Sonoscopia/Phobos/README.md

# PHOBOS
Code and instructional content.
Homepage is [here](https://sonoscopia.pt/en/works/phobos/) 

## Description
Phobos is a set of small robots and automatic music generation devices that form a Dysfunctional Robotic Orchestra, an orchestra with strange instruments with defects, genetic mutations and erratic behaviors.

Phobos represents a critique of the technological overlapping over human thought, the function of labor and modern forms of slavery, as well as an historical retrospective of the various attempts of human liberation through machines, its technological utopias, the advances and retreats of freedoms. Its name comes from Greek mythology, where Phobos is the incarnation of fear, and is also the name of the largest moon of Mars, doomed to disappear due to the proximity of its orbit to the planet. 

## Credits
- Conception and artistic direction: Gustavo Costa 
- New instruments by: Henrique Fernandes, Gustavo Costa, Alberto Lopes
- Guest musicians and instrument builders: Thierry Madiot, Vincent Martial and Hanna Hartman
- Programming and robotics: Tiago Ângelo and João Menezes
- Composition: Carlos Guedes, Rui Dias and José Alberto Gomes
- Cenography: Igor Gandra (Teatro de Ferro)
- Video: Miguel C. Tavares
- Executive production: Patrícia Caveiro
- Production: Sonoscopia
- Technical assistance: Digitópia
- Logistic support: Teatro de Ferro
- Project funded by Republica Portuguesa / Cultura and DGArtes
- Partners: GNRation, NYU Abu Dhabi, CCVF, Centro Cultural de Ílhavo and Festival Bons Sons

## LICENSE
[][cc-by-nc]

This work is licensed under a
[Creative Commons Attribution-NonCommercial 4.0 International License][cc-by-nc].

[][cc-by-nc]

[cc-by-nc]: https://creativecommons.org/licenses/by-nc/4.0/
[cc-by-nc-image]: https://licensebuttons.net/l/by-nc/4.0/88x31.png
[cc-by-nc-shield]: https://img.shields.io/badge/License-CC%20BY--NC%204.0-lightgrey.svg
