Sonoscopia/Phobos/Docs/MIDI&PWR connections.pdf

1 - 12Va
12VL - 3 | 2 - GND

5Vm - 4

# POWER

# MIDI (XLR)

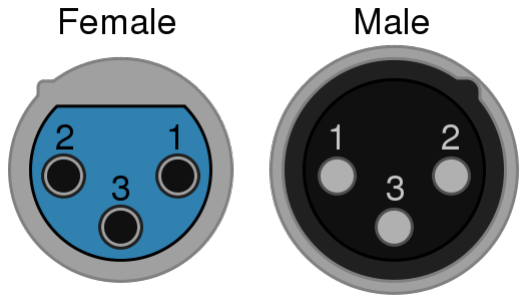
[picture p2: figure]

# MIDI (DIN)

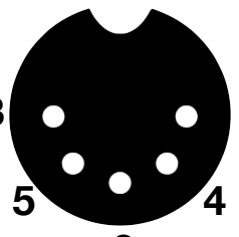
[picture p3: figure]

# MIDI OUT (DIN->XLR)

1 - GND
2 - 5V
3 - RX/TX

3

2

1

4 5

1

2

3

2 - GND
4 - 5V
5 - RX/TX

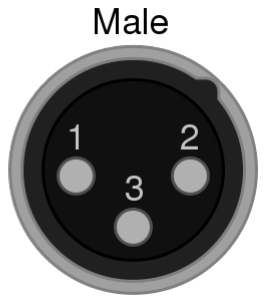
[picture p4: figure]

3

2

1

4 5

2 ——— GND ——— 1
4 ——— 5V ——— 2
5 ——— RX/TX ——— 3
