Sonoscopia/Phobos/MakeyMakey_serialMIDI/MakeyMakey_serialMIDI_middleware.app/Contents/support/init/jitter-objectlist.txt

max oblist "Jitter Analysis" jit.3m;
max oblist "Jitter Analysis" jit.bsort;
max oblist "Jitter Analysis" jit.change;
max oblist "Jitter Analysis" jit.findbounds;
max oblist "Jitter Analysis" jit.histogram;
max oblist "Jitter Analysis" jit.normalize;
max oblist "Jitter Analysis" jit.fft;
max oblist "Jitter Audio" jit.buffer~;
max oblist "Jitter Audio" jit.catch~;
max oblist "Jitter Audio" jit.peek~;
max oblist "Jitter Audio" jit.poke~;
max oblist "Jitter Audio" jit.release~;
max oblist "Jitter Audio" spigot~;
max oblist "Jitter Blur/Sharpen" jit.avg4;
max oblist "Jitter Blur/Sharpen" jit.brass;
max oblist "Jitter Blur/Sharpen" jit.convolve;
max oblist "Jitter Blur/Sharpen" jit.fastblur;
max oblist "Jitter Blur/Sharpen" jit.robcross;
max oblist "Jitter Blur/Sharpen" jit.sobel;
max oblist "Jitter Blur/Sharpen" jit.wake;
max oblist "Jitter Colorspace" jit.argb2ayuv;
max oblist "Jitter Colorspace" jit.argb2grgb;
max oblist "Jitter Colorspace" jit.argb2uyvy;
max oblist "Jitter Colorspace" jit.ayuv2argb;
max oblist "Jitter Colorspace" jit.ayuv2luma;
max oblist "Jitter Colorspace" jit.ayuv2uyvy;
max oblist "Jitter Colorspace" jit.brcosa;
max oblist "Jitter Colorspace" jit.colorspace;
max oblist "Jitter Colorspace" jit.grgb2argb;
max oblist "Jitter Colorspace" jit.hsl2rgb;
max oblist "Jitter Colorspace" jit.hue;
max oblist "Jitter Colorspace" jit.luma2uyvy;
max oblist "Jitter Colorspace" jit.luma2ayuv;
max oblist "Jitter Colorspace" jit.rgb2hsl;
max oblist "Jitter Colorspace" jit.rgb2luma;
max oblist "Jitter Colorspace" jit.traffic;
max oblist "Jitter Colorspace" jit.uyvy2argb;
max oblist "Jitter Colorspace" jit.uyvy2ayuv;
max oblist "Jitter Colorspace" jit.uyvy2luma;
max oblist "Jitter Compositing" jit.alphablend;
max oblist "Jitter Compositing" jit.chromakey;
max oblist "Jitter Compositing" jit.keyscreen;
max oblist "Jitter Compositing" jit.lumakey;
max oblist "Jitter Compositing" jit.op;
max oblist "Jitter Compositing" jit.shade;
max oblist "Jitter Compositing" jit.xfade;
max oblist "Jitter Data" jit.concat;
max oblist "Jitter Data" jit.coerce;
max oblist "Jitter Data" jit.demultiplex;
max oblist "Jitter Data" jit.dimmap;
max oblist "Jitter Data" jit.glue;
max oblist "Jitter Data" jit.matrix;
max oblist "Jitter Data" jit.matrixset;
max oblist "Jitter Data" jit.matrixinfo;
max oblist "Jitter Data" jit.multiplex;
max oblist "Jitter Data" jit.pack;
max oblist "Jitter Data" jit.scissors;
max oblist "Jitter Data" jit.split;
max oblist "Jitter Data" jit.submatrix;
max oblist "Jitter Data" jit.unpack;
max oblist "Jitter Data" jit.thin;
max oblist "Jitter Devices" jit.avc;
max oblist "Jitter Devices" jit.desktop;
max oblist "Jitter Devices" jit.displays;
max oblist "Jitter Devices" jit.dx.videoout;
max oblist "Jitter Devices" jit.qt.videoout;
max oblist "Jitter Generators" jit.bfg;
max oblist "Jitter Generators" jit.desktop;
max oblist "Jitter Generators" jit.dx.grab;
max oblist "Jitter Generators" jit.gencoord;
max oblist "Jitter Generators" jit.gradient;
max oblist "Jitter Generators" jit.graph;
max oblist "Jitter Generators" jit.lcd;
max oblist "Jitter Generators" jit.noise;
max oblist "Jitter Generators" jit.plot;
max oblist "Jitter Generators" jit.qt.grab;
max oblist "Jitter Generators" jit.qt.movie;
max oblist "Jitter Lists" jit.fill;
max oblist "Jitter Lists" jit.iter;
max oblist "Jitter Lists" jit.spill;
max oblist "Jitter Math" jit.charmap;
max oblist "Jitter Math" jit.clip;
max oblist "Jitter Math" jit.conway;
max oblist "Jitter Math" jit.expr;
max oblist "Jitter Math" jit.la.determinant;
max oblist "Jitter Math" jit.la.diagproduct;
max oblist "Jitter Math" jit.la.inverse;
max oblist "Jitter Math" jit.la.mult;
max oblist "Jitter Math" jit.la.trace;
max oblist "Jitter Math" jit.la.uppertri;
max oblist "Jitter Math" jit.linden;
max oblist "Jitter Math" jit.map;
max oblist "Jitter Math" jit.op;
max oblist "Jitter Math" jit.scalebias;
max oblist "Jitter Math" jit.transpose;
max oblist "Jitter Networking" jit.broadcast;
max oblist "Jitter Networking" jit.net.send;
max oblist "Jitter Networking" jit.net.recv;
max oblist "Jitter Networking" jit.qt.broadcast;
max oblist "Jitter OpenGL" jit.gl.asyncread;
max oblist "Jitter OpenGL" jit.gl.cubemap;
max oblist "Jitter OpenGL" jit.gl.gridshape;
max oblist "Jitter OpenGL" jit.gl.graph;
max oblist "Jitter OpenGL" jit.gl.handle;
max oblist "Jitter OpenGL" jit.gl.isosurf;
max oblist "Jitter OpenGL" jit.gl.imageunit;
max oblist "Jitter OpenGL" jit.gl.mesh;
max oblist "Jitter OpenGL" jit.gl.model;
max oblist "Jitter OpenGL" jit.gl.multiple;
max oblist "Jitter OpenGL" jit.gl.nurbs;
max oblist "Jitter OpenGL" jit.gl.plato;
max oblist "Jitter OpenGL" jit.gl.render;
max oblist "Jitter OpenGL" jit.gl.shader;
max oblist "Jitter OpenGL" jit.gl.sketch;
max oblist "Jitter OpenGL" jit.gl.slab;
max oblist "Jitter OpenGL" jit.gl.text2d;
max oblist "Jitter OpenGL" jit.gl.text3d;
max oblist "Jitter OpenGL" jit.gl.texture;
max oblist "Jitter OpenGL" jit.gl.videoplane;
max oblist "Jitter OpenGL" jit.gl.volume;
max oblist "Jitter Particles" jit.p.bounds;
max oblist "Jitter Particles" jit.p.shiva;
max oblist "Jitter Particles" jit.p.vishnu;
max oblist "Jitter QuickTime" jit.qt.broadcast;
max oblist "Jitter QuickTime" jit.qt.effect;
max oblist "Jitter QuickTime" jit.qt.grab;
max oblist "Jitter QuickTime" jit.qt.movie;
max oblist "Jitter QuickTime" jit.qt.record;
max oblist "Jitter QuickTime" jit.qt.videoout;
max oblist "Jitter QuickTime" jit.vcr;
max oblist "Jitter Spatial" jit.mxform2d;
max oblist "Jitter Spatial" jit.plume;
max oblist "Jitter Spatial" jit.rota;
max oblist "Jitter Spatial" jit.rubix;
max oblist "Jitter Spatial" jit.repos;
max oblist "Jitter Spatial" jit.resamp;
max oblist "Jitter Spatial" jit.sprinkle;
max oblist "Jitter Special FX" jit.altern;
max oblist "Jitter Special FX" jit.ameba;
max oblist "Jitter Special FX" jit.brcosa;
max oblist "Jitter Special FX" jit.eclipse;
max oblist "Jitter Special FX" jit.fluoride;
max oblist "Jitter Special FX" jit.freeframe;
max oblist "Jitter Special FX" jit.glop;
max oblist "Jitter Special FX" jit.hatch;
max oblist "Jitter Special FX" jit.plur;
max oblist "Jitter Special FX" jit.qt.effect;
max oblist "Jitter Special FX" jit.roy;
max oblist "Jitter Special FX" jit.scanoffset;
max oblist "Jitter Special FX" jit.scanslide;
max oblist "Jitter Special FX" jit.scanwrap;
max oblist "Jitter Special FX" jit.slide;
max oblist "Jitter Special FX" jit.streak;
max oblist "Jitter Special FX" jit.tiffany;
max oblist "Jitter Special FX" jit.wake;
max oblist "Jitter Strings" jit.str.fromsymbol;
max oblist "Jitter Strings" jit.str.op;
max oblist "Jitter Strings" jit.str.regexp;
max oblist "Jitter Strings" jit.str.tosymbol;
max oblist "Jitter Strings" jit.textfile;
max oblist "Jitter UI" jit.cellblock;
max oblist "Jitter UI" jit.fpsgui;
max oblist "Jitter UI" jit.pwindow;
max oblist "Jitter UI" jit.window;
max oblist "Jitter UI" jit.scope;
max oblist "Jitter Utilities" jit.cycle;
max oblist "Jitter Utilities" jit.fprint;
max oblist "Jitter Utilities" jit.obref;
max oblist "Jitter Utilities" jit.openexr;
max oblist "Jitter Utilities" jit.print;
max oblist "Jitter Utilities" jit.qball;
max oblist "Jitter Utilities" jit.reverse;
max oblist "Jitter Utilities" jit.turtle;
max oblist "Jitter Utilities" jit.uldl;
max oblist "Jitter Utilities" jit.qfaker;
