Sonoscopia/Phobos/Boards and Schematics/EnsembleEight/EnsembleEight_schematics.pdf

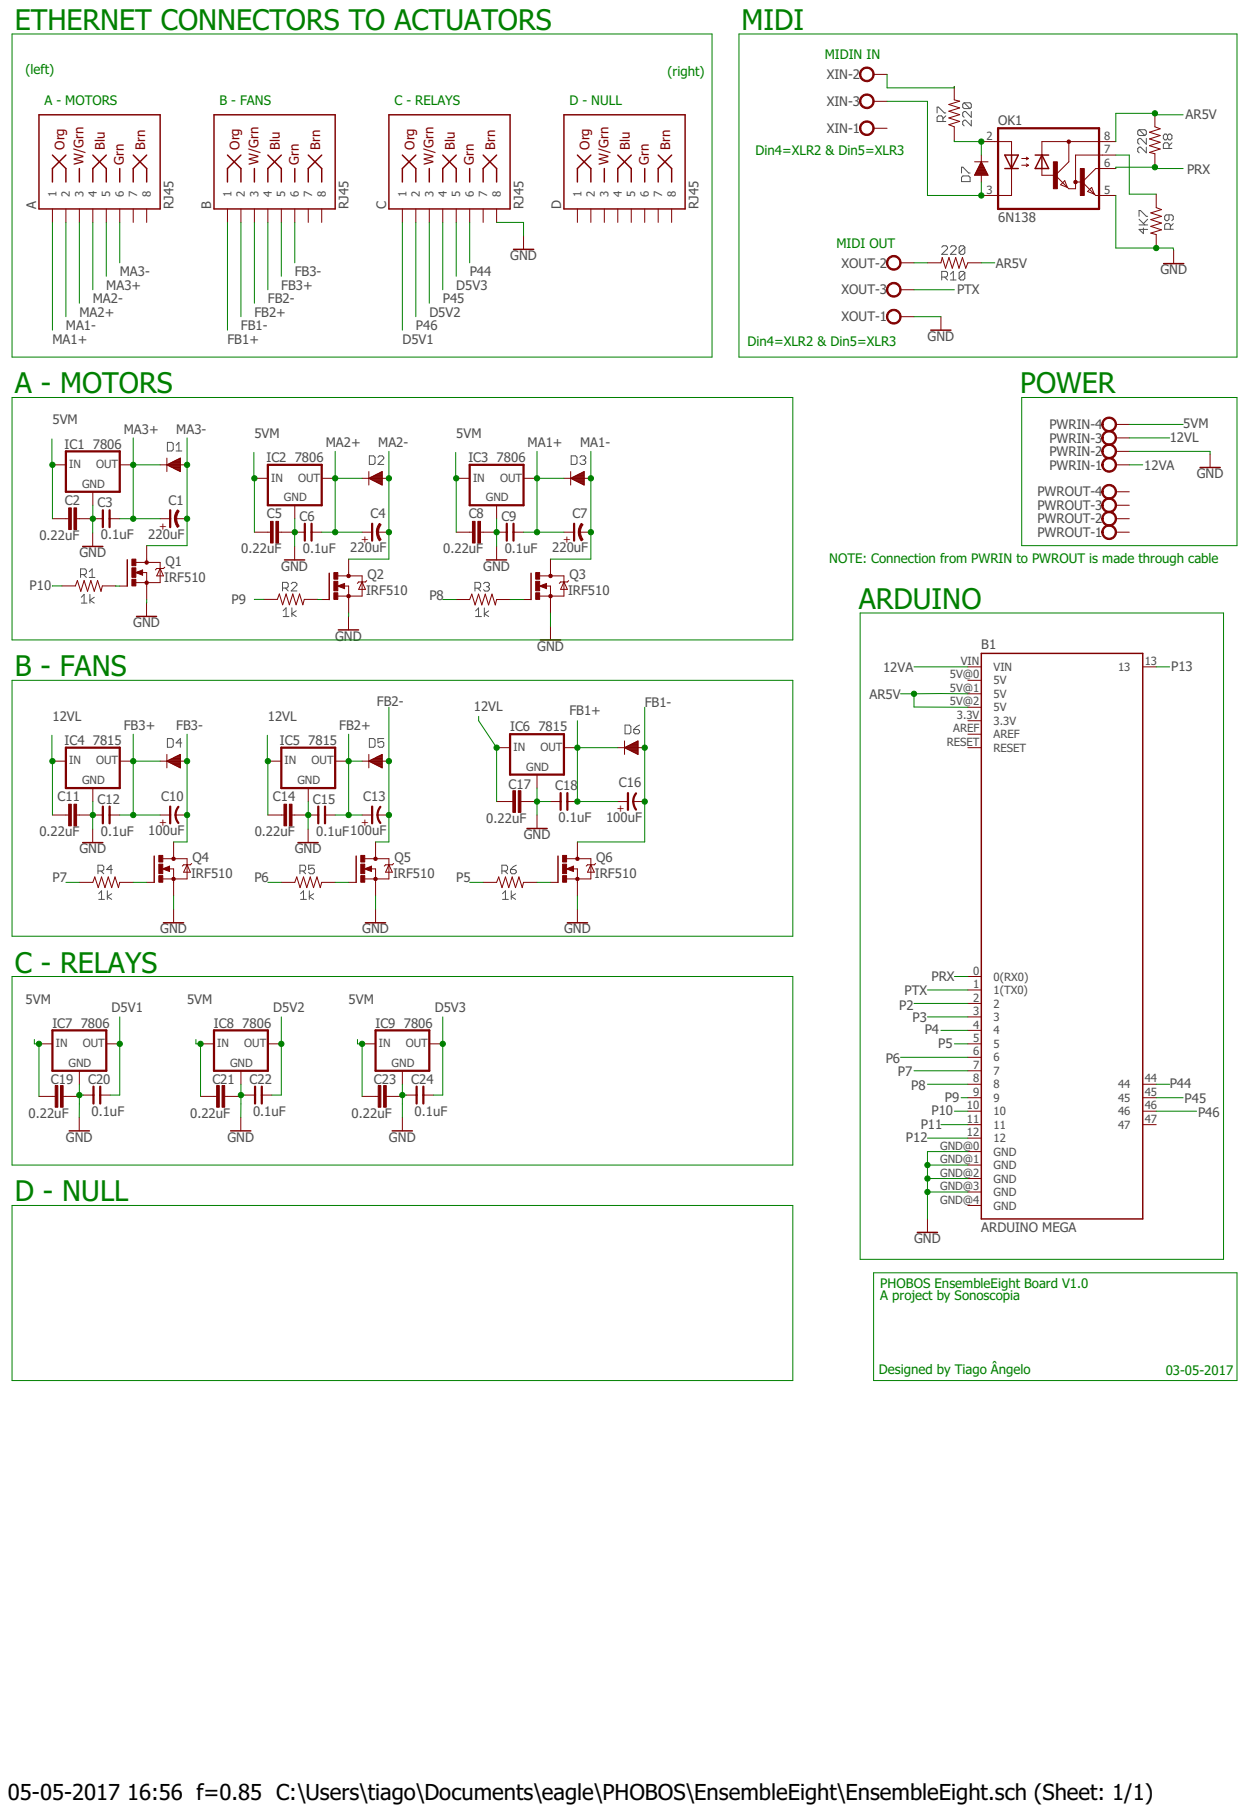
[picture p5: page 1]

ETHERNET CONNECTORS TO ACTUATORS

rg Blu Brn W/Grn Grn +

rg Blu Brn W/Grn Gr

Org Blu Brn W/Grn Gr

PWRIN-1 PWRIN-2 PWRIN-3 PWRIN-4

PWROUT-1 PWROUT-2 PWROUT-3 PWROUT-4

NOTE: Connection from PWRIN to PWROUT is made through cable
ARDUINO

PHOBOS EnsembleEight Board V1.0 Designed by Tiago Ângelo

05-05-2017 16:56 f=0.85 C:\Users\tiago\Documents\eagle\PHOBOS\EnsembleEight\EnsembleEight.sch (Sheet: 1/1)
