Sonoscopia/Phobos/Boards and Schematics/EnsembleFive/EnsembleFive_schematics.pdf

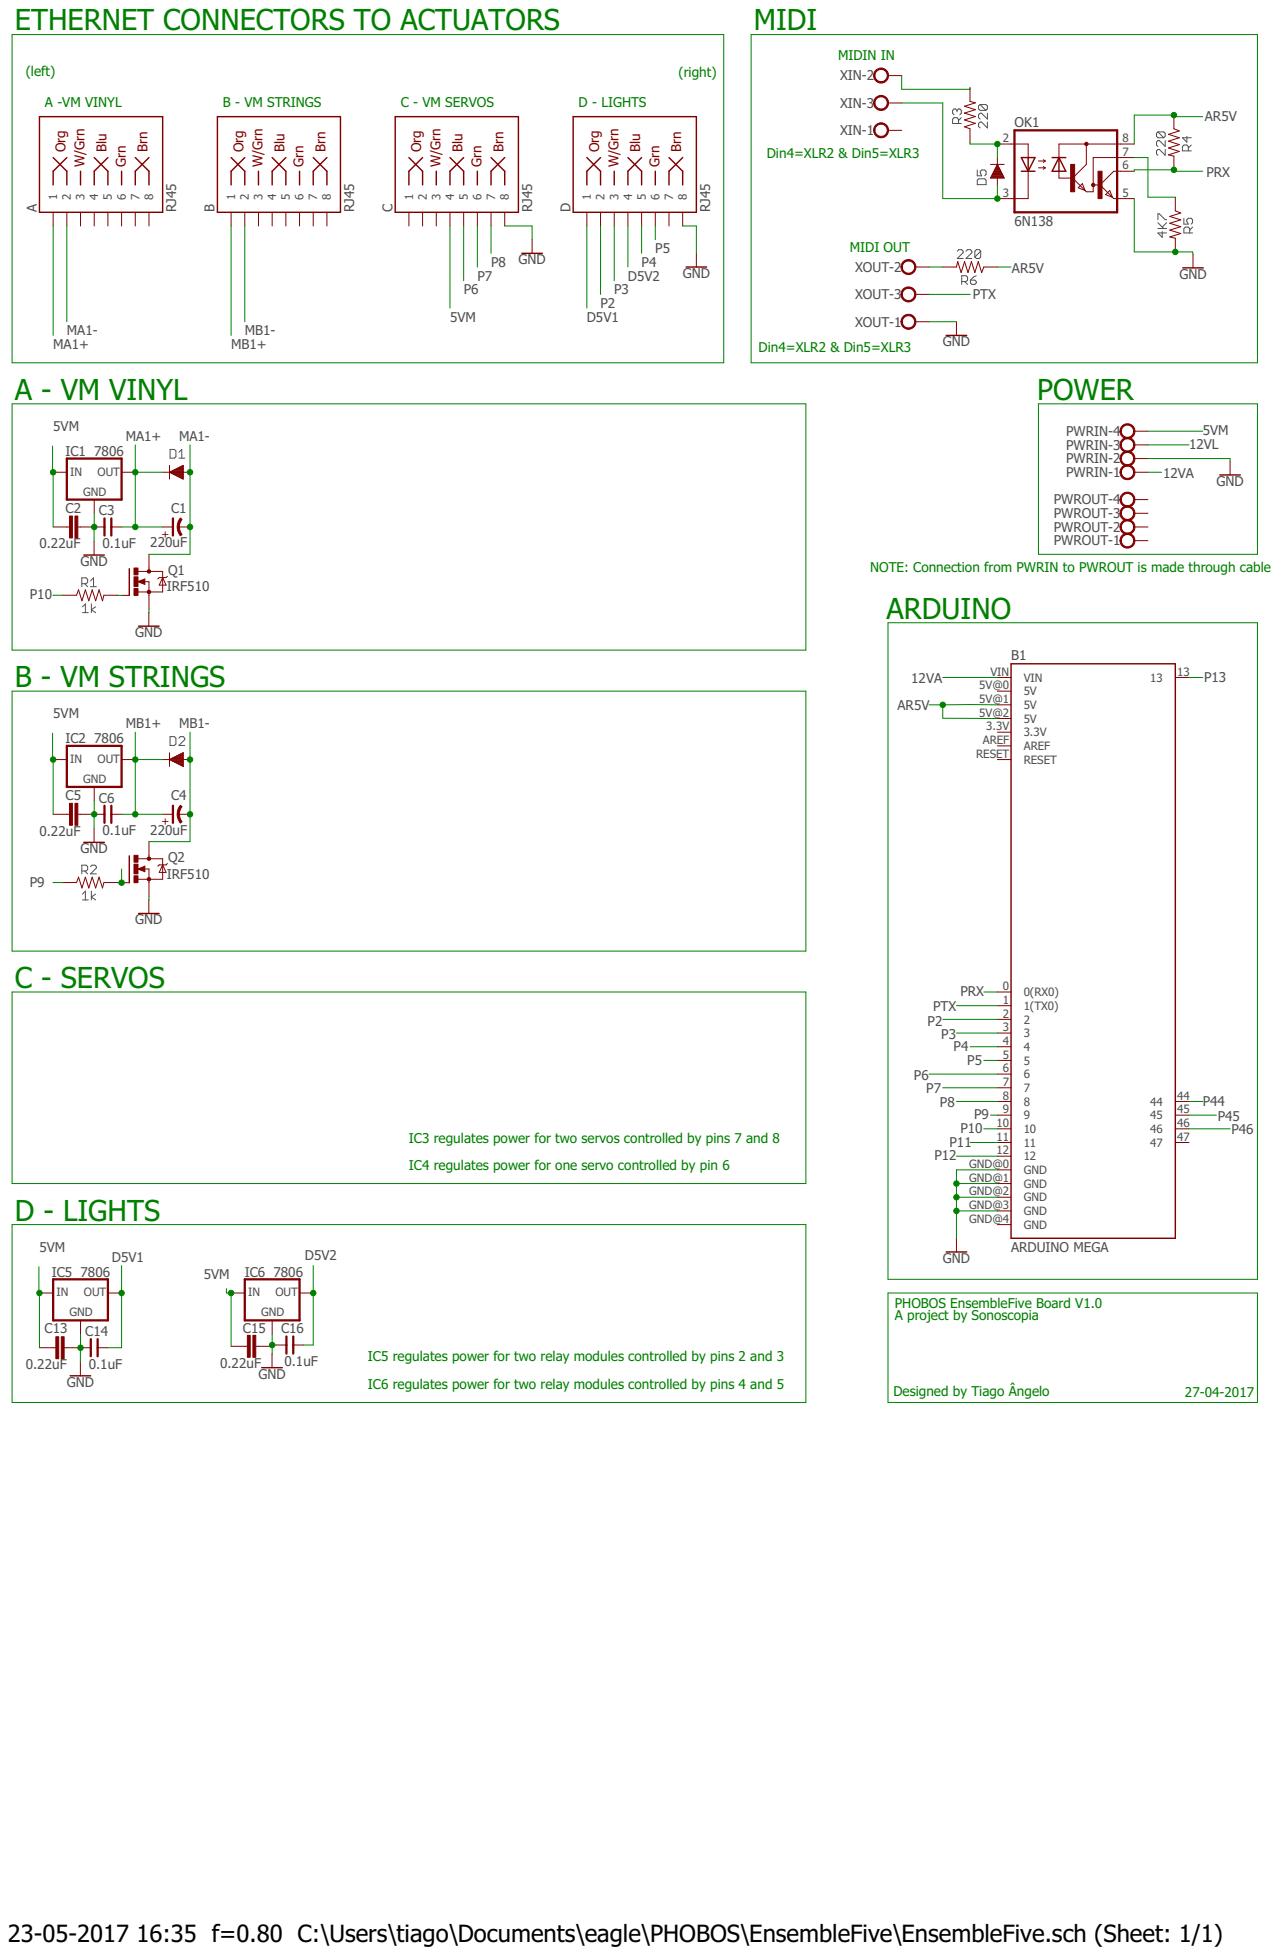
[picture p6: page 1]

ETHERNET CONNECTORS TO ACTUATORS

rg Blu Brn W/Grn Grn +

rg Blu Brn W/Grn Gr

Org Blu Brn W/Grn Gr

PWRIN-1 PWRIN-2 PWRIN-3 PWRIN-4

PWROUT-1 PWROUT-2 PWROUT-3 PWROUT-4

NOTE: Connection from PWRIN to PWROUT is made through cable
ARDUINO

IC3 regulates power for two servos controlled by pins 7 and 8

IC4 regulates power for one servo controlled by pin 6

PHOBOS EnsembleFive Board V1.0 Designed by Tiago Ângelo

IC5 regulates power for two relay modules controlled by pins 2 and 3

IC6 regulates power for two relay modules controlled by pins 4 and 5

23-05-2017 16:35 f=0.80 C:\Users\tiago\Documents\eagle\PHOBOS\EnsembleFive\EnsembleFive.sch (Sheet: 1/1)
