Sonoscopia/Phobos/Boards and Schematics/EnsembleFour/EnsembleFour_schematic.pdf

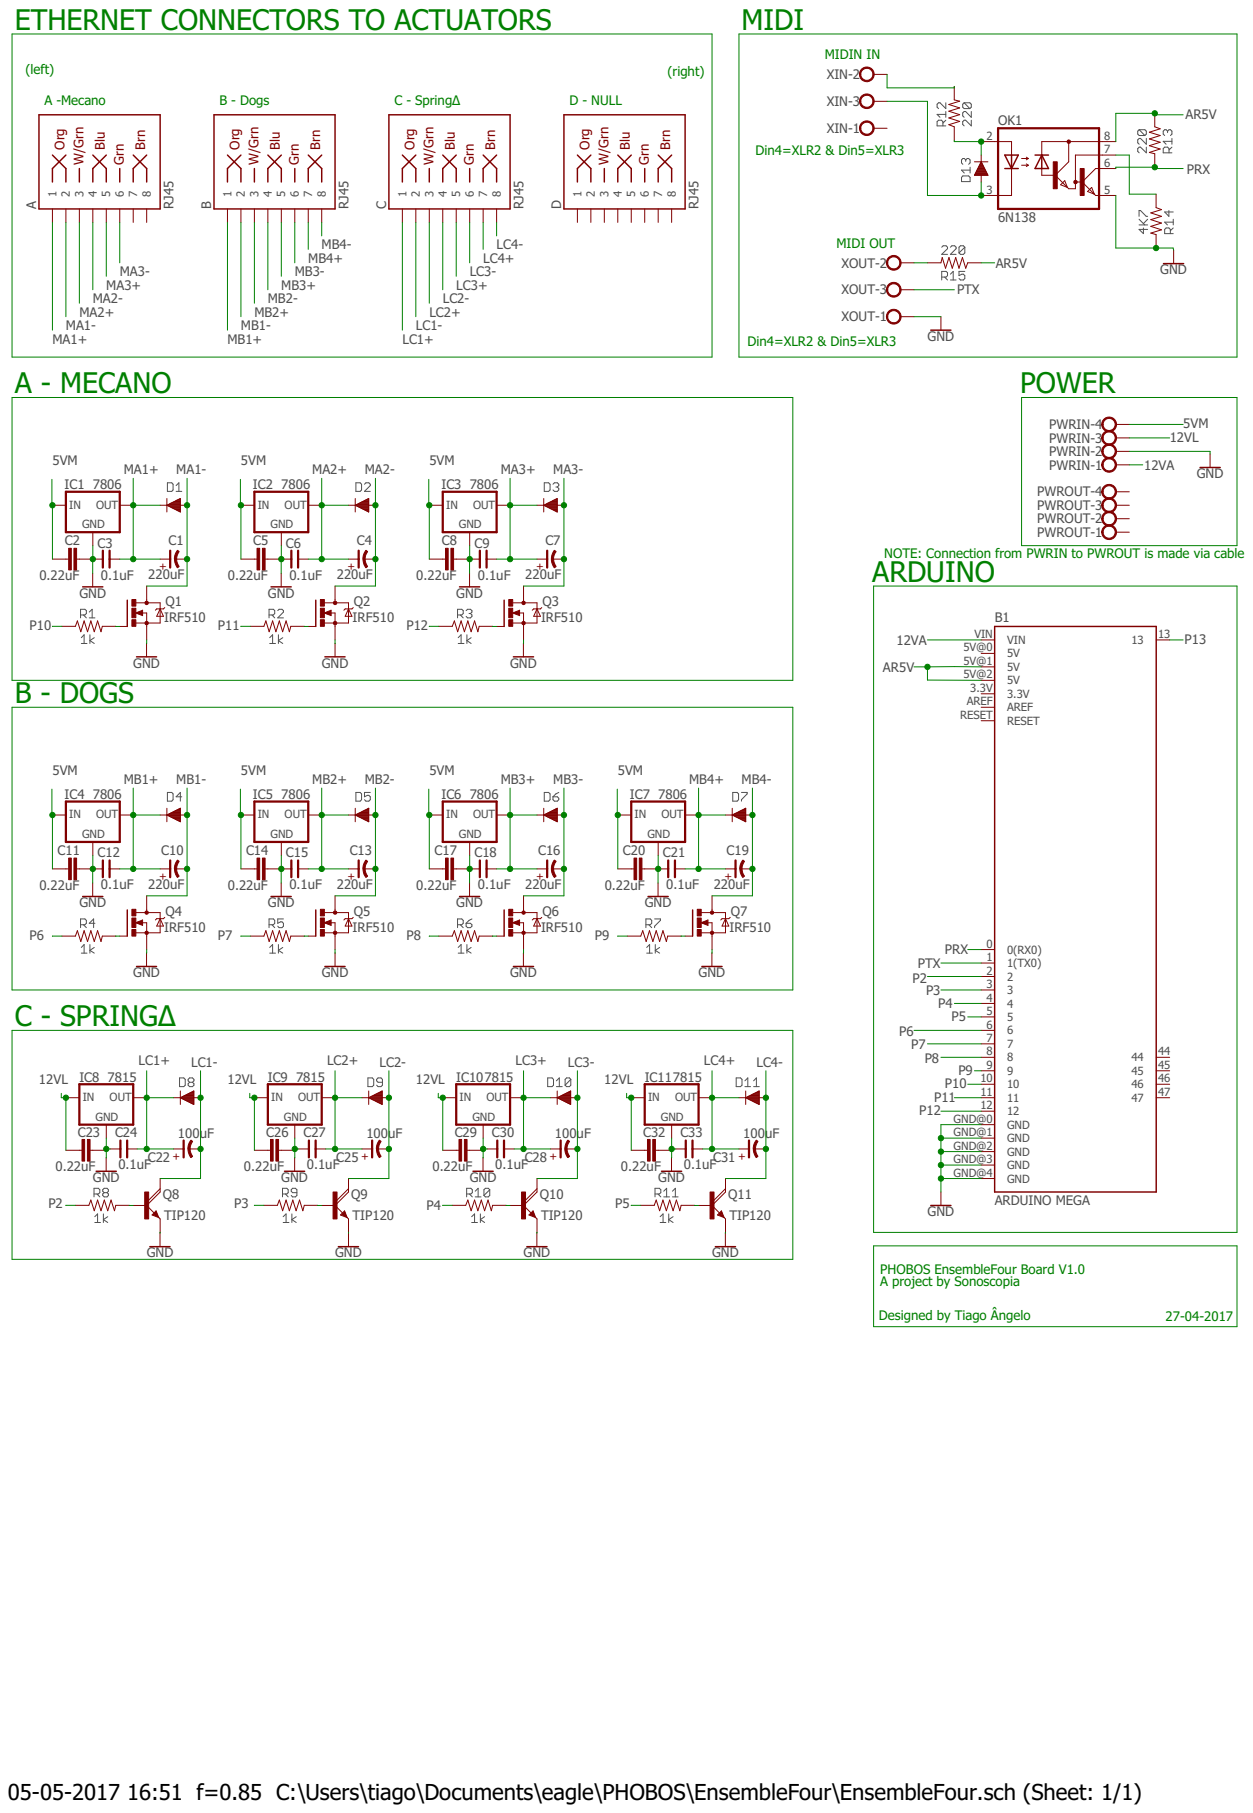
[picture p7: page 1]

ETHERNET CONNECTORS TO ACTUATORS

rg Blu Brn W/Grn Grn +

rg Blu Brn W/Grn Gr

Org Blu Brn W/Grn Gr

PWRIN-1 PWRIN-2 PWRIN-3 PWRIN-4

PWROUT-1 PWROUT-2 PWROUT-3 PWROUT-4 Q2

NOTE: Connection from PWRIN to PWROUT is made via cable
ARDUINO

05-05-2017 16:51 f=0.85 C:\Users\tiago\Documents\eagle\PHOBOS\EnsembleFour\EnsembleFour.sch (Sheet: 1/1)
