Sonoscopia/Phobos/Boards and Schematics/EnsembleNine/EnsembleNine_schematics.pdf

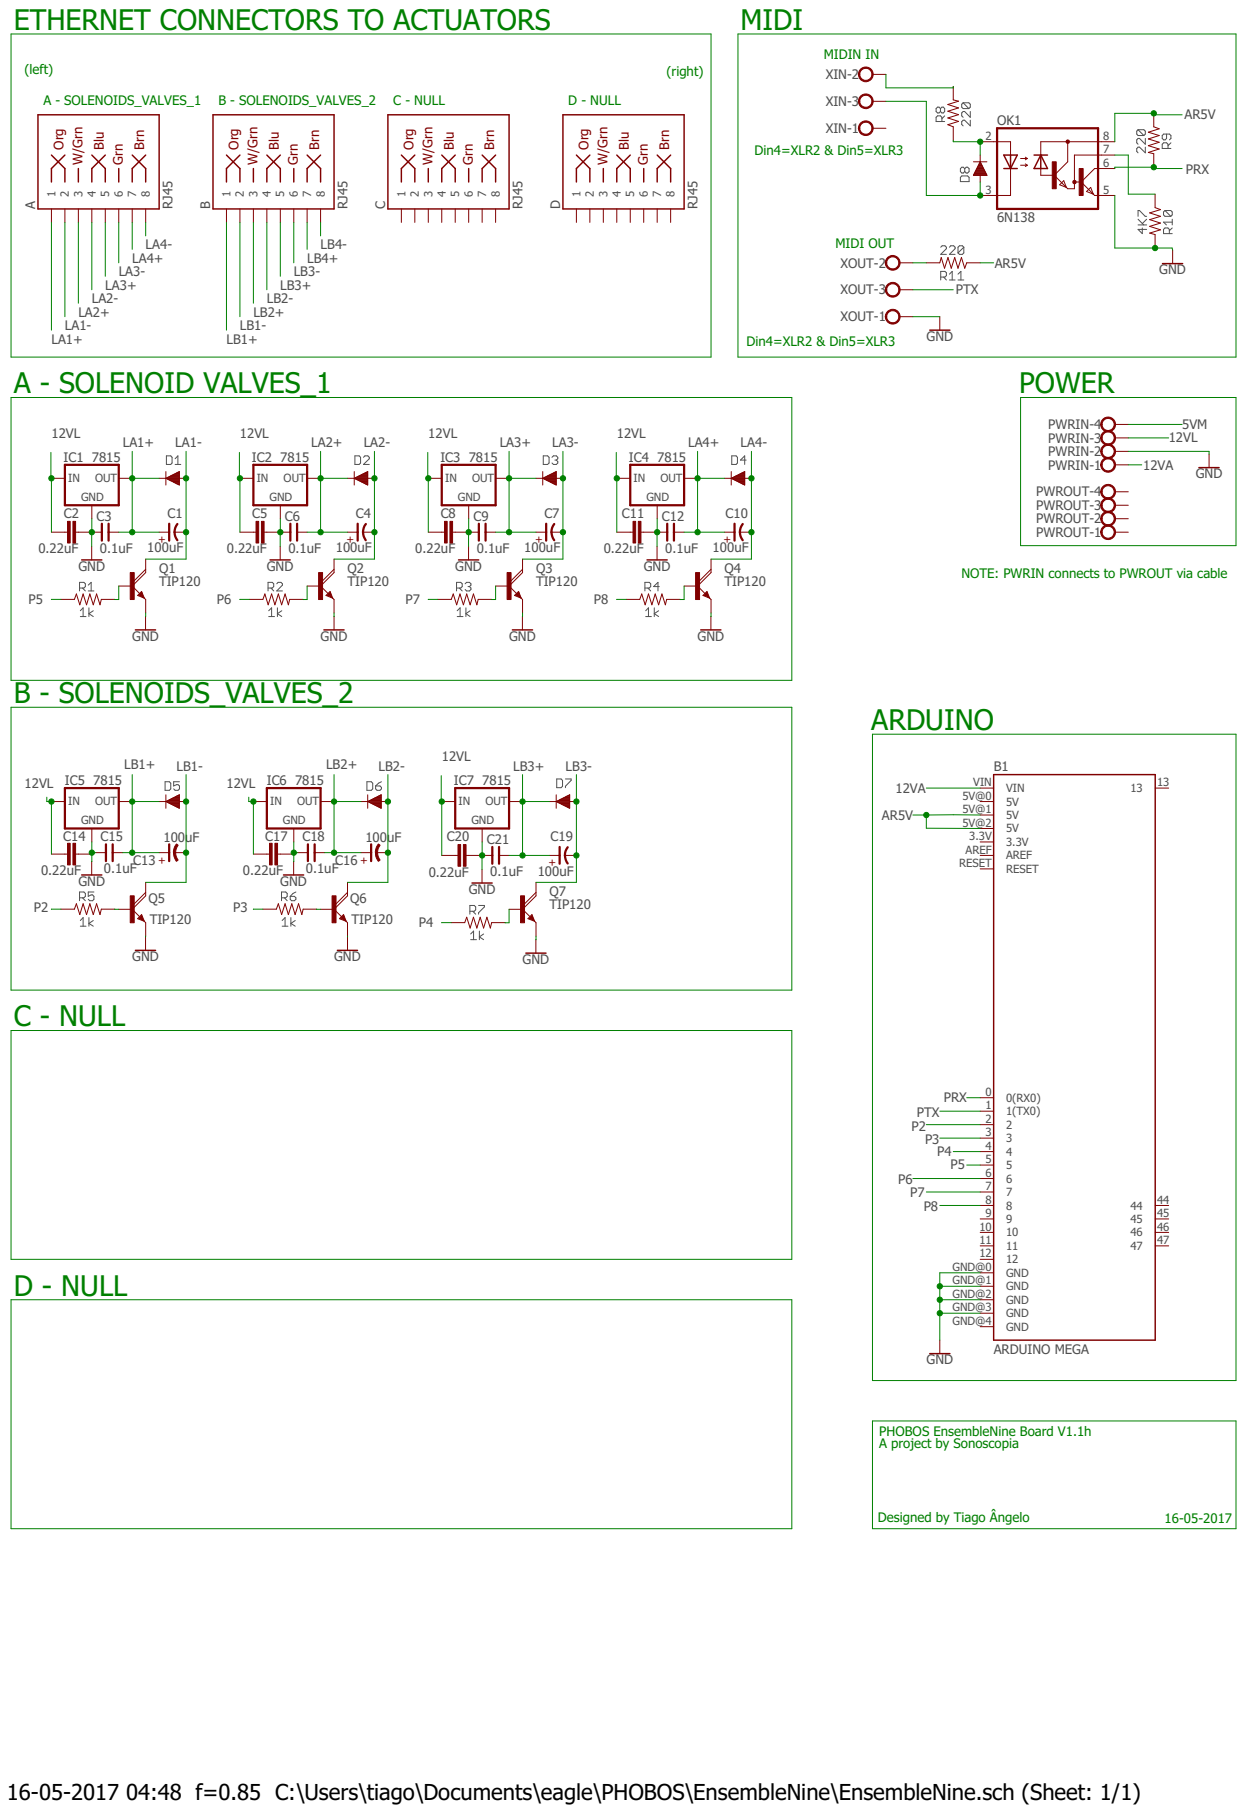
[picture p8: page 1]

ETHERNET CONNECTORS TO ACTUATORS

rg Blu Brn W/Grn Grn

rg Blu Brn W/Grn Gr

Org Blu Brn W/Grn Gr

PWRIN-1 PWRIN-2 PWRIN-3 PWRIN-4

PWROUT-1 PWROUT-2 PWROUT-3 PWROUT-4 GND

NOTE: PWRIN connects to PWROUT via cable

PHOBOS EnsembleNine Board V1.1h Designed by Tiago Ângelo

16-05-2017 04:48 f=0.85 C:\Users\tiago\Documents\eagle\PHOBOS\EnsembleNine\EnsembleNine.sch (Sheet: 1/1)
