Sonoscopia/Phobos/Boards and Schematics/EnsembleOne/EnsembleOne_schematic.pdf

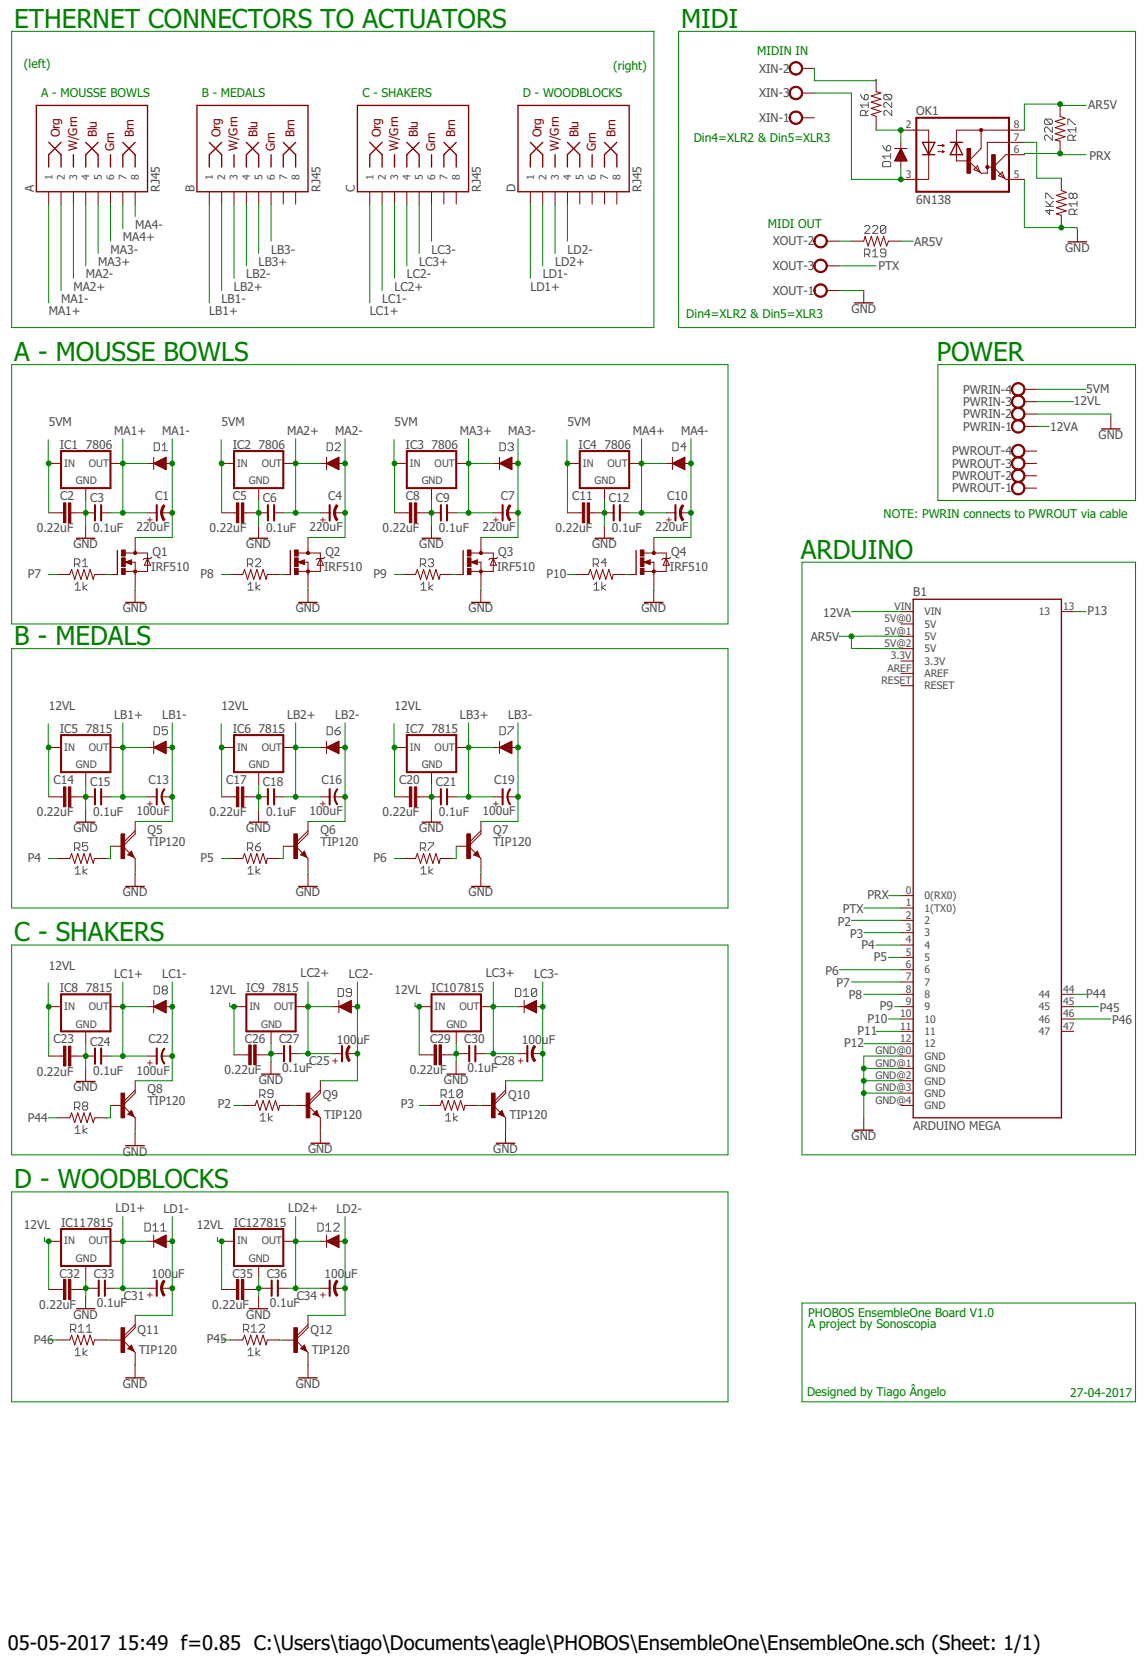
[picture p9: page 1]

ETHERNET CONNECTORS TO ACTUATORS

rg Blu Brn W/Grn Grn +

rg Blu Brn W/Grn Gr

Org Blu Brn W/Grn Gr

PWRIN-1 PWRIN-2 PWRIN-3 PWRIN-4

PWROUT-1 PWROUT-2 PWROUT-3 PWROUT-4 Q2

NOTE: PWRIN connects to PWROUT via cable

PHOBOS EnsembleOne Board V1.0 Designed by Tiago Ângelo

05-05-2017 15:49 f=0.85 C:\Users\tiago\Documents\eagle\PHOBOS\EnsembleOne\EnsembleOne.sch (Sheet: 1/1)
