Sonoscopia/Phobos/Boards and Schematics/EnsembleSeven/EnsembleSeven_schematics.pdf

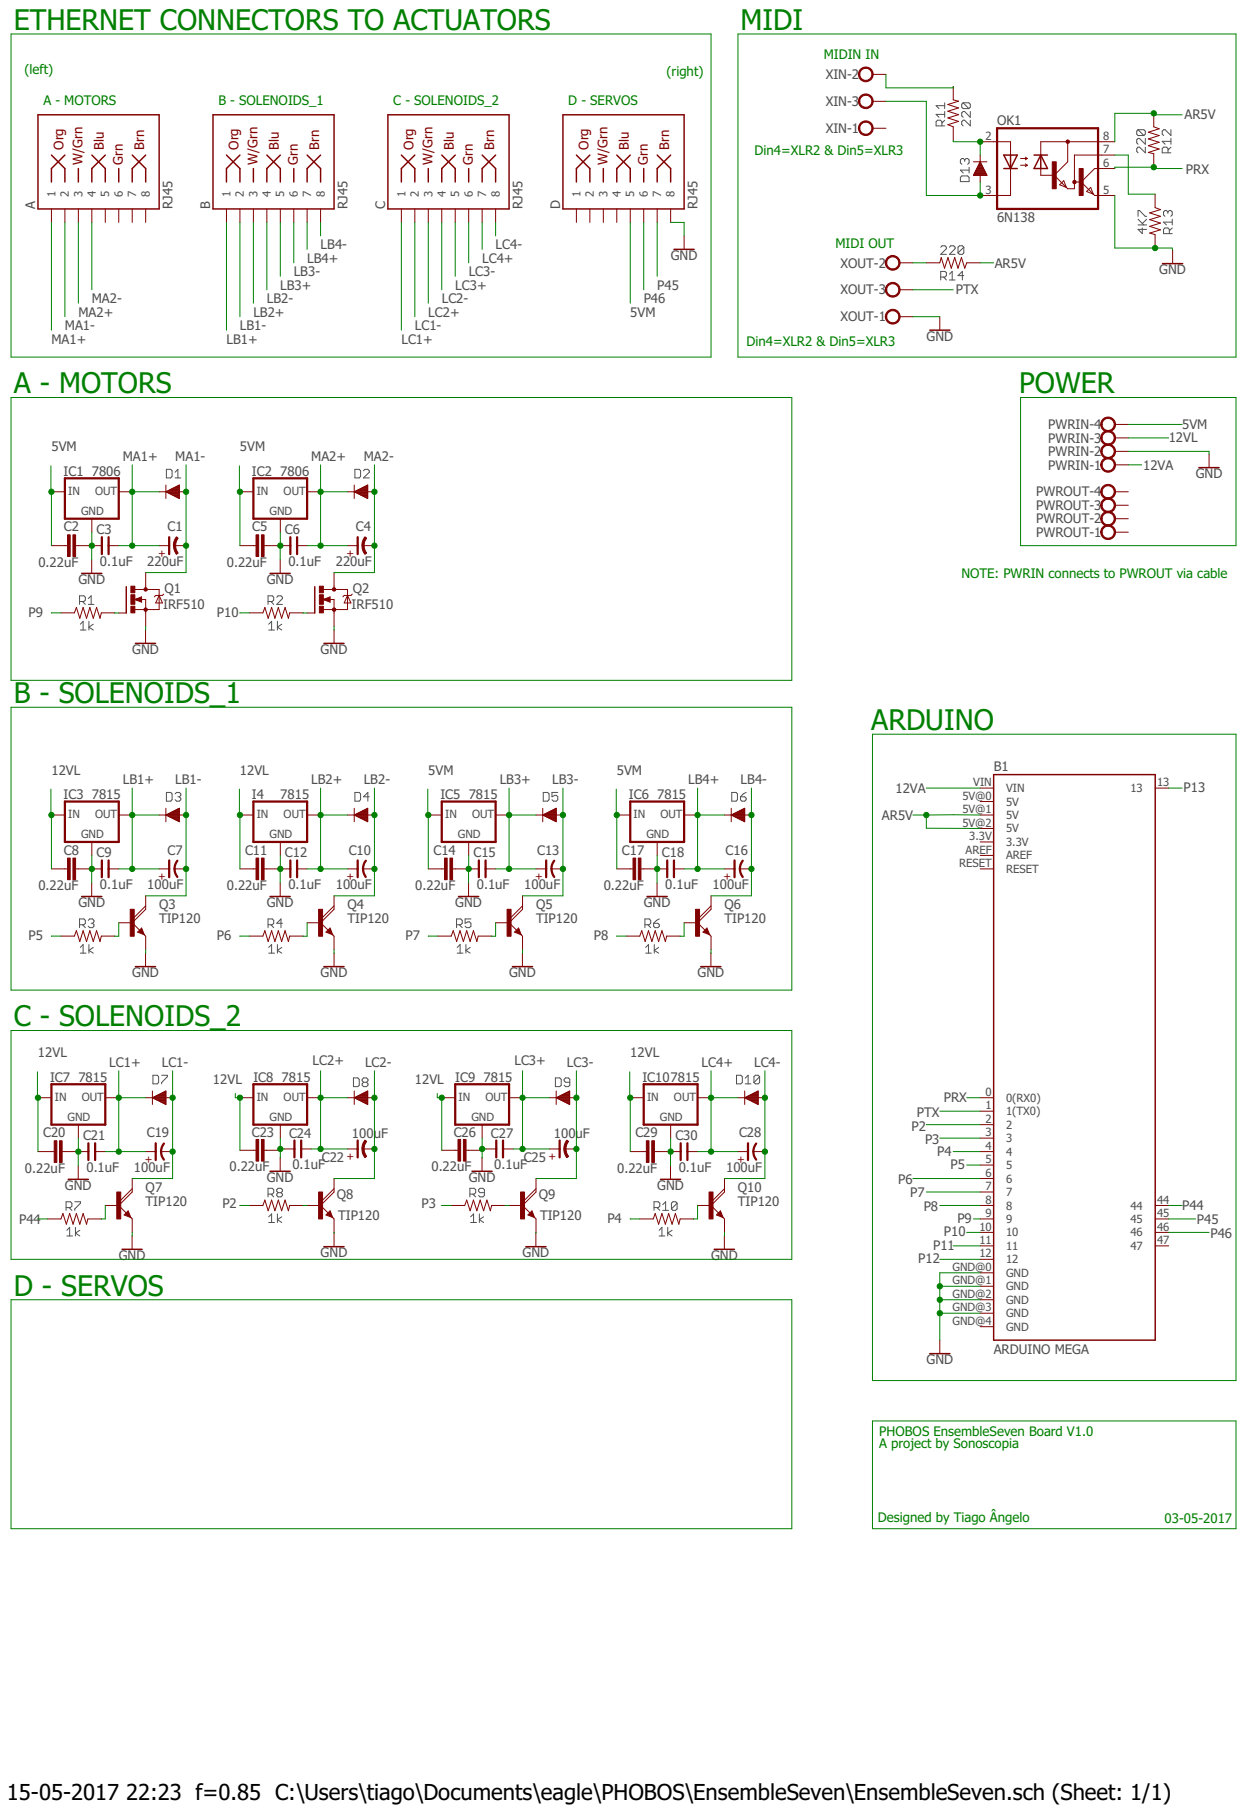
[picture p10: page 1]

ETHERNET CONNECTORS TO ACTUATORS

rg Blu Brn W/Grn Grn

rg Blu Brn W/Grn Gr

Org Blu Brn W/Grn Gr

PWRIN-1 PWRIN-2 PWRIN-3 PWRIN-4

PWROUT-1 PWROUT-2 PWROUT-3 PWROUT-4

NOTE: PWRIN connects to PWROUT via cable

PHOBOS EnsembleSeven Board V1.0 Designed by Tiago Ângelo

15-05-2017 22:23 f=0.85 C:\Users\tiago\Documents\eagle\PHOBOS\EnsembleSeven\EnsembleSeven.sch (Sheet: 1/1)
