Sonoscopia/Phobos/Boards and Schematics/EnsembleSix/EnsembleSix_schematics.pdf

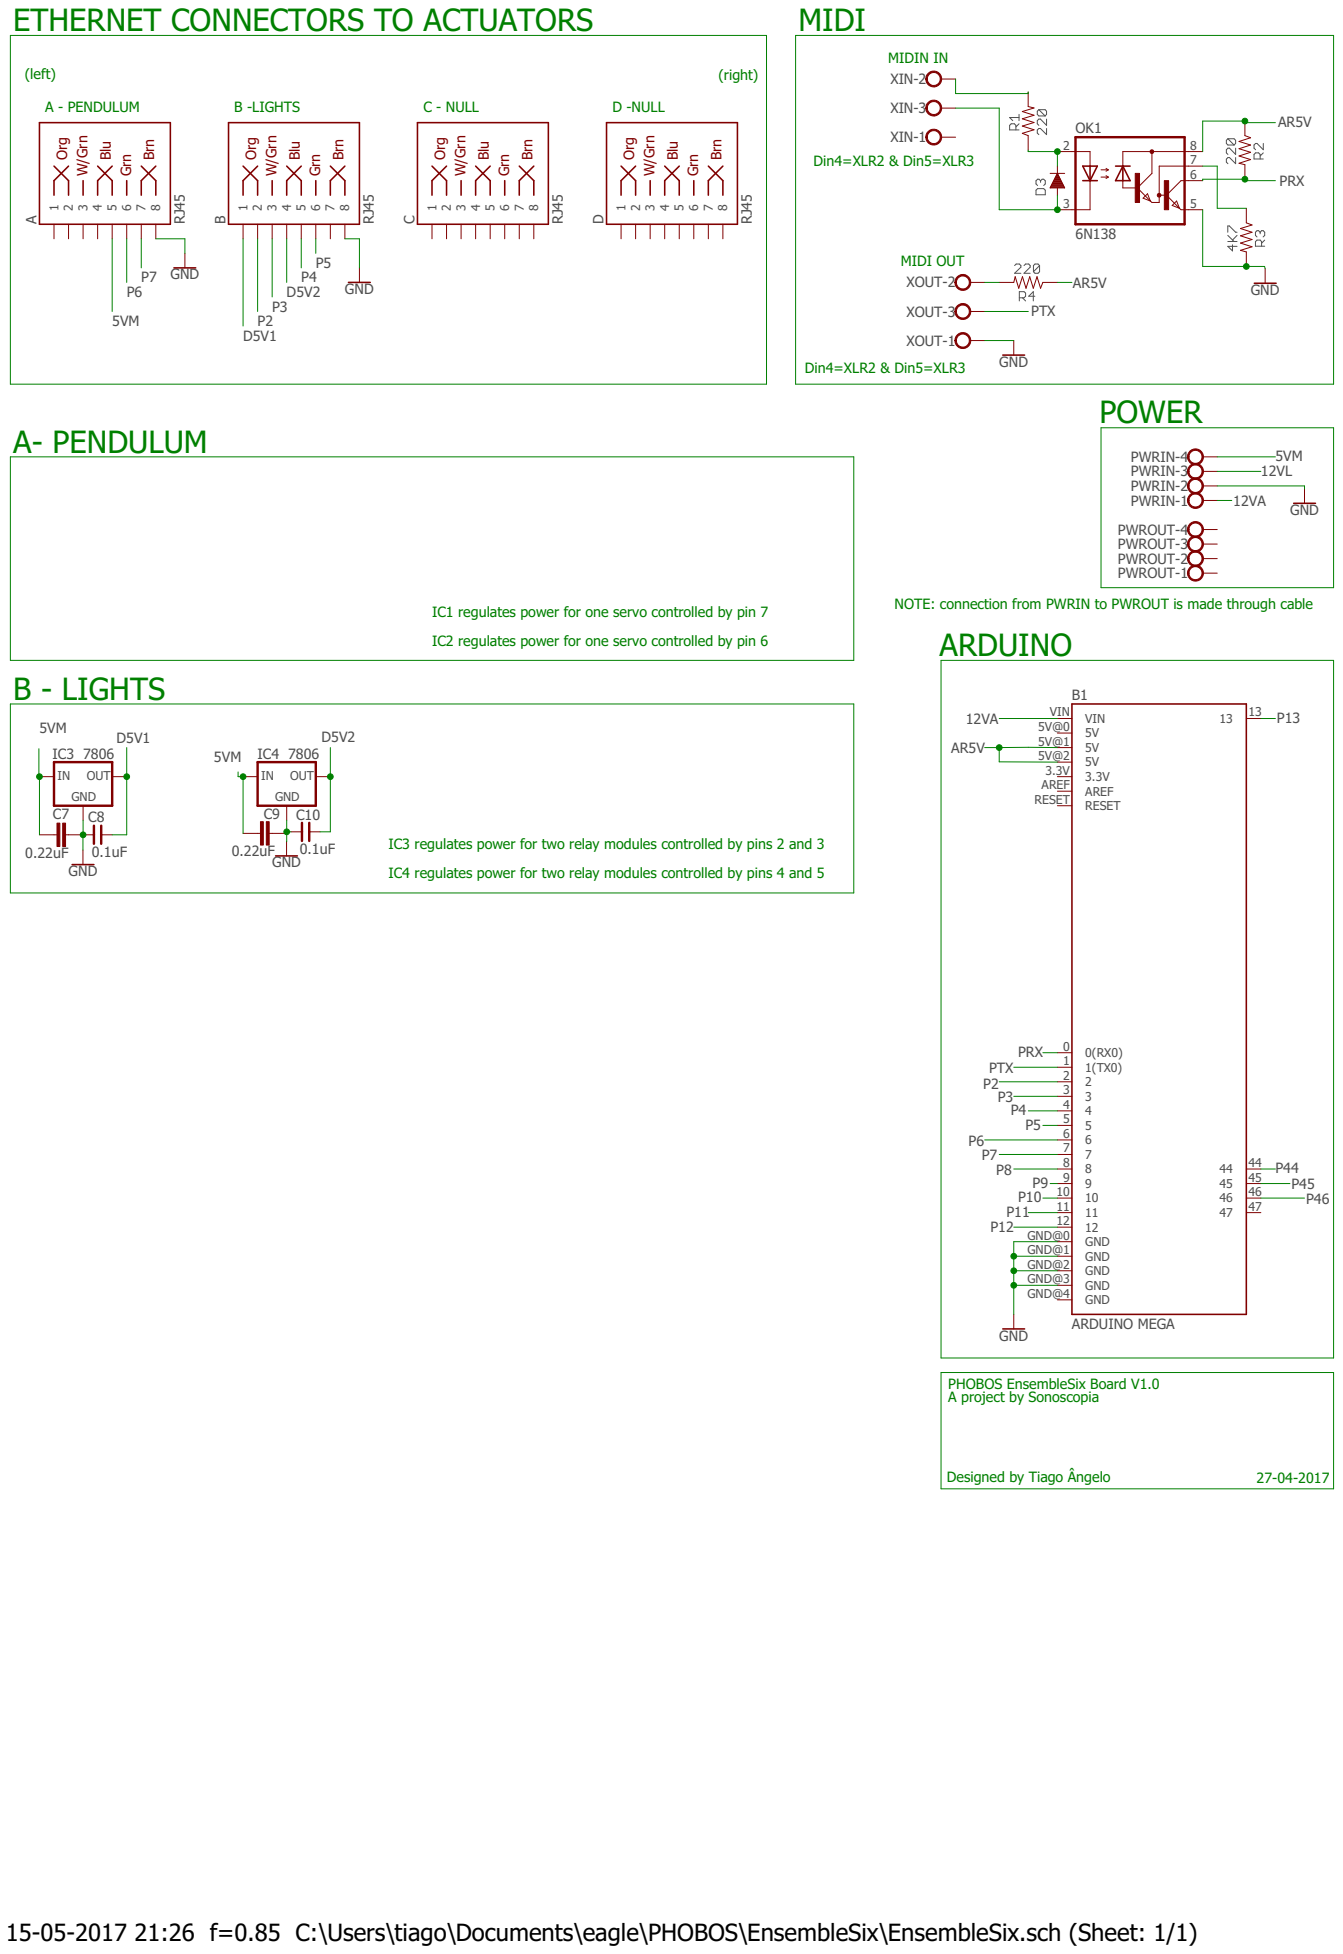
[picture p11: page 1]

ETHERNET CONNECTORS TO ACTUATORS

rg Blu Brn W/Grn Grn

rg Blu Brn W/Grn Gr

Org Blu Brn W/Grn Gr

PWRIN-1 PWRIN-2 PWRIN-3 PWRIN-4

PWROUT-1 PWROUT-2 PWROUT-3 PWROUT-4

IC1 regulates power for one servo controlled by pin 7

NOTE: connection from PWRIN to PWROUT is made through cable
ARDUINO

IC2 regulates power for one servo controlled by pin 6

IC3 regulates power for two relay modules controlled by pins 2 and 3

IC4 regulates power for two relay modules controlled by pins 4 and 5

PHOBOS EnsembleSix Board V1.0 Designed by Tiago Ângelo

15-05-2017 21:26 f=0.85 C:\Users\tiago\Documents\eagle\PHOBOS\EnsembleSix\EnsembleSix.sch (Sheet: 1/1)
