Sonoscopia/Phobos/Boards and Schematics/EnsembleThree/EnsembleThree_schematics.pdf

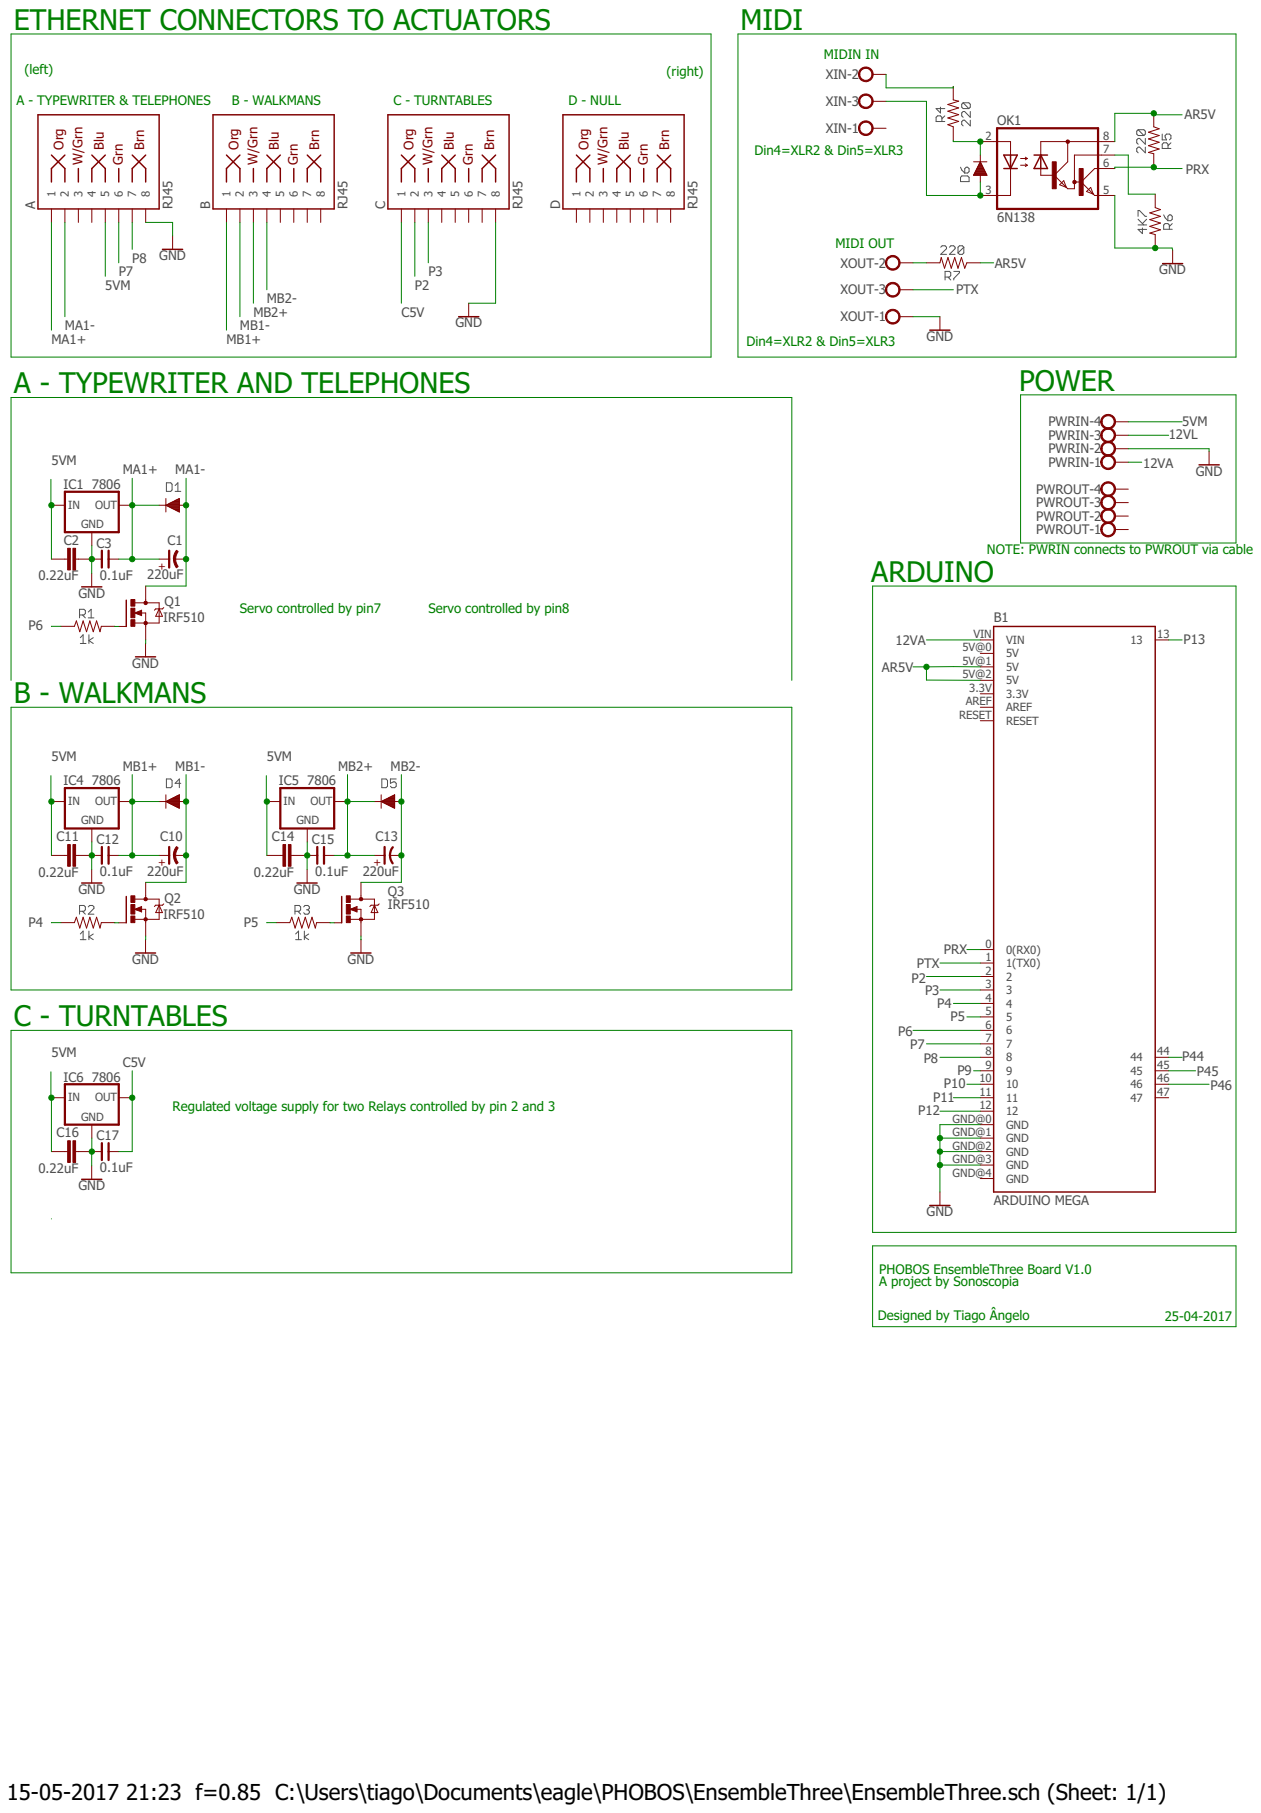
[picture p12: page 1]

ETHERNET CONNECTORS TO ACTUATORS

rg Blu Brn W/Grn Grn +

rg Blu Brn W/Grn Gr

Org Blu Brn W/Grn Gr

PWRIN-1 PWRIN-2 PWRIN-3 PWRIN-4

PWROUT-1 PWROUT-2 PWROUT-3 PWROUT-4

NOTE: PWRIN connects to PWROUT via cable

Regulated voltage supply for two Relays controlled by pin 2 and 3

15-05-2017 21:23 f=0.85 C:\Users\tiago\Documents\eagle\PHOBOS\EnsembleThree\EnsembleThree.sch (Sheet: 1/1)
