Sonoscopia/Phobos/Boards and Schematics/EnsembleTwo/EnsembleTwo_schematic.pdf

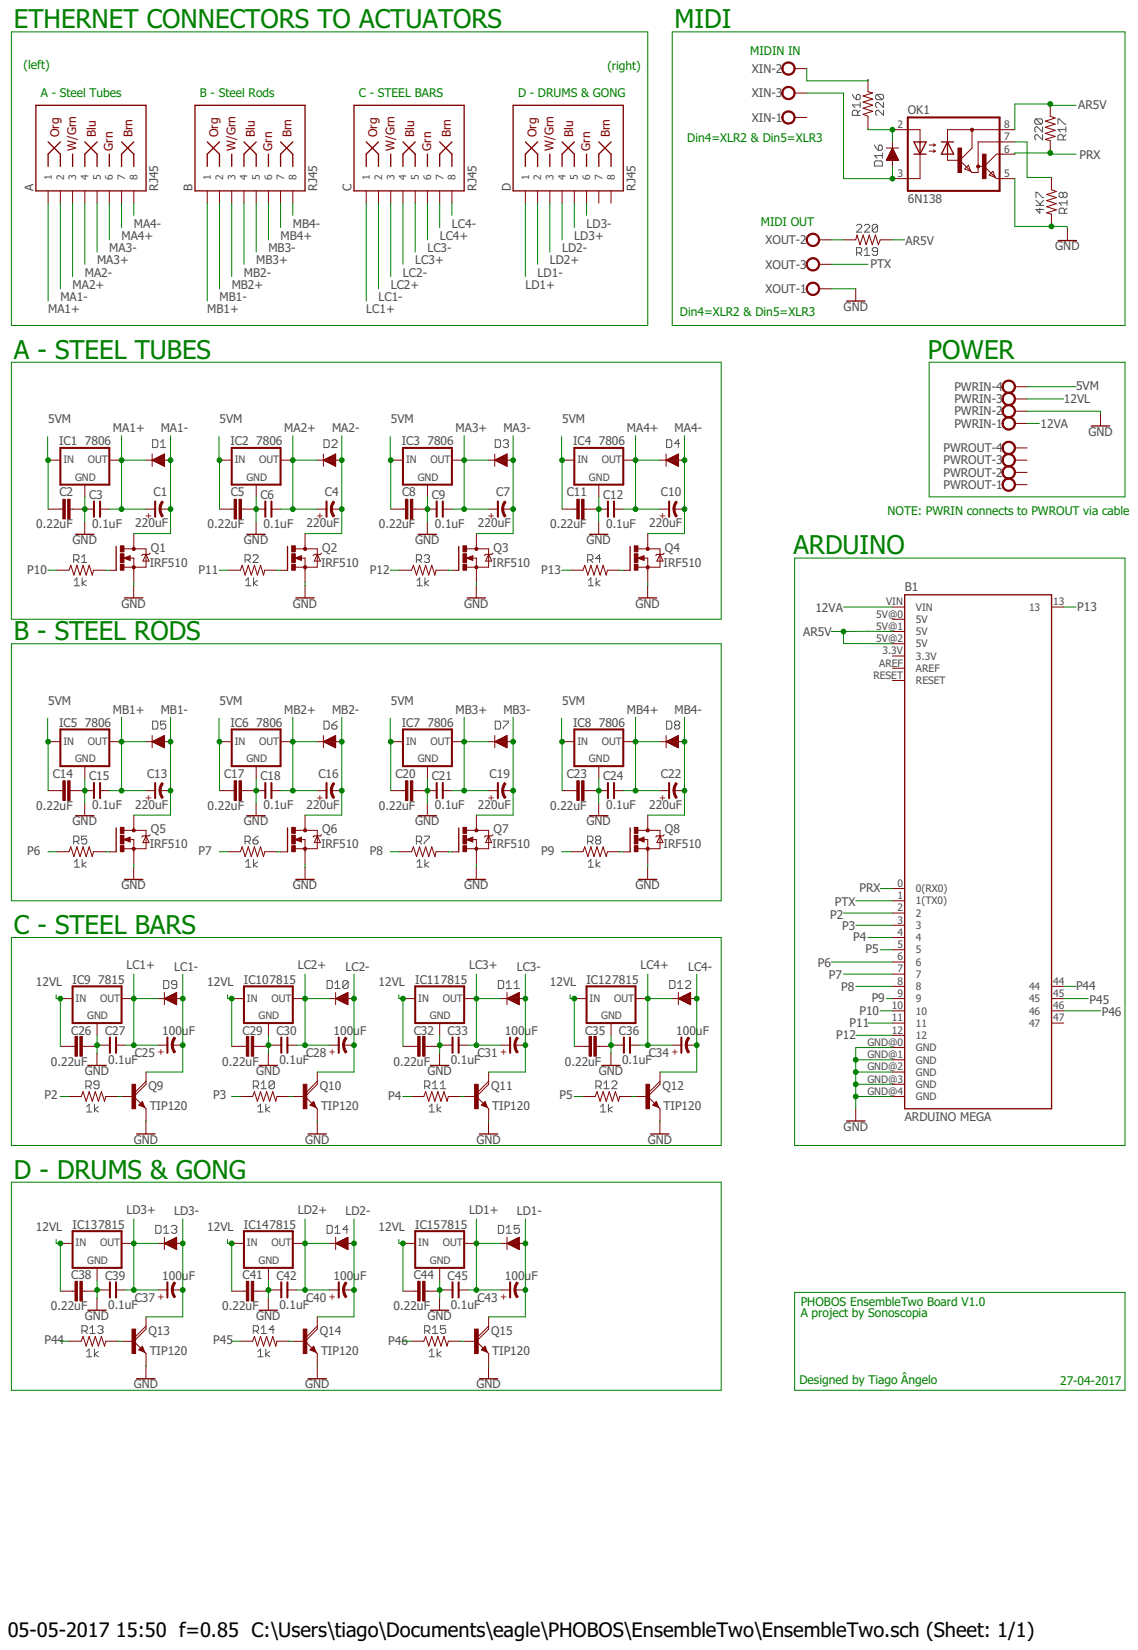
[picture p13: page 1]

ETHERNET CONNECTORS TO ACTUATORS

rg Blu Brn W/Grn Grn +

rg Blu Brn W/Grn Gr

Org Blu Brn W/Grn Gr

PWRIN-1 PWRIN-2 PWRIN-3 PWRIN-4

PWROUT-1 PWROUT-2 PWROUT-3 PWROUT-4 Q2

NOTE: PWRIN connects to PWROUT via cable

PHOBOS EnsembleTwo Board V1.0 Designed by Tiago Ângelo

05-05-2017 15:50 f=0.85 C:\Users\tiago\Documents\eagle\PHOBOS\EnsembleTwo\EnsembleTwo.sch (Sheet: 1/1)
