Sonoscopia/Phobos/Docs/Note and port mapping.pdf

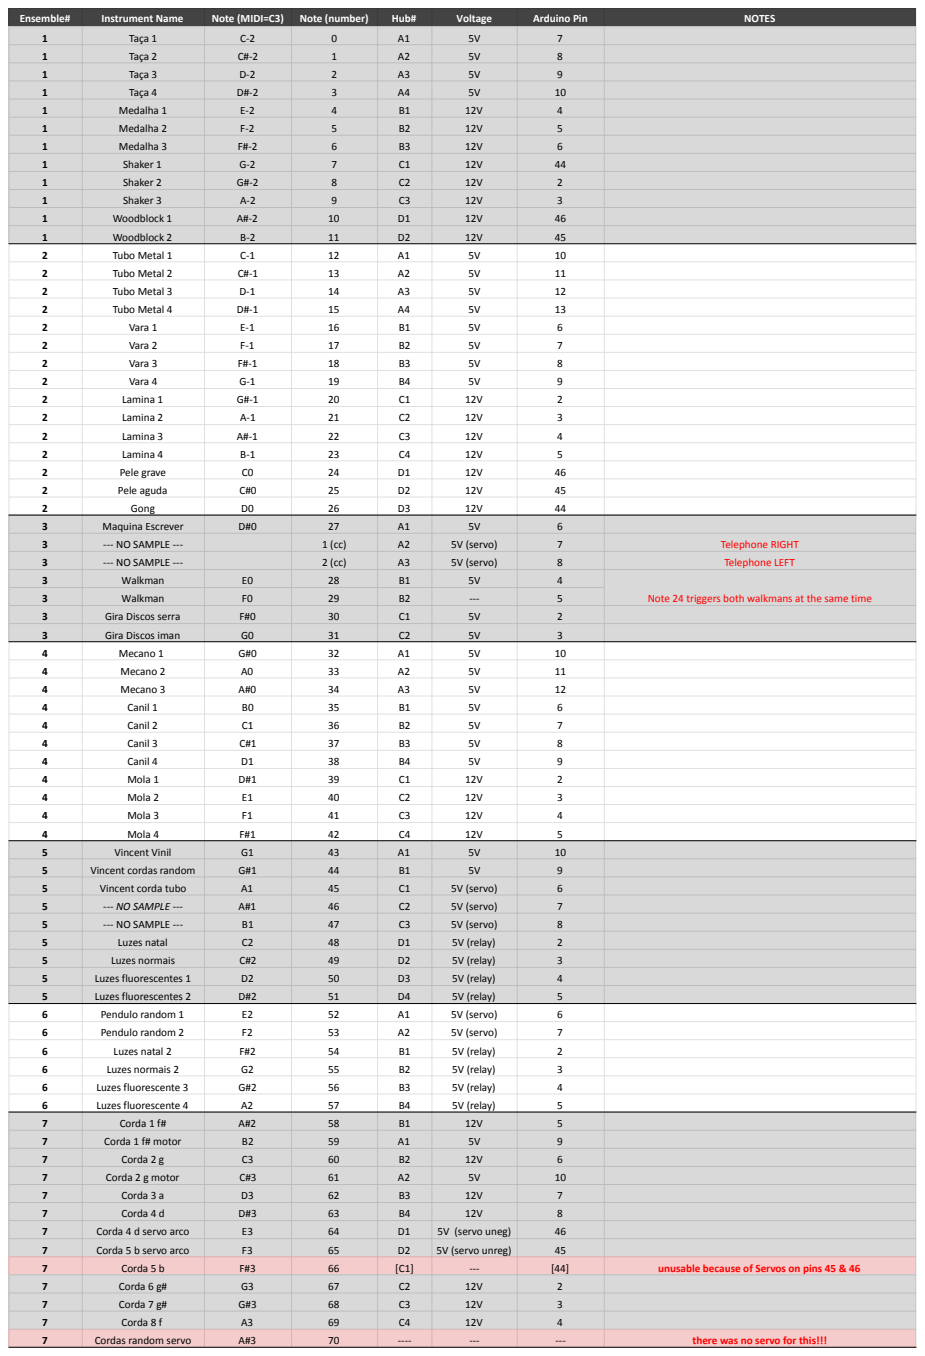
[picture p14: page 1]

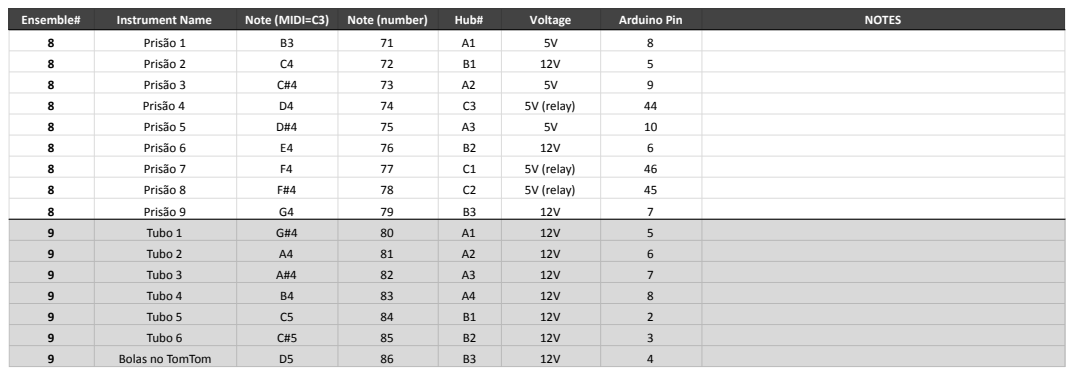
[picture p15: page 2]
Ensemble#; Instrument Name; Note (MIDI=C3); Note (number); Hub#; Voltage; Arduino Pin; NOTES; Prisão 1; Prisão 2; Prisão 3; Prisão 4; 5V (relay); Prisão 5; Prisão 6; Prisão 7; Prisão 8; Prisão 9; Tubo 1; Tubo 2; Tubo 3; Tubo 4; Tubo 5; Tubo 6; Bolas no TomTom
