Sonoscopia/Phobos/Boards and Schematics/EnsembleNine/EnsembleNine.brd

## EAGLE design Boards and Schematics/EnsembleNine/EnsembleNine.brd (2025-08-14)

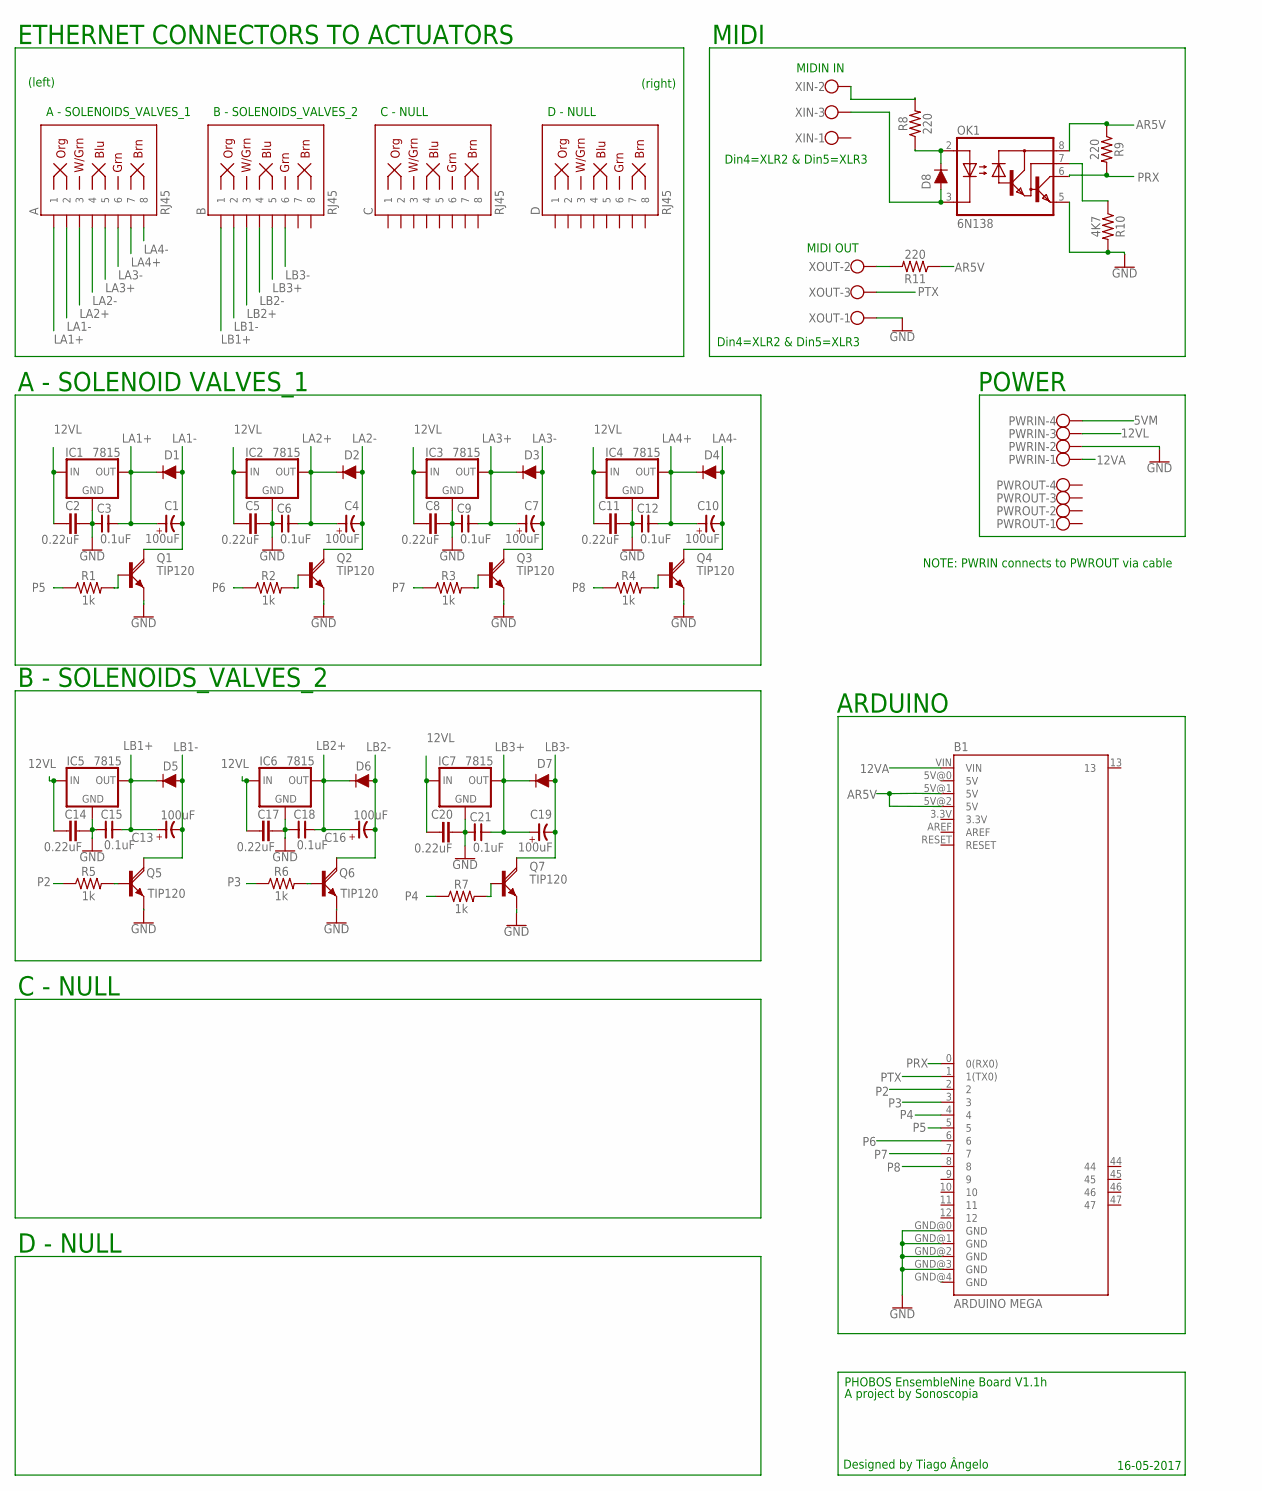
[picture p16: schematic EnsembleNine.sch]

Parts:
A: RJ45; RJ45-8
B: RJ45; RJ45-8
B1: ARDUINO MEGA; ARDUINO_MEGA
C: RJ45; RJ45-8
C1, C4, C7, C10, C19: 100uF; CAP-MASTER_E-020X050
C2, C5, C8, C11, C14, C17, C20: 0.22uF; C5B3
C3, C6, C9, C12, C15, C18, C21: 0.1uF; C025-050X025
C13, C16: 100uF; E-020X050
D: RJ45; RJ45-8
D1, D2, D3, D4, D5, D6, D7: 1A/50V/1.1V; DIODE-1N4001-KIT
D8: 200mA/100V/1V; DIODE-1N4148
IC1, IC2, IC3, IC4, IC5, IC6, IC7: 7815; 78XXS
OK1: 6N138; DIL08
PWRIN: W237-4
PWROUT: W237-4
Q1, Q2, Q3, Q4, Q7: TIP120; ROCKETFARM_TO220AV
Q5, Q6: TIP120; TO220AV
R1, R2, R3, R4, R5, R6, R7: 1k; AXIAL-0.1
R8, R9, R11: 220; AXIAL-0.3
R10: 4K7; AXIAL-0.3
XIN: W237-103
XOUT: W237-103

Connections:
5VM: PWRIN.4
12VA: B1.VIN, PWRIN.1
12VL: C2.1, C5.1, C8.1, C11.1, C14.1, C17.1, C20.1, IC1.IN, IC2.IN, IC3.IN, IC4.IN, IC5.IN, IC6.IN, IC7.IN, PWRIN.3
AR5V: B1.5V@1 (5V), B1.5V@2 (5V), OK1.8 (VCC), R9.P$1 (1), R11.P$1 (1)
GND: B1.GND@0 (GND), B1.GND@1 (GND), B1.GND@2 (GND), B1.GND@3 (GND), C2.2, C3.1, C5.2, C6.1, C8.2, C9.1, C11.2, C12.1, C14.2, C15.1, C17.2, C18.1, C20.2, C21.1, IC1.GND, IC2.GND, IC3.GND, IC4.GND, IC5.GND, IC6.GND, IC7.GND, OK1.5 (GND), PWRIN.2, Q1.E, Q2.E, Q3.E, Q4.E, Q5.E, Q6.E, Q7.E, R10.P$2 (2), XOUT.1
LA1+: A.1, C1.+, C3.2, D1.C, IC1.OUT
LA1-: A.2, C1.-, D1.A, Q1.C
LA2+: A.3, C4.+, C6.2, D2.C, IC2.OUT
LA2-: A.4, C4.-, D2.A, Q2.C
LA3+: A.5, C7.+, C9.2, D3.C, IC3.OUT
LA3-: A.6, C7.-, D3.A, Q3.C
LA4+: A.7, C10.+, C12.2, D4.C, IC4.OUT
LA4-: A.8, C10.-, D4.A, Q4.C
LB1+: B.1, C13.+, C15.2, D5.C, IC5.OUT
LB1-: B.2, C13.-, D5.A, Q5.C
LB2+: B.3, C16.+, C18.2, D6.C, IC6.OUT
LB2-: B.4, C16.-, D6.A, Q6.C
LB3+: B.5, C19.+, C21.2, D7.C, IC7.OUT
LB3-: B.6, C19.-, D7.A, Q7.C
unnamed: Q3.B, R3.P$2 (2)
unnamed: R11.P$2 (2), XOUT.2
unnamed: Q4.B, R4.P$2 (2)
unnamed: Q6.B, R6.P$2 (2)
unnamed: Q5.B, R5.P$2 (2)
unnamed: Q7.B, R7.P$2 (2)
unnamed: Q1.B, R1.P$2 (2)
unnamed: Q2.B, R2.P$2 (2)
unnamed: D8.A, OK1.3 (C), XIN.3
unnamed: D8.C, OK1.2 (A), R8.P$1 (1)
unnamed: R8.P$2 (2), XIN.2
unnamed: OK1.7 (VB), R10.P$1 (1)
P2: B1.2, R5.P$1 (1)
P3: B1.3, R6.P$1 (1)
P4: B1.4, R7.P$1 (1)
P5: B1.5, R1.P$1 (1)
P6: B1.6, R2.P$1 (1)
P7: B1.7, R3.P$1 (1)
P8: B1.8, R4.P$1 (1)
PRX: B1.0 (0(RX0)), OK1.6 (VO), R9.P$2 (2)
PTX: B1.1 (1(TX0)), XOUT.3

Notes on the sheet:
Din4=XLR2 & Din5=XLR3
MIDI OUT
MIDIN IN
POWER
MIDI
ARDUINO
(right)
(left)
ETHERNET CONNECTORS TO ACTUATORS
D - NULL
C - NULL
B - SOLENOIDS_VALVES_2
A - SOLENOIDS_VALVES_1
A - SOLENOID VALVES_1
PHOBOS EnsembleNine Board V1.1h
Designed by Tiago Ângelo
A project by Sonoscopia
16-05-2017
NOTE: PWRIN connects to PWROUT via cable

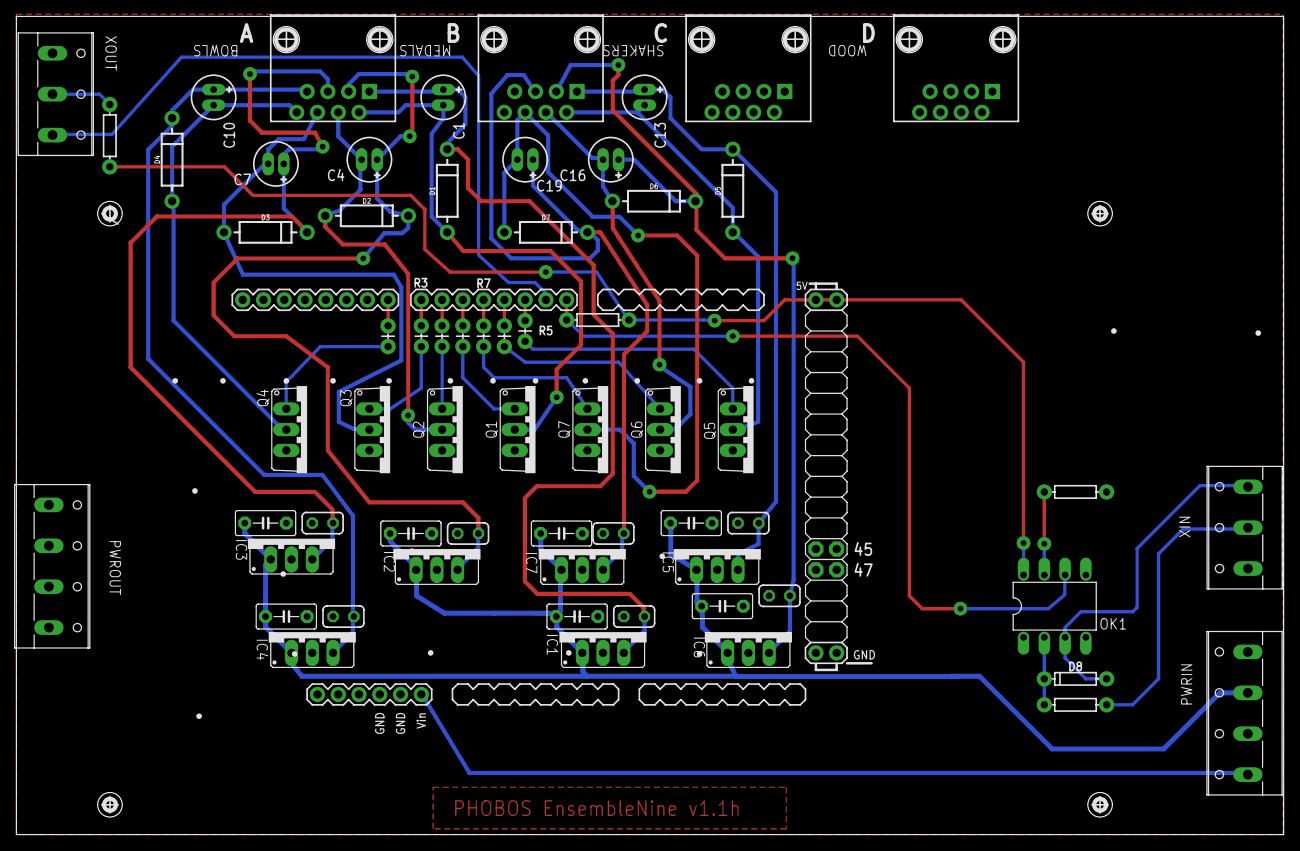
[picture p17: board EnsembleNine.brd from above]

Board: 2 copper layers, 155.0 x 100.1 mm, 64 parts (0 on the bottom side), 39 nets.
