Sonoscopia/Phobos/Boards and Schematics/EnsembleEight/EnsembleEight.brd

## EAGLE design Boards and Schematics/EnsembleEight/EnsembleEight.brd (2025-08-14)

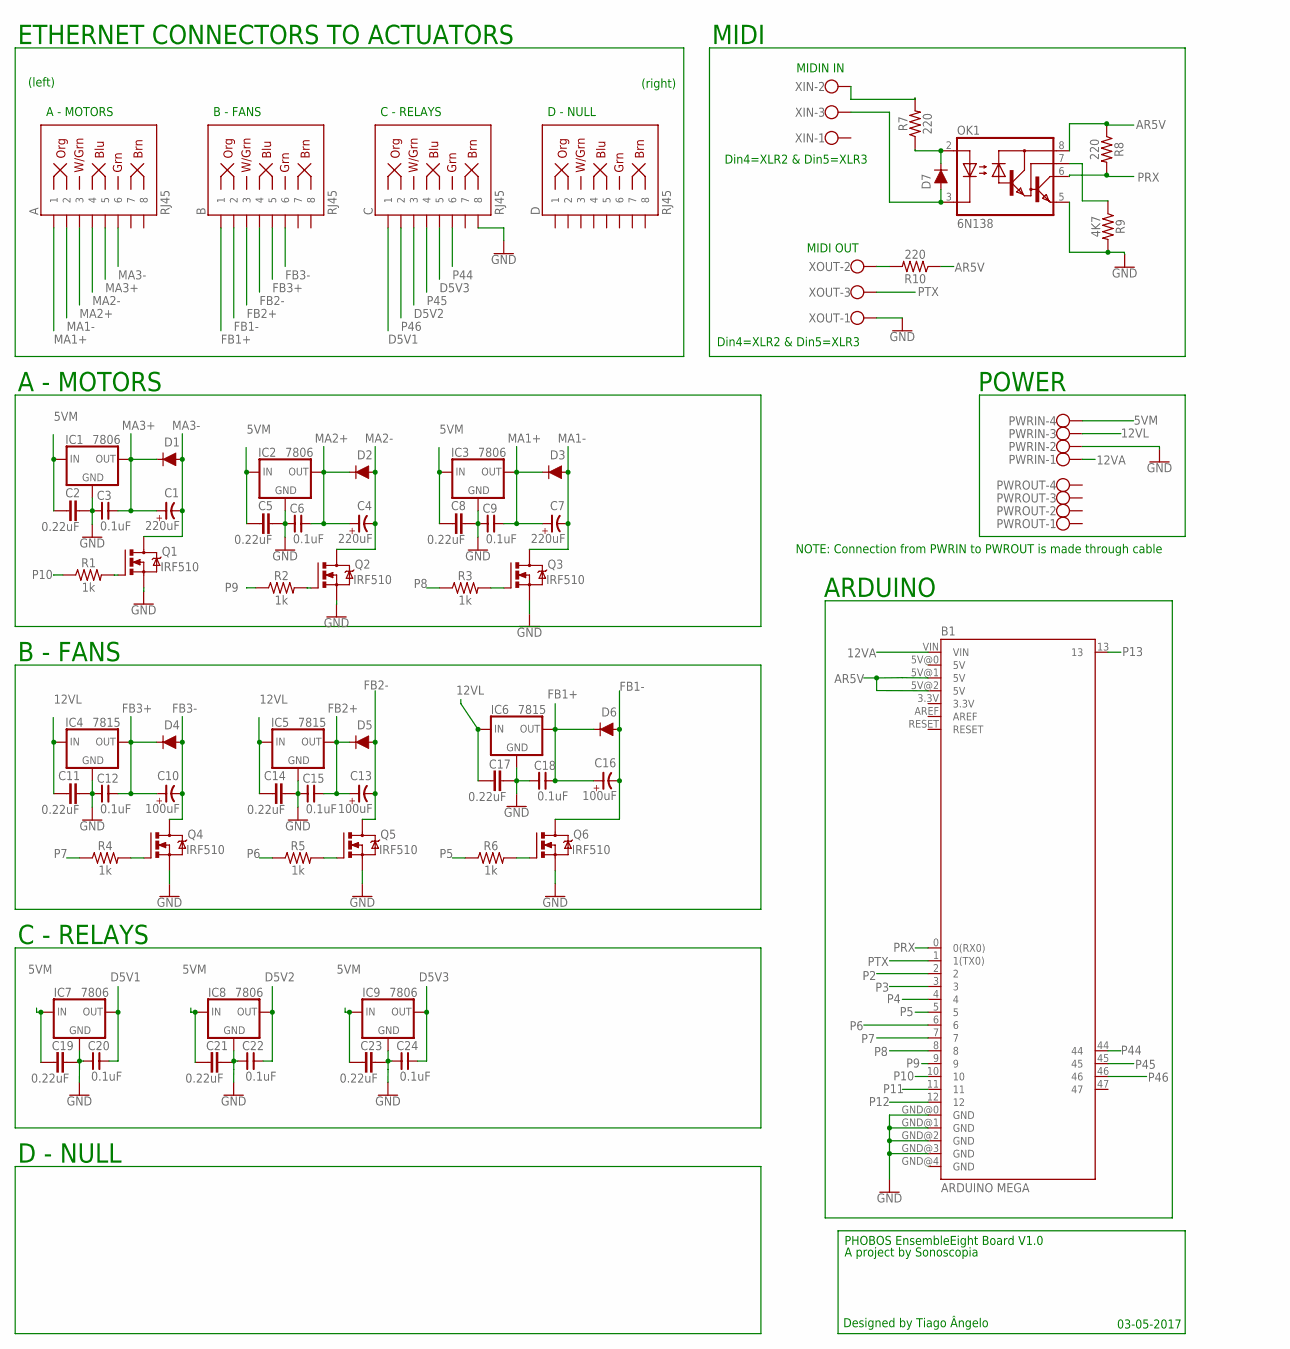
[picture p18: schematic EnsembleEight.sch]

Parts:
A: RJ45; RJ45-8
B: RJ45; RJ45-8
B1: ARDUINO MEGA; ARDUINO_MEGA
C: RJ45; RJ45-8
C1, C4, C7: 220uF; E-035X080
C2, C5, C8, C11, C14, C17, C19, C21, C23: 0.22uF; C5B3
C3, C6, C9, C12, C15, C18, C20, C22, C24: 0.1uF; C025-050X025
C10, C13, C16: 100uF; CAP-MASTER_E-020X050
D: RJ45; RJ45-8
D1, D2, D3, D4, D5, D6: 1A/50V/1.1V; DIODE-1N4001-KIT
D7: 200mA/100V/1V; DIODE-1N4148
IC1, IC2, IC3, IC7, IC8, IC9: 7806; 78XXS
IC4, IC5, IC6: 7815; 78XXS
OK1: 6N138; DIL08
PWRIN: W237-4
PWROUT: W237-4
Q1, Q2, Q3, Q4, Q5, Q6: IRF510; TO220BV
R1, R2, R3, R4, R5, R6: 1k; AXIAL-0.1
R7, R8, R10: 220; AXIAL-0.3
R9: 4K7; AXIAL-0.3
XIN: W237-103
XOUT: W237-103

Connections:
5VM: C2.1, C5.1, C8.1, C19.1, C21.1, C23.1, IC1.IN, IC2.IN, IC3.IN, IC7.IN, IC8.IN, IC9.IN, PWRIN.4
12VA: B1.VIN, PWRIN.1
12VL: C11.1, C14.1, C17.1, IC4.IN, IC5.IN, IC6.IN, PWRIN.3
AR5V: B1.5V@1 (5V), B1.5V@2 (5V), OK1.8 (VCC), R8.P$1 (1), R10.P$1 (1)
D5V1: C.1, C20.2, IC7.OUT
D5V2: C.3, C22.2, IC8.OUT
D5V3: C.5, C24.2, IC9.OUT
FB1+: B.1, C16.+, C18.2, D6.C, IC6.OUT
FB1-: B.2, C16.-, D6.A, Q6.D
FB2+: B.3, C13.+, C15.2, D5.C, IC5.OUT
FB2-: B.4, C13.-, D5.A, Q5.D
FB3+: B.5, C10.+, C12.2, D4.C, IC4.OUT
FB3-: B.6, C10.-, D4.A, Q4.D
GND: B1.GND@0 (GND), B1.GND@1 (GND), B1.GND@2 (GND), B1.GND@3 (GND), C.8, C2.2, C3.1, C5.2, C6.1, C8.2, C9.1, C11.2, C12.1, C14.2, C15.1, C17.2, C18.1, C19.2, C20.1, C21.2, C22.1, C23.2, C24.1, IC1.GND, IC2.GND, IC3.GND, IC4.GND, IC5.GND, IC6.GND, IC7.GND, IC8.GND, IC9.GND, OK1.5 (GND), PWRIN.2, Q1.S, Q2.S, Q3.S, Q4.S, Q5.S, Q6.S, R9.P$2 (2), XOUT.1
MA1+: A.1, C7.+, C9.2, D3.C, IC3.OUT
MA1-: A.2, C7.-, D3.A, Q3.D
MA2+: A.3, C4.+, C6.2, D2.C, IC2.OUT
MA2-: A.4, C4.-, D2.A, Q2.D
MA3+: A.5, C1.+, C3.2, D1.C, IC1.OUT
MA3-: A.6, C1.-, D1.A, Q1.D
unnamed: Q1.G, R1.P$2 (2)
unnamed: R10.P$2 (2), XOUT.2
unnamed: Q3.G, R3.P$2 (2)
unnamed: Q4.G, R4.P$2 (2)
unnamed: Q5.G, R5.P$2 (2)
unnamed: Q6.G, R6.P$2 (2)
unnamed: Q2.G, R2.P$2 (2)
unnamed: D7.A, OK1.3 (C), XIN.3
unnamed: D7.C, OK1.2 (A), R7.P$1 (1)
unnamed: R7.P$2 (2), XIN.2
unnamed: OK1.7 (VB), R9.P$1 (1)
P2: B1.2
P3: B1.3
P4: B1.4
P5: B1.5, R6.P$1 (1)
P6: B1.6, R5.P$1 (1)
P7: B1.7, R4.P$1 (1)
P8: B1.8, R3.P$1 (1)
P9: B1.9, R2.P$1 (1)
P10: B1.10, R1.P$1 (1)
P11: B1.11
P12: B1.12
P13: B1.13
P44: B1.44, C.6
P45: B1.45, C.4
P46: B1.46, C.2
PRX: B1.0 (0(RX0)), OK1.6 (VO), R8.P$2 (2)
PTX: B1.1 (1(TX0)), XOUT.3

Notes on the sheet:
Din4=XLR2 & Din5=XLR3
MIDI OUT
MIDIN IN
POWER
MIDI
ARDUINO
(right)
(left)
ETHERNET CONNECTORS TO ACTUATORS
D - NULL
C - RELAYS
B - FANS
A - MOTORS
PHOBOS EnsembleEight Board V1.0
Designed by Tiago Ângelo
A project by Sonoscopia
03-05-2017
NOTE: Connection from PWRIN to PWROUT is made through cable

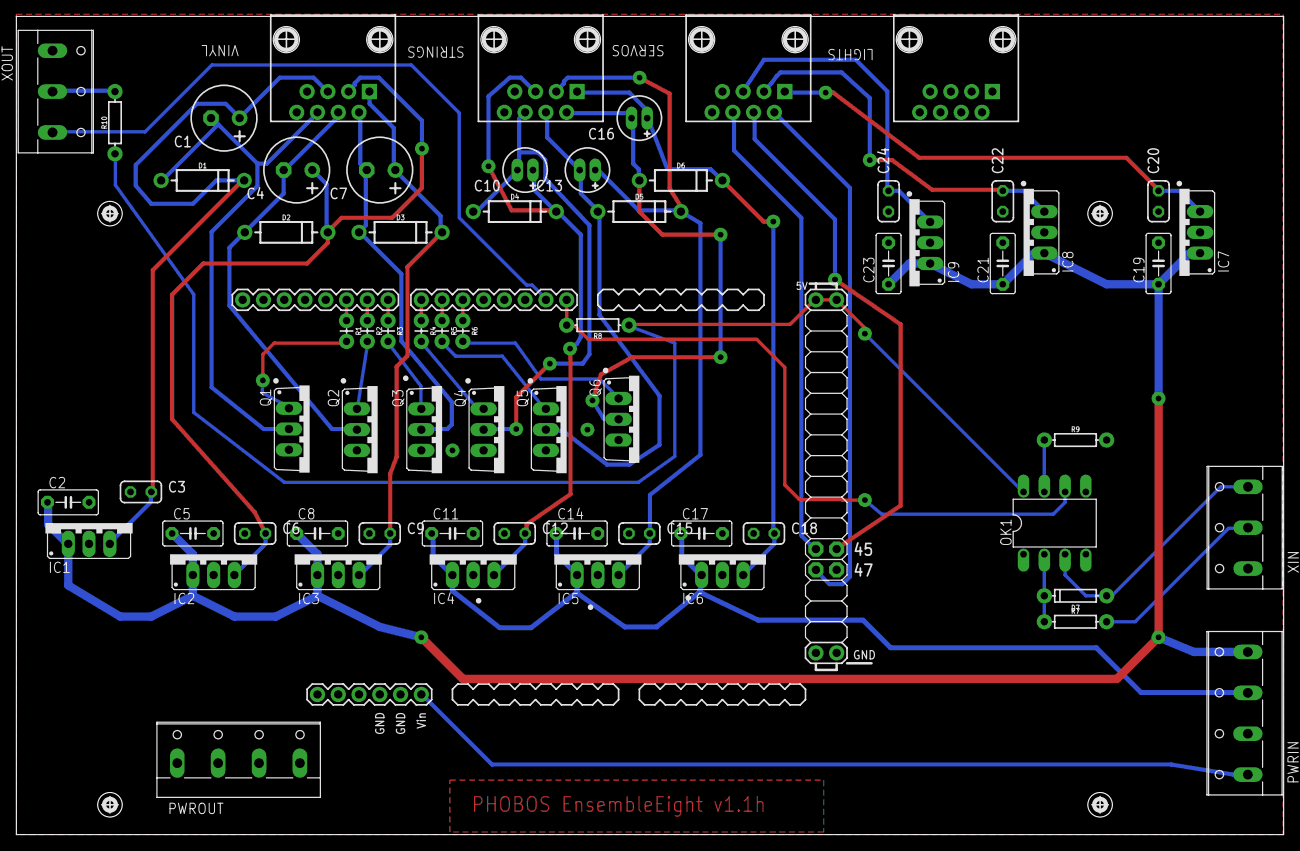
[picture p19: board EnsembleEight.brd from above]

Board: 2 copper layers, 155.0 x 100.1 mm, 66 parts (0 on the bottom side), 42 nets.
