Sonoscopia/Phobos/Boards and Schematics/EnsembleFive/EnsembleFive.brd

## EAGLE design Boards and Schematics/EnsembleFive/EnsembleFive.brd (2025-08-14)

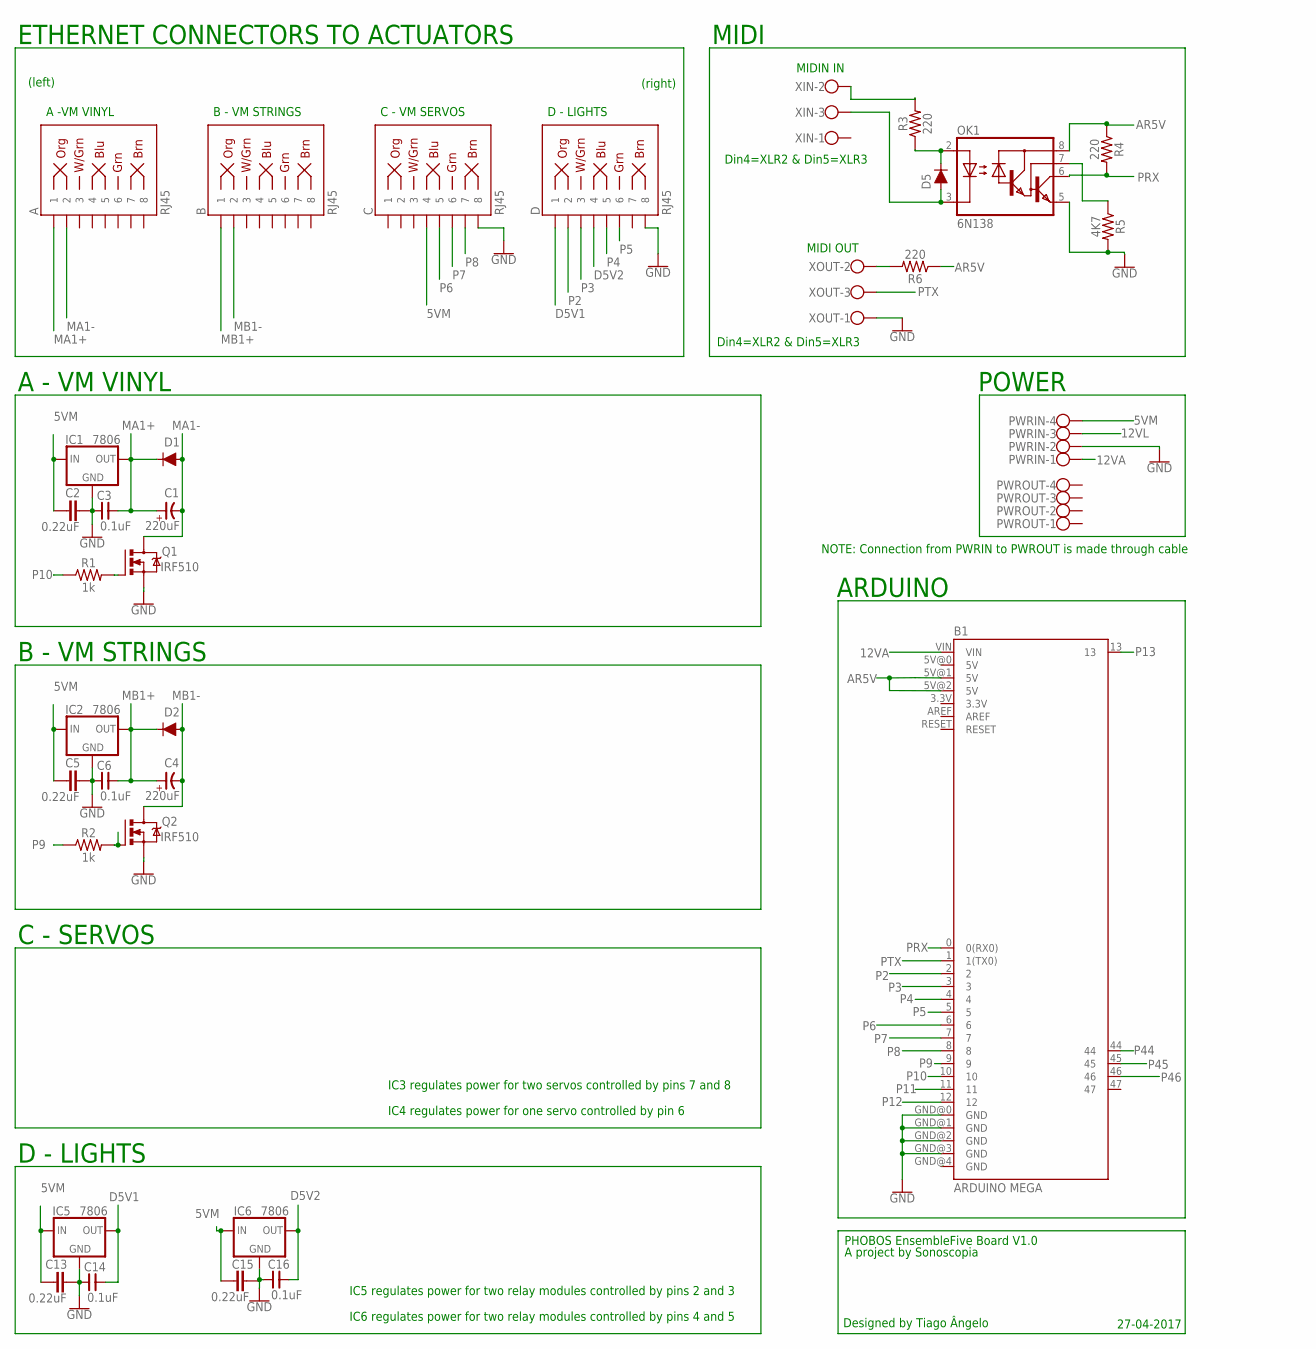
[picture p20: schematic EnsembleFive.sch]

Parts:
A: RJ45; RJ45-8
B: RJ45; RJ45-8
B1: ARDUINO MEGA; ARDUINO_MEGA
C: RJ45; RJ45-8
C1, C4: 220uF; E-035X080
C2, C5, C13, C15: 0.22uF; C5B3
C3, C6, C14, C16: 0.1uF; C025-050X025
D: RJ45; RJ45-8
D1, D2: 1A/50V/1.1V; DIODE-1N4001-KIT
D5: 200mA/100V/1V; DIODE-1N4148
IC1, IC2, IC5, IC6: 7806; 78XXS
OK1: 6N138; DIL08
PWRIN: W237-4
PWROUT: W237-4
Q1, Q2: IRF510; TO220BV
R1, R2: 1k; AXIAL-0.1
R3, R4, R6: 220; AXIAL-0.3
R5: 4K7; AXIAL-0.3
XIN: W237-103
XOUT: W237-103

Connections:
5VM: C.4, C2.1, C5.1, C13.1, C15.1, IC1.IN, IC2.IN, IC5.IN, IC6.IN, PWRIN.4
12VA: B1.VIN, PWRIN.1
12VL: PWRIN.3
AR5V: B1.5V@1 (5V), B1.5V@2 (5V), OK1.8 (VCC), R4.P$1 (1), R6.P$1 (1)
D5V1: C14.2, D.1, IC5.OUT
D5V2: C16.2, D.4, IC6.OUT
GND: B1.GND@0 (GND), B1.GND@1 (GND), B1.GND@2 (GND), B1.GND@3 (GND), C.8, C2.2, C3.1, C5.2, C6.1, C13.2, C14.1, C15.2, C16.1, D.8, IC1.GND, IC2.GND, IC5.GND, IC6.GND, OK1.5 (GND), PWRIN.2, Q1.S, Q2.S, R5.P$2 (2), XOUT.1
MA1+: A.1, C1.+, C3.2, D1.C, IC1.OUT
MA1-: A.2, C1.-, D1.A, Q1.D
MB1+: B.1, C4.+, C6.2, D2.C, IC2.OUT
MB1-: B.2, C4.-, D2.A, Q2.D
unnamed: Q1.G, R1.P$2 (2)
unnamed: R6.P$2 (2), XOUT.2
unnamed: Q2.G, R2.P$2 (2)
unnamed: D5.A, OK1.3 (C), XIN.3
unnamed: D5.C, OK1.2 (A), R3.P$1 (1)
unnamed: R3.P$2 (2), XIN.2
unnamed: OK1.7 (VB), R5.P$1 (1)
P2: B1.2, D.2
P3: B1.3, D.3
P4: B1.4, D.5
P5: B1.5, D.6
P6: B1.6, C.5
P7: B1.7, C.6
P8: B1.8, C.7
P9: B1.9, R2.P$1 (1)
P10: B1.10, R1.P$1 (1)
P11: B1.11
P12: B1.12
P13: B1.13
P44: B1.44
P45: B1.45
P46: B1.46
PRX: B1.0 (0(RX0)), OK1.6 (VO), R4.P$2 (2)
PTX: B1.1 (1(TX0)), XOUT.3

Notes on the sheet:
Din4=XLR2 & Din5=XLR3
MIDI OUT
MIDIN IN
POWER
MIDI
ARDUINO
(right)
(left)
ETHERNET CONNECTORS TO ACTUATORS
D - LIGHTS
C - VM SERVOS
B - VM STRINGS
A -VM VINYL
A - VM VINYL
C - SERVOS
PHOBOS EnsembleFive Board V1.0
Designed by Tiago Ângelo
A project by Sonoscopia
27-04-2017
IC3 regulates power for two servos controlled by pins 7 and 8
IC4 regulates power for one servo controlled by pin 6
IC5 regulates power for two relay modules controlled by pins 2 and 3
IC6 regulates power for two relay modules controlled by pins 4 and 5
NOTE: Connection from PWRIN to PWROUT is made through cable

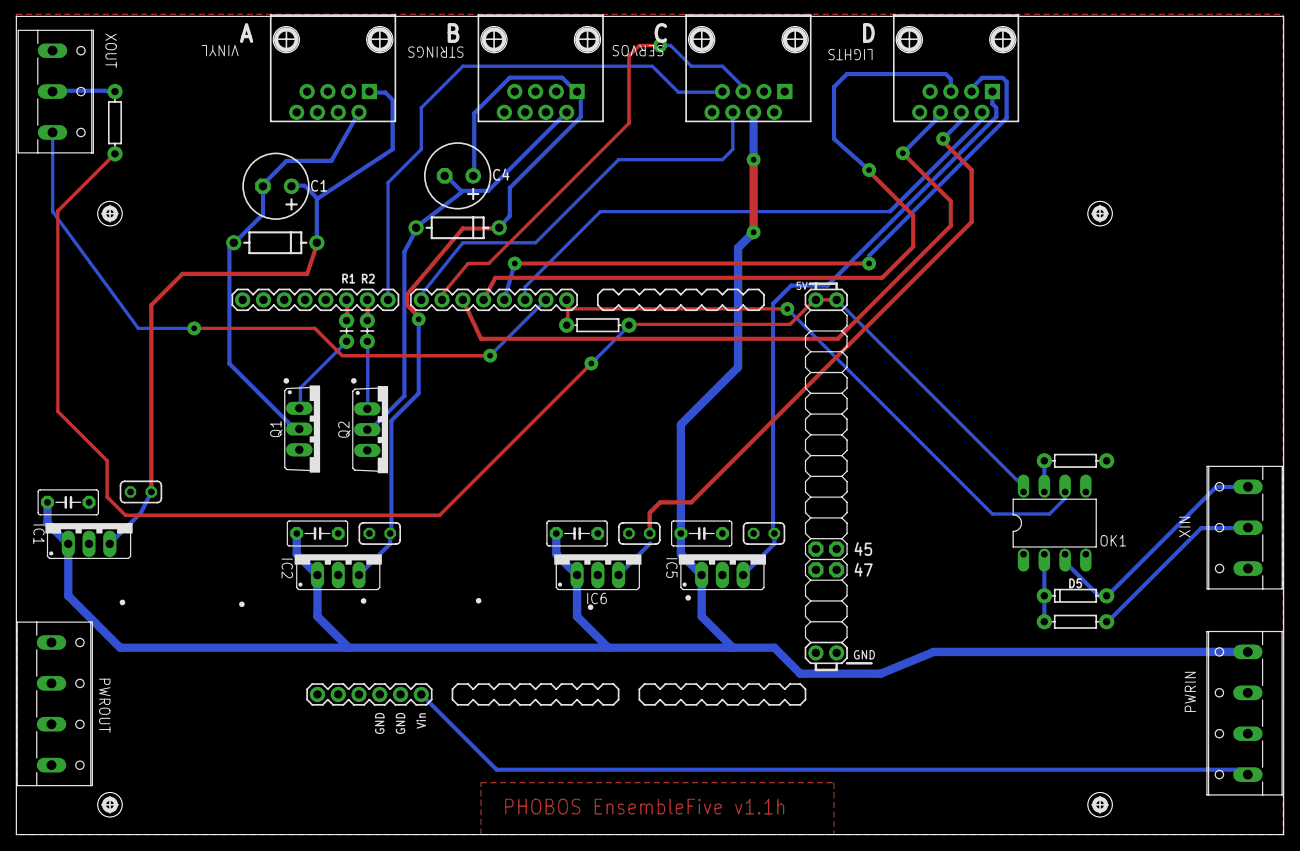
[picture p21: board EnsembleFive.brd from above]

Board: 2 copper layers, 155.0 x 100.1 mm, 35 parts (0 on the bottom side), 28 nets.
