Sonoscopia/Phobos/Boards and Schematics/EnsembleOne/EnsembleOne.brd

## EAGLE design Boards and Schematics/EnsembleOne/EnsembleOne.brd (2025-08-14)

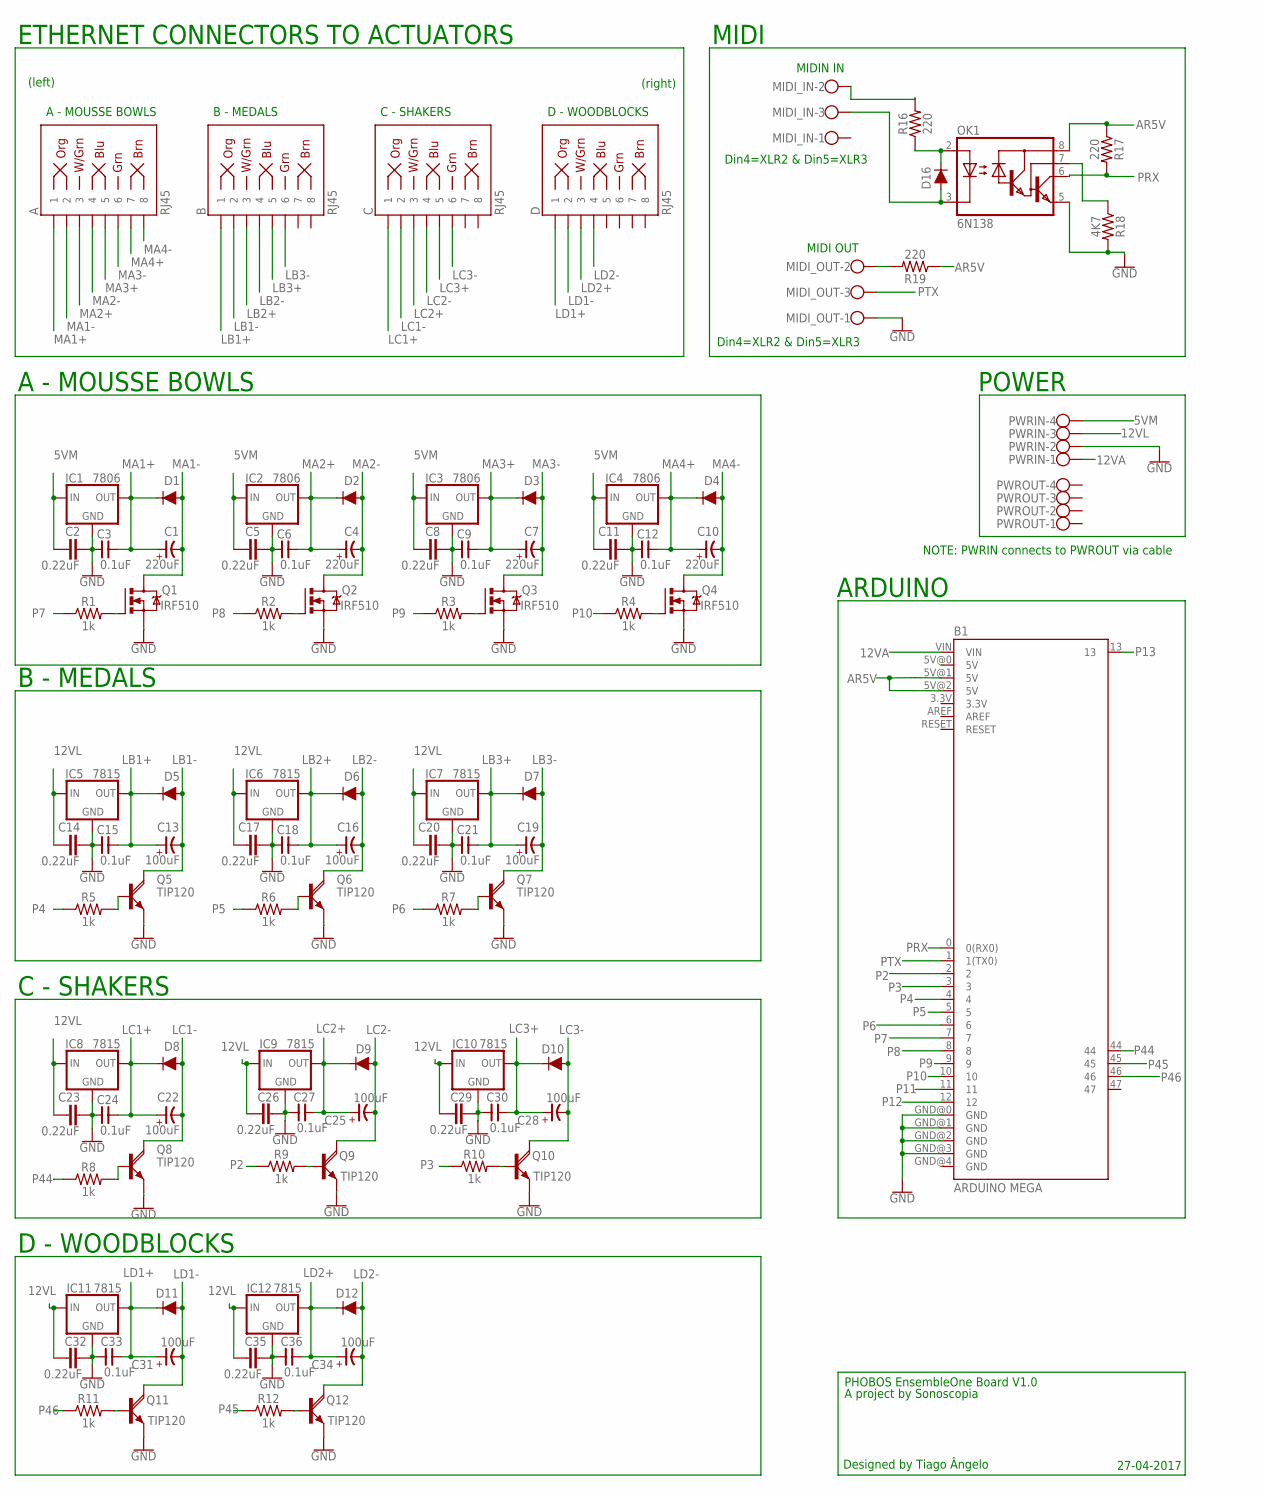
[picture p22: schematic EnsembleOne.sch]

Parts:
A: RJ45; RJ45-8
B: RJ45; RJ45-8
B1: ARDUINO MEGA; ENSEMBLE_ONE_ARDUINO_MEGA
C: RJ45; RJ45-8
C1, C4, C7, C10: 220uF; E-035X080
C2, C5, C8, C11, C14, C17, C20, C23, C26, C29, C32, C35: 0.22uF; C5B3
C3, C6, C9, C12, C15, C18, C21, C24, C27, C30, C33, C36: 0.1uF; C025-050X025
C13, C16, C19, C22: 100uF; CAP-MASTER_E-020X050
C25, C28, C31, C34: 100uF; E-020X050
D: RJ45; RJ45-8
D1, D2, D3, D4, D5, D6, D7, D8, D9, D10, D11, D12: 1A/50V/1.1V; DIODE-1N4001-KIT
D16: 200mA/100V/1V; DIODE-1N4148
IC1, IC2, IC3, IC4: 7806; 78XXS
IC5, IC6, IC7, IC8, IC9, IC10, IC11, IC12: 7815; 78XXS
MIDI_IN: W237-103
MIDI_OUT: W237-103
OK1: 6N138; DIL08
PWRIN: W237-4
PWROUT: W237-4
Q1, Q2, Q3, Q4: IRF510; TO220BV
Q5, Q6, Q7, Q8: TIP120; ROCKETFARM_TO220AV
Q9, Q10, Q11, Q12: TIP120; TO220AV
R1, R2, R3, R4, R5, R6, R7, R8, R9, R10, R11, R12: 1k; AXIAL-0.1
R16, R17, R19: 220; AXIAL-0.3
R18: 4K7; AXIAL-0.3

Connections:
5VM: C2.1, C5.1, C8.1, C11.1, IC1.IN, IC2.IN, IC3.IN, IC4.IN, PWRIN.4
12VA: B1.VIN, PWRIN.1
12VL: C14.1, C17.1, C20.1, C23.1, C26.1, C29.1, C32.1, C35.1, IC5.IN, IC6.IN, IC7.IN, IC8.IN, IC9.IN, IC10.IN, IC11.IN, IC12.IN, PWRIN.3
AR5V: B1.5V@1 (5V), B1.5V@2 (5V), OK1.8 (VCC), R17.P$1 (1), R19.P$1 (1)
GND: B1.GND@0 (GND), B1.GND@1 (GND), B1.GND@2 (GND), B1.GND@3 (GND), C2.2, C3.1, C5.2, C6.1, C8.2, C9.1, C11.2, C12.1, C14.2, C15.1, C17.2, C18.1, C20.2, C21.1, C23.2, C24.1, C26.2, C27.1, C29.2, C30.1, C32.2, C33.1, C35.2, C36.1, IC1.GND, IC2.GND, IC3.GND, IC4.GND, IC5.GND, IC6.GND, IC7.GND, IC8.GND, IC9.GND, IC10.GND, IC11.GND, IC12.GND, MIDI_OUT.1, OK1.5 (GND), PWRIN.2, Q1.S, Q2.S, Q3.S, Q4.S, Q5.E, Q6.E, Q7.E, Q8.E, Q9.E, Q10.E, Q11.E, Q12.E, R18.P$2 (2)
LB1+: B.1, C13.+, C15.2, D5.C, IC5.OUT
LB1-: B.2, C13.-, D5.A, Q5.C
LB2+: B.3, C16.+, C18.2, D6.C, IC6.OUT
LB2-: B.4, C16.-, D6.A, Q6.C
LB3+: B.5, C19.+, C21.2, D7.C, IC7.OUT
LB3-: B.6, C19.-, D7.A, Q7.C
LC1+: C.1, C22.+, C24.2, D8.C, IC8.OUT
LC1-: C.2, C22.-, D8.A, Q8.C
LC2+: C.3, C25.+, C27.2, D9.C, IC9.OUT
LC2-: C.4, C25.-, D9.A, Q9.C
LC3+: C.5, C28.+, C30.2, D10.C, IC10.OUT
LC3-: C.6, C28.-, D10.A, Q10.C
LD1+: C31.+, C33.2, D.1, D11.C, IC11.OUT
LD1-: C31.-, D.2, D11.A, Q11.C
LD2+: C34.+, C36.2, D.3, D12.C, IC12.OUT
LD2-: C34.-, D.4, D12.A, Q12.C
MA1+: A.1, C1.+, C3.2, D1.C, IC1.OUT
MA1-: A.2, C1.-, D1.A, Q1.D
MA2+: A.3, C4.+, C6.2, D2.C, IC2.OUT
MA2-: A.4, C4.-, D2.A, Q2.D
MA3+: A.5, C7.+, C9.2, D3.C, IC3.OUT
MA3-: A.6, C7.-, D3.A, Q3.D
MA4+: A.7, C10.+, C12.2, D4.C, IC4.OUT
MA4-: A.8, C10.-, D4.A, Q4.D
unnamed: Q1.G, R1.P$2 (2)
unnamed: MIDI_OUT.2, R19.P$2 (2)
unnamed: Q2.G, R2.P$2 (2)
unnamed: Q10.B, R10.P$2 (2)
unnamed: Q11.B, R11.P$2 (2)
unnamed: Q9.B, R9.P$2 (2)
unnamed: Q3.G, R3.P$2 (2)
unnamed: Q4.G, R4.P$2 (2)
unnamed: Q5.B, R5.P$2 (2)
unnamed: Q6.B, R6.P$2 (2)
unnamed: Q7.B, R7.P$2 (2)
unnamed: Q8.B, R8.P$2 (2)
unnamed: Q12.B, R12.P$2 (2)
unnamed: D16.A, MIDI_IN.3, OK1.3 (C)
unnamed: D16.C, OK1.2 (A), R16.P$1 (1)
unnamed: MIDI_IN.2, R16.P$2 (2)
unnamed: OK1.7 (VB), R18.P$1 (1)
P2: B1.2, R9.P$1 (1)
P3: B1.3, R10.P$1 (1)
P4: B1.4, R5.P$1 (1)
P5: B1.5, R6.P$1 (1)
P6: B1.6, R7.P$1 (1)
P7: B1.7, R1.P$1 (1)
P8: B1.8, R2.P$1 (1)
P9: B1.9, R3.P$1 (1)
P10: B1.10, R4.P$1 (1)
P11: B1.11
P12: B1.12
P13: B1.13
P44: B1.44, R8.P$1 (1)
P45: B1.45, R12.P$1 (1)
P46: B1.46, R11.P$1 (1)
PRX: B1.0 (0(RX0)), OK1.6 (VO), R17.P$2 (2)
PTX: B1.1 (1(TX0)), MIDI_OUT.3

Notes on the sheet:
Din4=XLR2 & Din5=XLR3
MIDI OUT
MIDIN IN
POWER
MIDI
ARDUINO
(right)
(left)
ETHERNET CONNECTORS TO ACTUATORS
D - WOODBLOCKS
C - SHAKERS
B - MEDALS
A - MOUSSE BOWLS
PHOBOS EnsembleOne Board V1.0
Designed by Tiago Ângelo
A project by Sonoscopia
27-04-2017
NOTE: PWRIN connects to PWROUT via cable

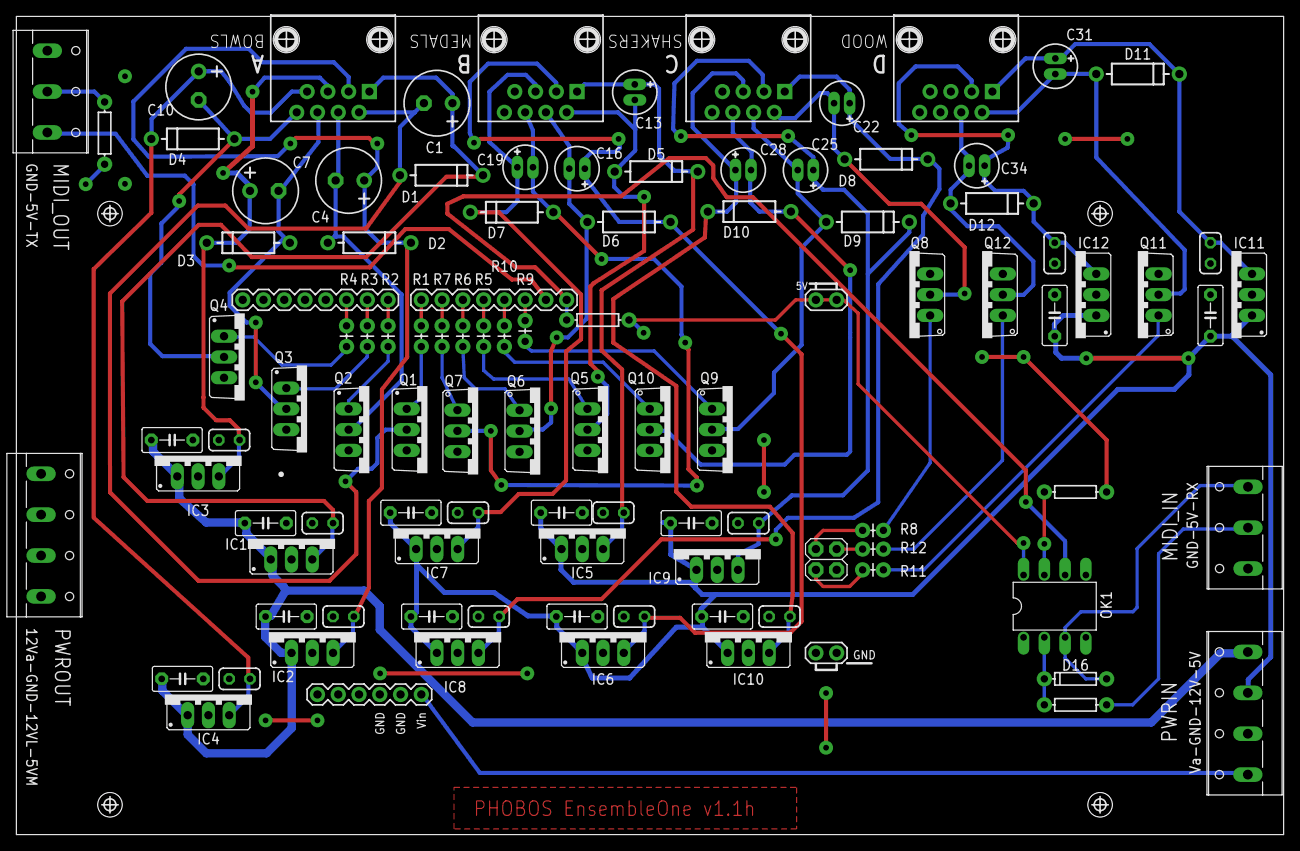
[picture p23: board EnsembleOne.brd from above]

Board: 2 copper layers, 155.0 x 100.1 mm, 99 parts (0 on the bottom side), 60 nets.
