Sonoscopia/Phobos/Boards and Schematics/InstrumentHubs/InstrumentHubs.brd

## EAGLE design Boards and Schematics/InstrumentHubs/InstrumentHubs.brd (2025-08-14)

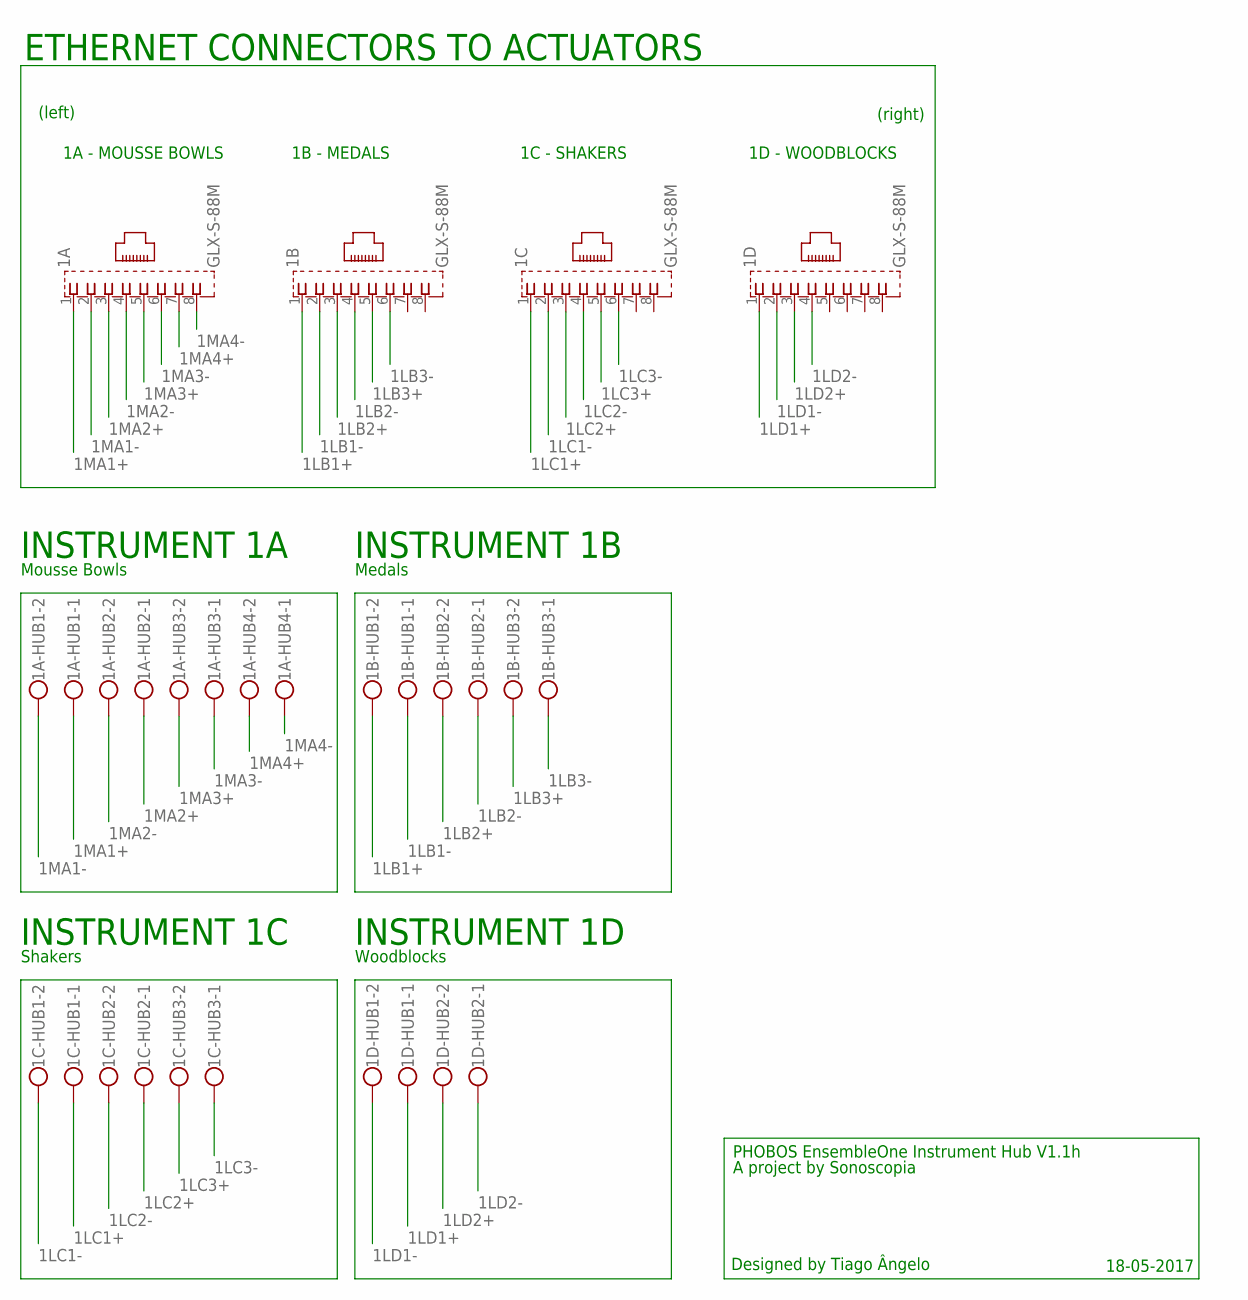
[picture p24: schematic InstrumentHubs.sch, sheet 1]

Parts:
1A, 1B, 1C, 1D: GLX-S-88M
1A-HUB1, 1A-HUB2, 1A-HUB3, 1A-HUB4, 1B-HUB1, 1B-HUB2, 1B-HUB3, 1C-HUB1, 1C-HUB2, 1C-HUB3, 1D-HUB1, 1D-HUB2: W237-102

Connections:
1LB1+: 1B.1, 1B-HUB1.2
1LB1-: 1B.2, 1B-HUB1.1
1LB2+: 1B.3, 1B-HUB2.2
1LB2-: 1B.4, 1B-HUB2.1
1LB3+: 1B.5, 1B-HUB3.2
1LB3-: 1B.6, 1B-HUB3.1
1LC1+: 1C.1, 1C-HUB1.1
1LC1-: 1C.2, 1C-HUB1.2
1LC2+: 1C.3, 1C-HUB2.1
1LC2-: 1C.4, 1C-HUB2.2
1LC3+: 1C.5, 1C-HUB3.2
1LC3-: 1C.6, 1C-HUB3.1
1LD1+: 1D.1, 1D-HUB1.1
1LD1-: 1D.2, 1D-HUB1.2
1LD2+: 1D.3, 1D-HUB2.2
1LD2-: 1D.4, 1D-HUB2.1
1MA1+: 1A.1, 1A-HUB1.1
1MA1-: 1A.2, 1A-HUB1.2
1MA2+: 1A.3, 1A-HUB2.1
1MA2-: 1A.4, 1A-HUB2.2
1MA3+: 1A.5, 1A-HUB3.2
1MA3-: 1A.6, 1A-HUB3.1
1MA4+: 1A.7, 1A-HUB4.2
1MA4-: 1A.8, 1A-HUB4.1

Notes on the sheet:
INSTRUMENT 1A
(right)
(left)
ETHERNET CONNECTORS TO ACTUATORS
1D - WOODBLOCKS
1C - SHAKERS
1B - MEDALS
1A - MOUSSE BOWLS
PHOBOS EnsembleOne Instrument Hub V1.1h
Designed by Tiago Ângelo
A project by Sonoscopia
Mousse Bowls
INSTRUMENT 1B
Medals
INSTRUMENT 1C
Shakers
INSTRUMENT 1D
Woodblocks
18-05-2017

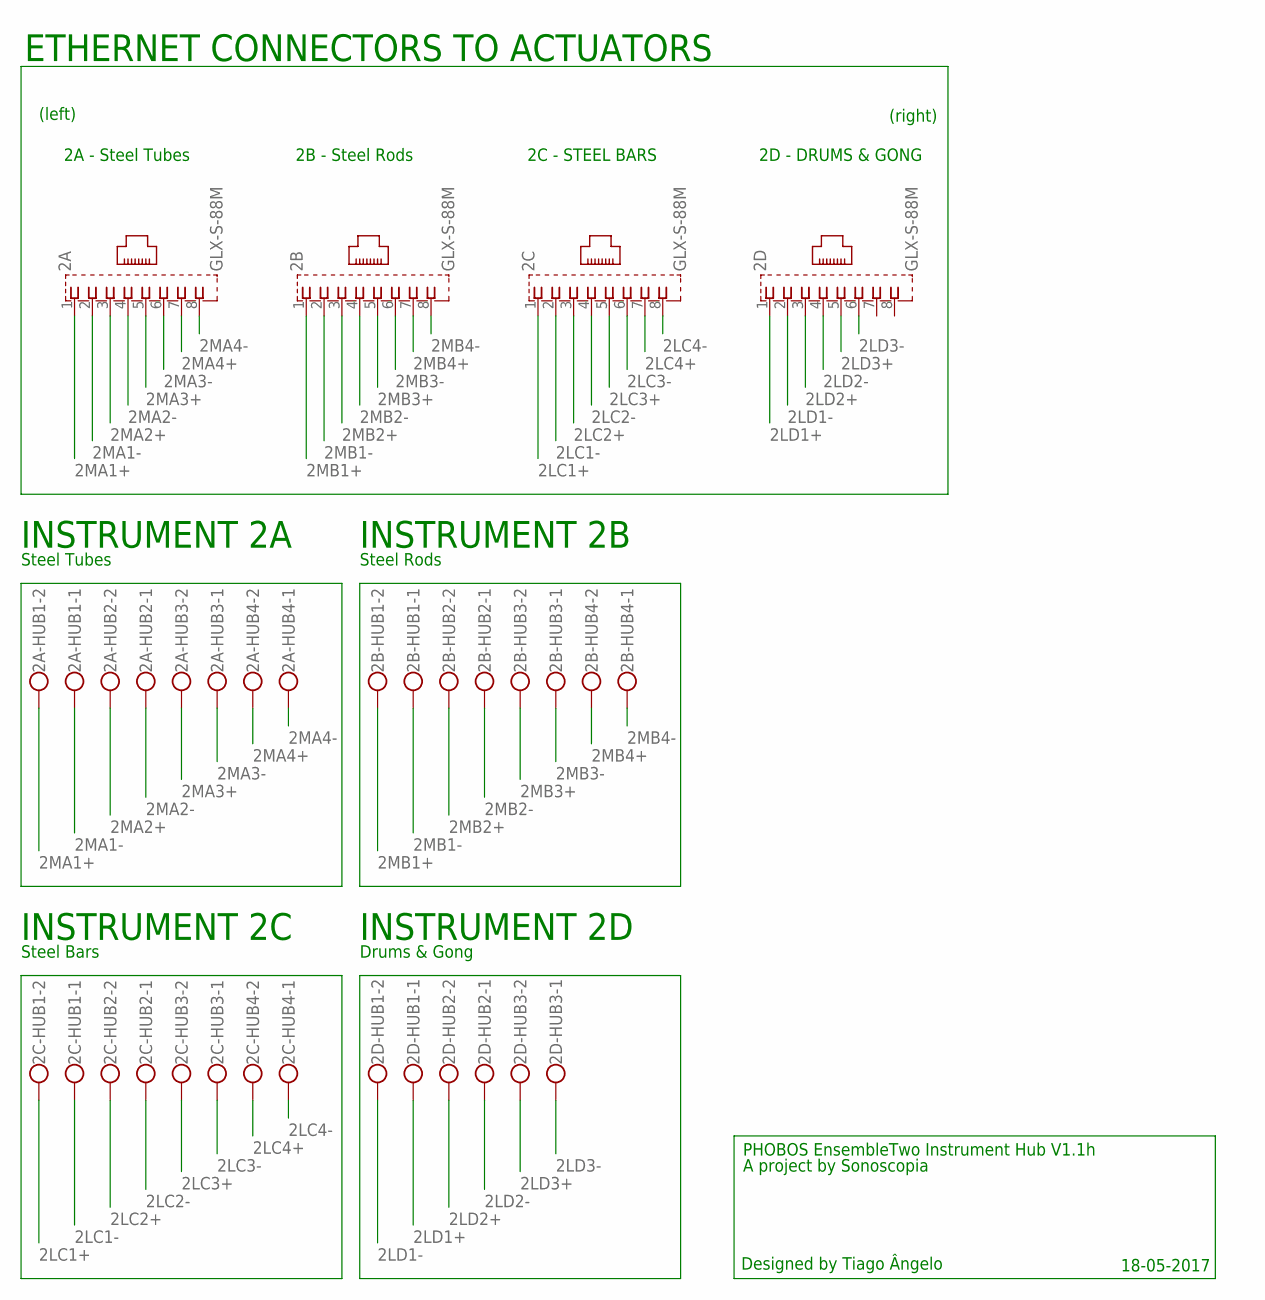
[picture p25: schematic InstrumentHubs.sch, sheet 2]

Parts:
2A, 2B, 2C, 2D: GLX-S-88M
2A-HUB1, 2A-HUB2, 2A-HUB3, 2A-HUB4, 2B-HUB1, 2B-HUB2, 2B-HUB3, 2B-HUB4, 2C-HUB1, 2C-HUB2, 2C-HUB3, 2C-HUB4, 2D-HUB1, 2D-HUB2, 2D-HUB3: W237-102

Connections:
2LC1+: 2C.1, 2C-HUB1.2
2LC1-: 2C.2, 2C-HUB1.1
2LC2+: 2C.3, 2C-HUB2.2
2LC2-: 2C.4, 2C-HUB2.1
2LC3+: 2C.5, 2C-HUB3.2
2LC3-: 2C.6, 2C-HUB3.1
2LC4+: 2C.7, 2C-HUB4.2
2LC4-: 2C.8, 2C-HUB4.1
2LD1+: 2D.1, 2D-HUB1.1
2LD1-: 2D.2, 2D-HUB1.2
2LD2+: 2D.3, 2D-HUB2.2
2LD2-: 2D.4, 2D-HUB2.1
2LD3+: 2D.5, 2D-HUB3.2
2LD3-: 2D.6, 2D-HUB3.1
2MA1+: 2A.1, 2A-HUB1.2
2MA1-: 2A.2, 2A-HUB1.1
2MA2+: 2A.3, 2A-HUB2.2
2MA2-: 2A.4, 2A-HUB2.1
2MA3+: 2A.5, 2A-HUB3.2
2MA3-: 2A.6, 2A-HUB3.1
2MA4+: 2A.7, 2A-HUB4.2
2MA4-: 2A.8, 2A-HUB4.1
2MB1+: 2B.1, 2B-HUB1.2
2MB1-: 2B.2, 2B-HUB1.1
2MB2+: 2B.3, 2B-HUB2.2
2MB2-: 2B.4, 2B-HUB2.1
2MB3+: 2B.5, 2B-HUB3.2
2MB3-: 2B.6, 2B-HUB3.1
2MB4+: 2B.7, 2B-HUB4.2
2MB4-: 2B.8, 2B-HUB4.1

Notes on the sheet:
INSTRUMENT 2A
PHOBOS EnsembleTwo Instrument Hub V1.1h
Designed by Tiago Ângelo
A project by Sonoscopia
18-05-2017
Steel Tubes
INSTRUMENT 2B
Steel Rods
INSTRUMENT 2C
Steel Bars
INSTRUMENT 2D
Drums & Gong
(right)
(left)
ETHERNET CONNECTORS TO ACTUATORS
2D - DRUMS & GONG
2C - STEEL BARS
2B - Steel Rods
2A - Steel Tubes
