Sonoscopia/Phobos/Boards and Schematics/InstrumentHubs/InstrumentHubs.brd

## EAGLE design Boards and Schematics/InstrumentHubs/InstrumentHubs.brd (continued)

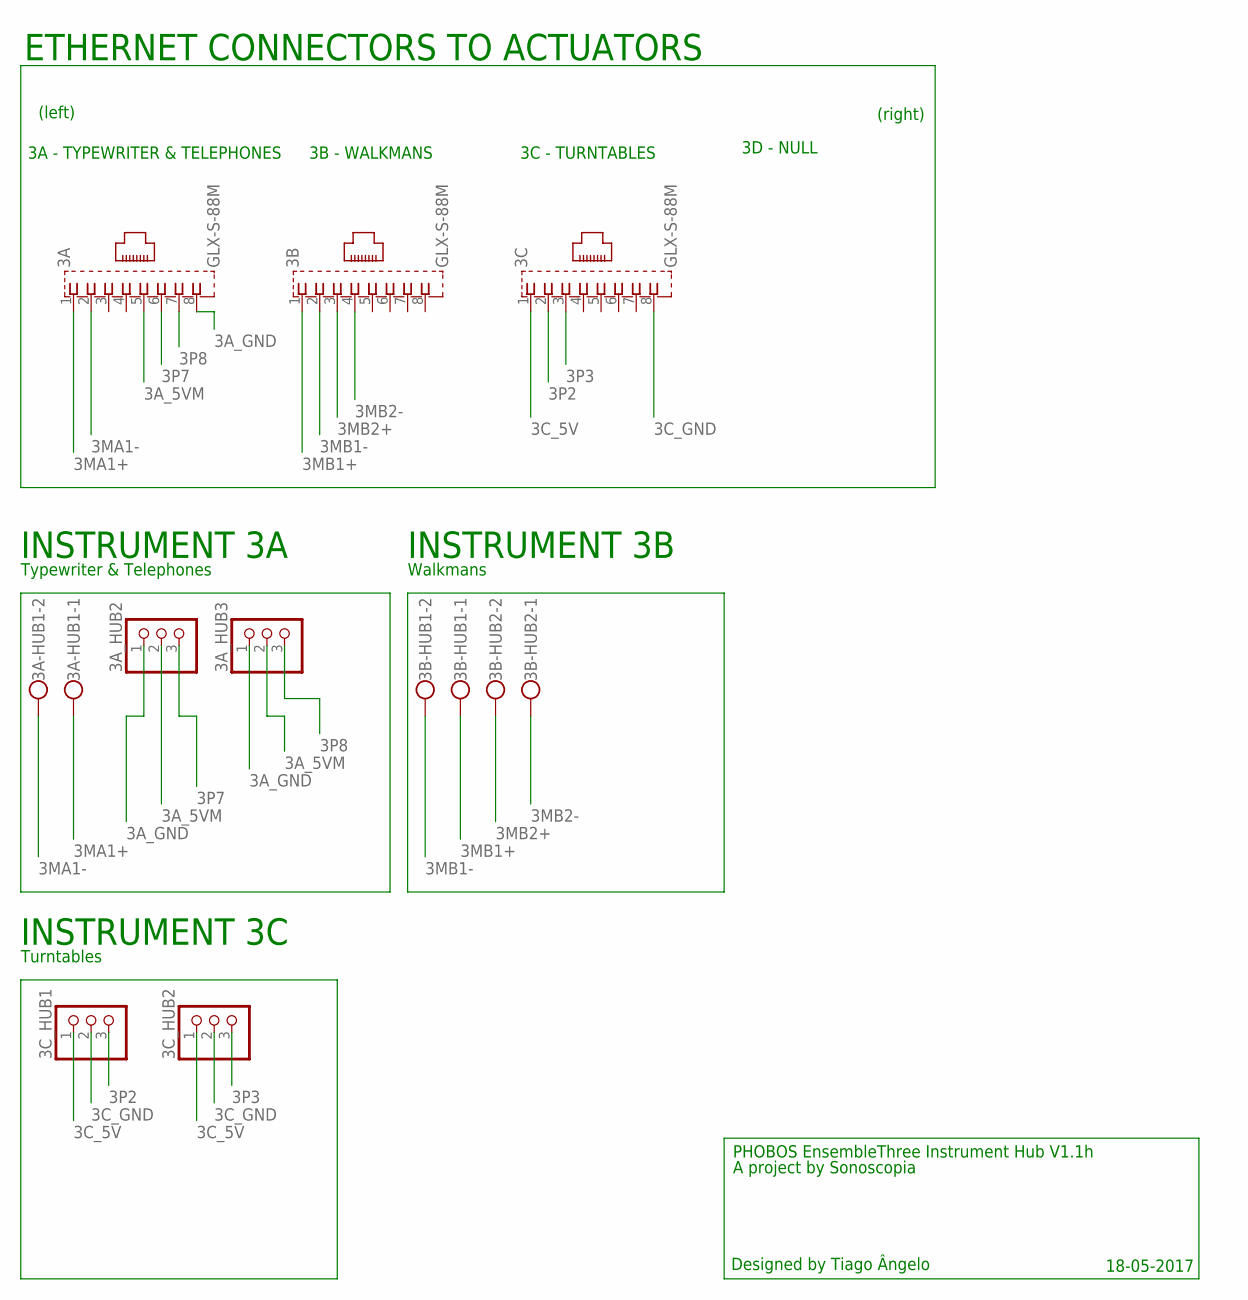
[picture p26: schematic InstrumentHubs.sch, sheet 3]

Parts:
3A, 3B, 3C: GLX-S-88M
3A-HUB1, 3B-HUB1, 3B-HUB2: W237-102
3A_HUB2, 3A_HUB3, 3C_HUB1, 3C_HUB2: PINHD-1X3; 1X03

Connections:
3A_5VM: 3A.5, 3A_HUB2.2, 3A_HUB3.2
3A_GND: 3A.8, 3A_HUB2.1, 3A_HUB3.1
3C_5V: 3C.1, 3C_HUB1.1, 3C_HUB2.1
3C_GND: 3C.8, 3C_HUB1.2, 3C_HUB2.2
3MA1+: 3A.1, 3A-HUB1.1
3MA1-: 3A.2, 3A-HUB1.2
3MB1+: 3B.1, 3B-HUB1.1
3MB1-: 3B.2, 3B-HUB1.2
3MB2+: 3B.3, 3B-HUB2.2
3MB2-: 3B.4, 3B-HUB2.1
3P2: 3C.2, 3C_HUB1.3
3P3: 3C.3, 3C_HUB2.3
3P7: 3A.6, 3A_HUB2.3
3P8: 3A.7, 3A_HUB3.3

Notes on the sheet:
INSTRUMENT 3A
PHOBOS EnsembleThree Instrument Hub V1.1h
Designed by Tiago Ângelo
A project by Sonoscopia
18-05-2017
Typewriter & Telephones
INSTRUMENT 3B
Walkmans
INSTRUMENT 3C
Turntables
(right)
(left)
ETHERNET CONNECTORS TO ACTUATORS
3C - TURNTABLES
3B - WALKMANS
3A - TYPEWRITER & TELEPHONES
3D - NULL

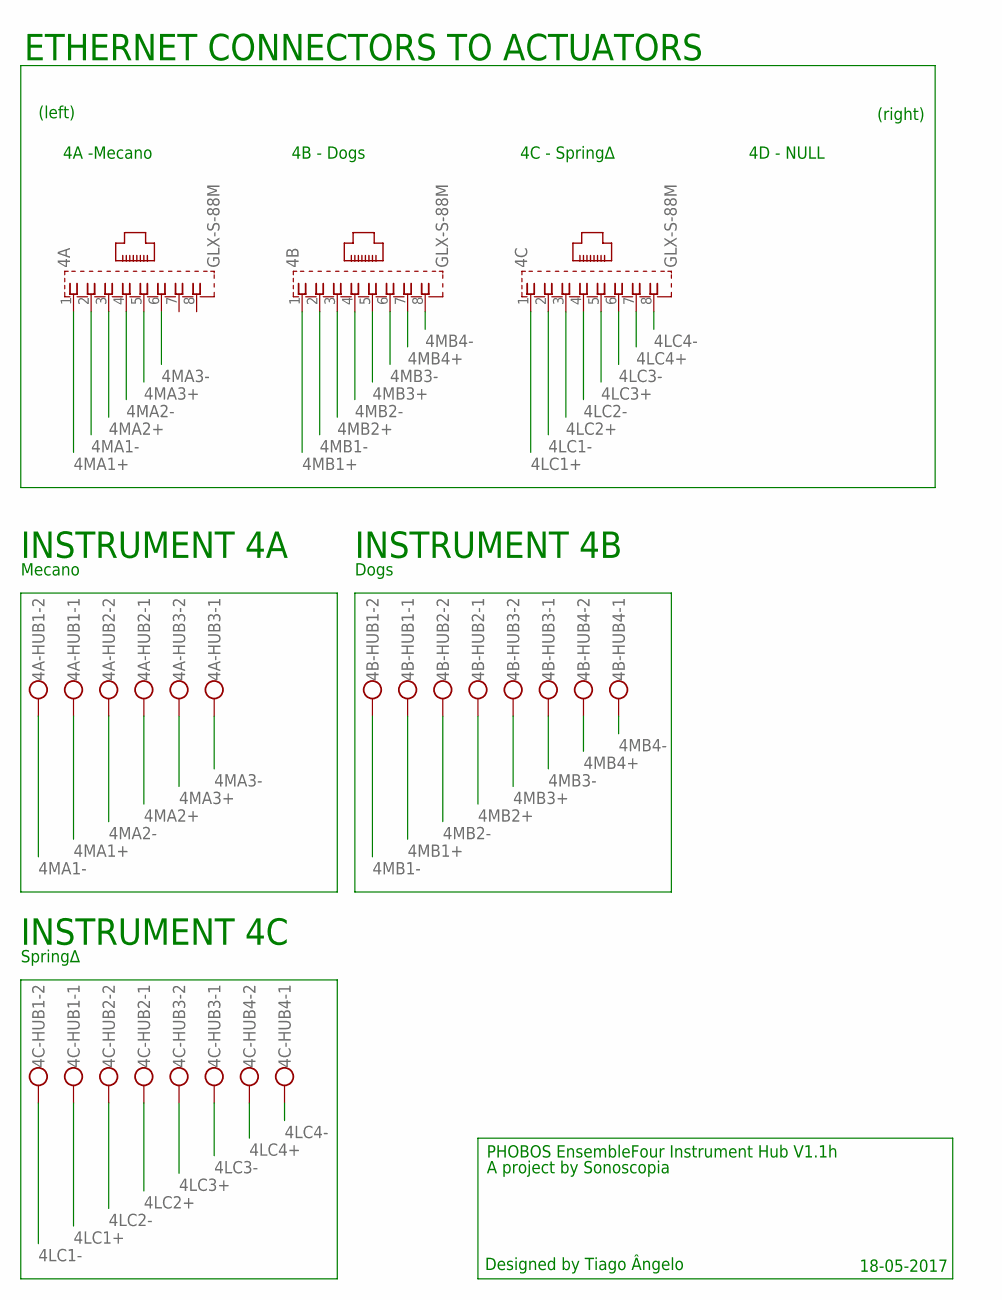
[picture p27: schematic InstrumentHubs.sch, sheet 4]

Parts:
4A, 4B, 4C: GLX-S-88M
4A-HUB1, 4A-HUB2, 4A-HUB3, 4B-HUB1, 4B-HUB2, 4B-HUB3, 4B-HUB4, 4C-HUB1, 4C-HUB2, 4C-HUB3, 4C-HUB4: W237-102

Connections:
4LC1+: 4C.1, 4C-HUB1.1
4LC1-: 4C.2, 4C-HUB1.2
4LC2+: 4C.3, 4C-HUB2.1
4LC2-: 4C.4, 4C-HUB2.2
4LC3+: 4C.5, 4C-HUB3.2
4LC3-: 4C.6, 4C-HUB3.1
4LC4+: 4C.7, 4C-HUB4.2
4LC4-: 4C.8, 4C-HUB4.1
4MA1+: 4A.1, 4A-HUB1.1
4MA1-: 4A.2, 4A-HUB1.2
4MA2+: 4A.3, 4A-HUB2.1
4MA2-: 4A.4, 4A-HUB2.2
4MA3+: 4A.5, 4A-HUB3.2
4MA3-: 4A.6, 4A-HUB3.1
4MB1+: 4B.1, 4B-HUB1.1
4MB1-: 4B.2, 4B-HUB1.2
4MB2+: 4B.3, 4B-HUB2.1
4MB2-: 4B.4, 4B-HUB2.2
4MB3+: 4B.5, 4B-HUB3.2
4MB3-: 4B.6, 4B-HUB3.1
4MB4+: 4B.7, 4B-HUB4.2
4MB4-: 4B.8, 4B-HUB4.1

Notes on the sheet:
INSTRUMENT 4A
PHOBOS EnsembleFour Instrument Hub V1.1h
Designed by Tiago Ângelo
A project by Sonoscopia
18-05-2017
Mecano
INSTRUMENT 4B
Dogs
INSTRUMENT 4C
Spring∆
(right)
(left)
ETHERNET CONNECTORS TO ACTUATORS
4D - NULL
4C - Spring∆
4B - Dogs
4A -Mecano

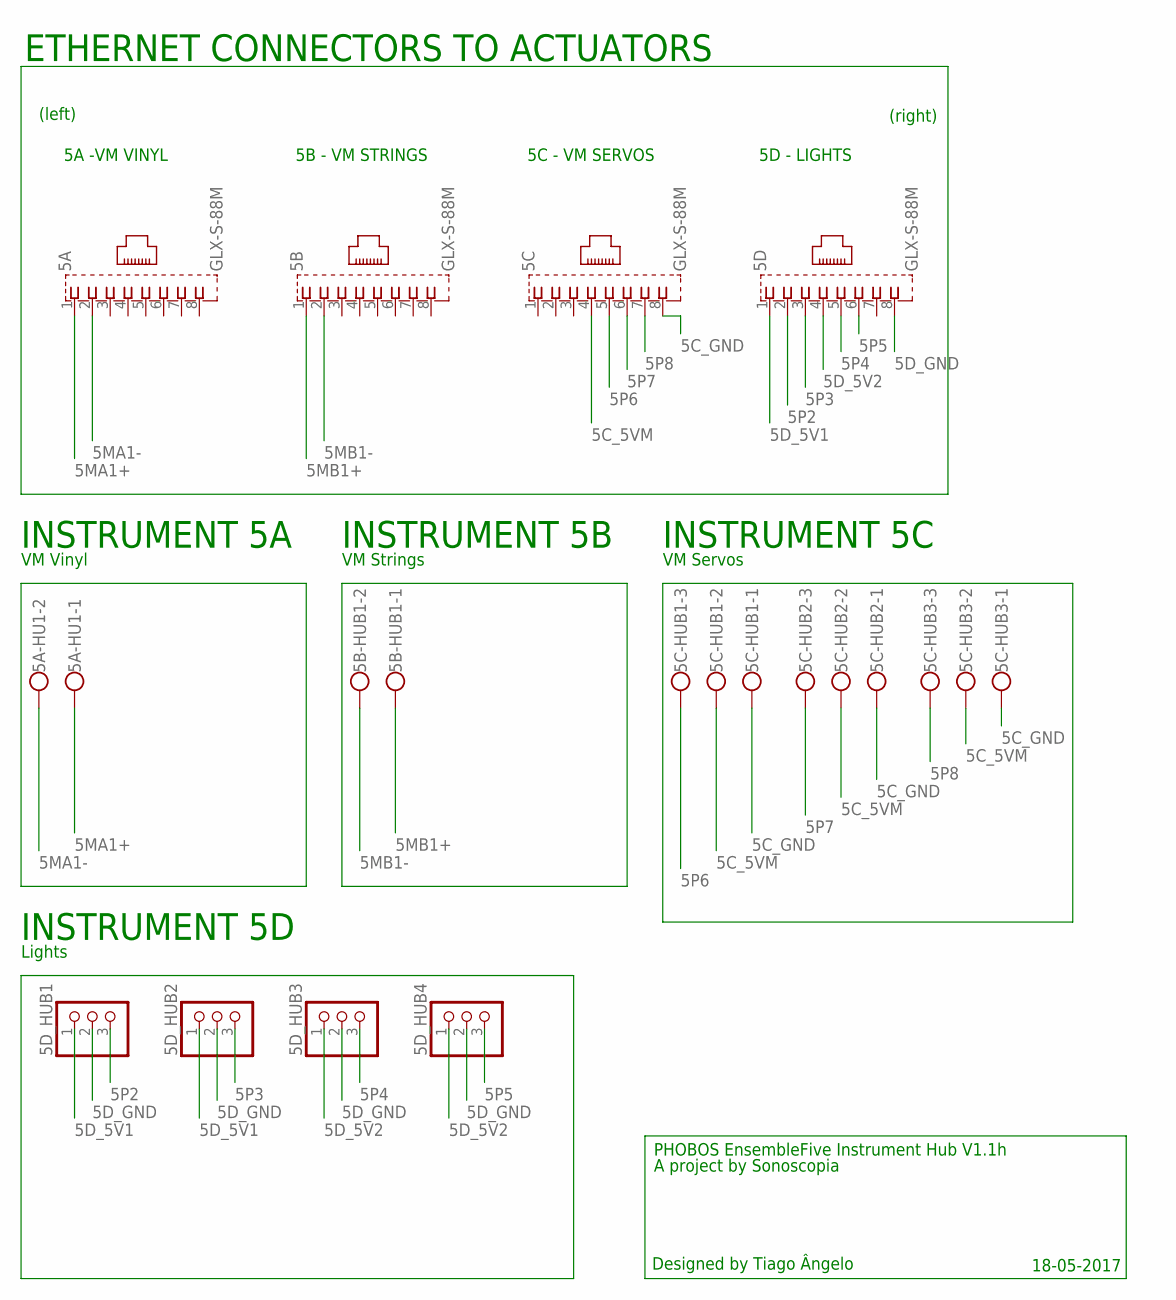
[picture p28: schematic InstrumentHubs.sch, sheet 5]

Parts:
5A, 5B, 5C, 5D: GLX-S-88M
5A-HU1, 5B-HUB1: W237-102
5C-HUB1, 5C-HUB2, 5C-HUB3: W237-103
5D_HUB1, 5D_HUB2, 5D_HUB3, 5D_HUB4: PINHD-1X3; 1X03

Connections:
5C_5VM: 5C.4, 5C-HUB1.2, 5C-HUB2.2, 5C-HUB3.2
5C_GND: 5C.8, 5C-HUB1.1, 5C-HUB2.1, 5C-HUB3.1
5D_5V1: 5D.1, 5D_HUB1.1, 5D_HUB2.1
5D_5V2: 5D.4, 5D_HUB3.1, 5D_HUB4.1
5D_GND: 5D.8, 5D_HUB1.2, 5D_HUB2.2, 5D_HUB3.2, 5D_HUB4.2
5MA1+: 5A.1, 5A-HU1.1
5MA1-: 5A.2, 5A-HU1.2
5MB1+: 5B.1, 5B-HUB1.1
5MB1-: 5B.2, 5B-HUB1.2
5P2: 5D.2, 5D_HUB1.3
5P3: 5D.3, 5D_HUB2.3
5P4: 5D.5, 5D_HUB3.3
5P5: 5D.6, 5D_HUB4.3
5P6: 5C.5, 5C-HUB1.3
5P7: 5C.6, 5C-HUB2.3
5P8: 5C.7, 5C-HUB3.3

Notes on the sheet:
INSTRUMENT 5A
PHOBOS EnsembleFive Instrument Hub V1.1h
Designed by Tiago Ângelo
A project by Sonoscopia
18-05-2017
VM Vinyl
INSTRUMENT 5B
VM Strings
INSTRUMENT 5C
VM Servos
(right)
(left)
ETHERNET CONNECTORS TO ACTUATORS
5D - LIGHTS
5C - VM SERVOS
5B - VM STRINGS
5A -VM VINYL
INSTRUMENT 5D
Lights

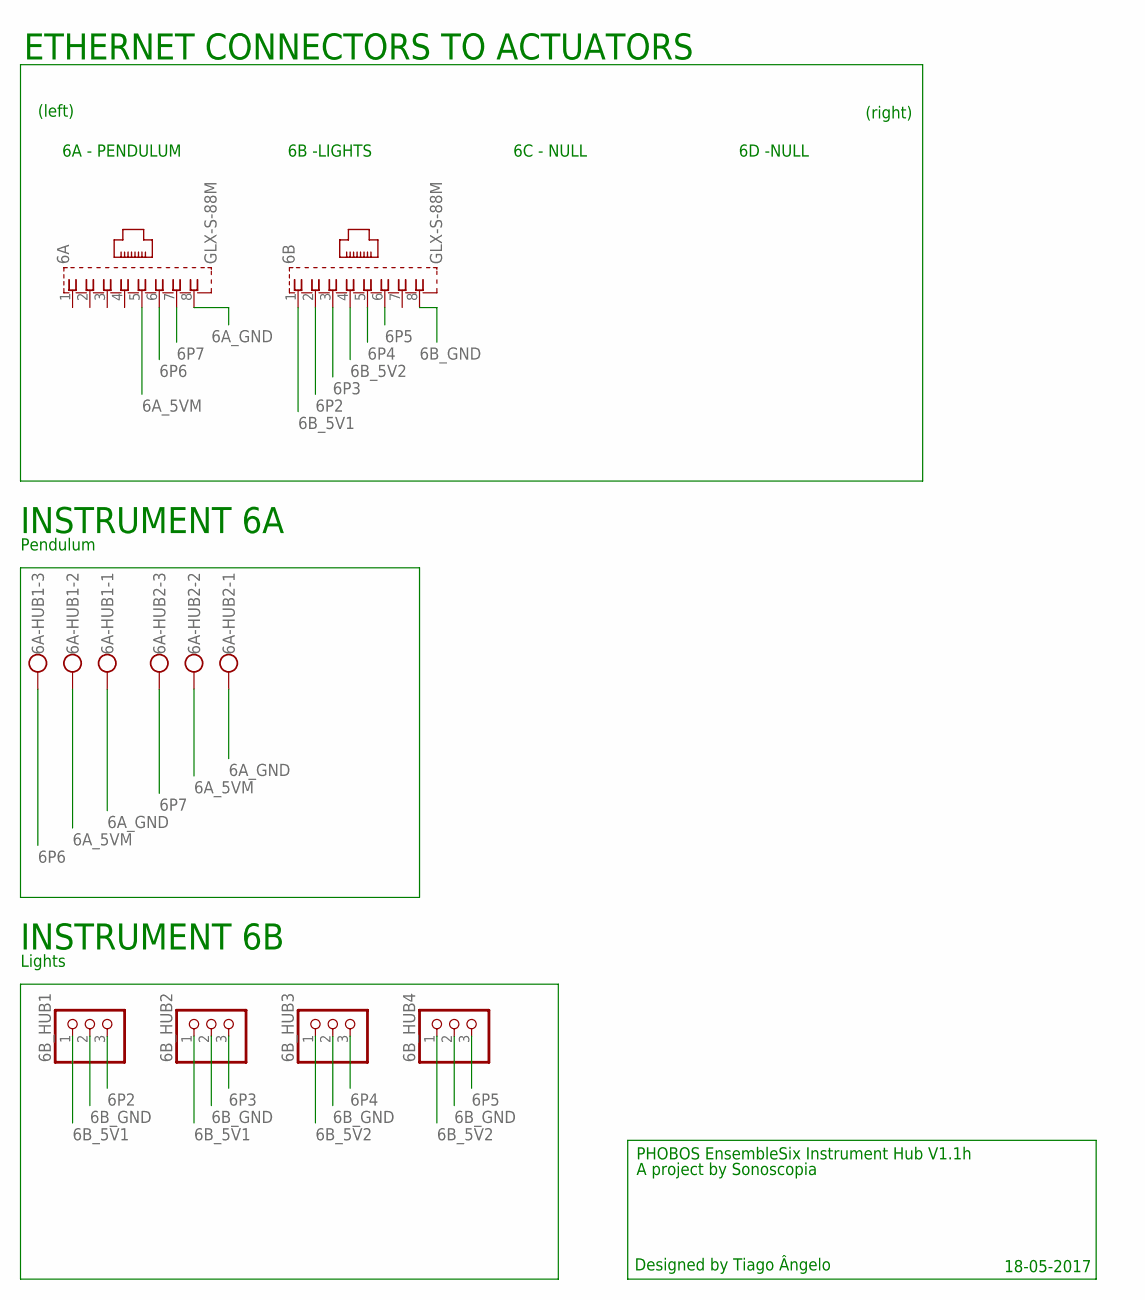
[picture p29: schematic InstrumentHubs.sch, sheet 6]

Parts:
6A, 6B: GLX-S-88M
6A-HUB1, 6A-HUB2: W237-103
6B_HUB1, 6B_HUB2, 6B_HUB3, 6B_HUB4: PINHD-1X3; 1X03

Connections:
6A_5VM: 6A.5, 6A-HUB1.2, 6A-HUB2.2
6A_GND: 6A.8, 6A-HUB1.1, 6A-HUB2.1
6B_5V1: 6B.1, 6B_HUB1.1, 6B_HUB2.1
6B_5V2: 6B.4, 6B_HUB3.1, 6B_HUB4.1
6B_GND: 6B.8, 6B_HUB1.2, 6B_HUB2.2, 6B_HUB3.2, 6B_HUB4.2
6P2: 6B.2, 6B_HUB1.3
6P3: 6B.3, 6B_HUB2.3
6P4: 6B.5, 6B_HUB3.3
6P5: 6B.6, 6B_HUB4.3
6P6: 6A.6, 6A-HUB1.3
6P7: 6A.7, 6A-HUB2.3

Notes on the sheet:
PHOBOS EnsembleSix Instrument Hub V1.1h
Designed by Tiago Ângelo
A project by Sonoscopia
18-05-2017
INSTRUMENT 6A
Pendulum
INSTRUMENT 6B
Lights
(right)
(left)
ETHERNET CONNECTORS TO ACTUATORS
6D -NULL
6C - NULL
6B -LIGHTS
6A - PENDULUM

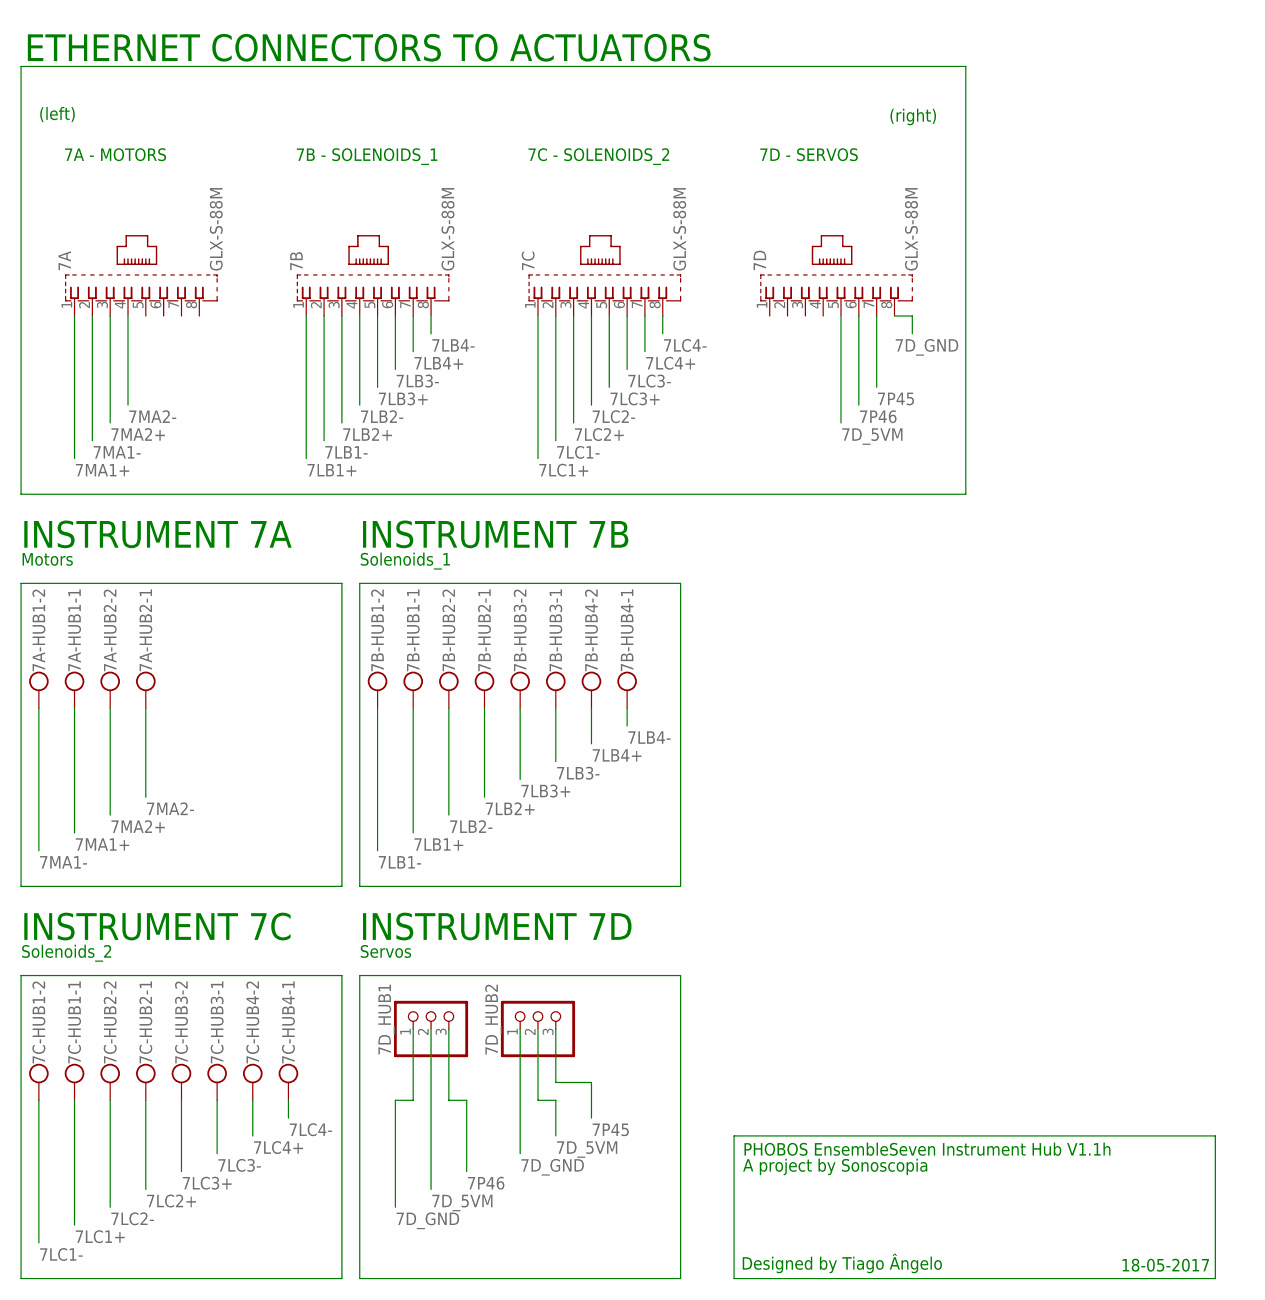
[picture p30: schematic InstrumentHubs.sch, sheet 7]

Parts:
7A, 7B, 7C, 7D: GLX-S-88M
7A-HUB1, 7A-HUB2, 7B-HUB1, 7B-HUB2, 7B-HUB3, 7B-HUB4, 7C-HUB1, 7C-HUB2, 7C-HUB3, 7C-HUB4: W237-102
7D_HUB1, 7D_HUB2: PINHD-1X3; 1X03

Connections:
7D_5VM: 7D.5, 7D_HUB1.2, 7D_HUB2.2
7D_GND: 7D.8, 7D_HUB1.1, 7D_HUB2.1
7LB1+: 7B.1, 7B-HUB1.1
7LB1-: 7B.2, 7B-HUB1.2
7LB2+: 7B.3, 7B-HUB2.1
7LB2-: 7B.4, 7B-HUB2.2
7LB3+: 7B.5, 7B-HUB3.2
7LB3-: 7B.6, 7B-HUB3.1
7LB4+: 7B.7, 7B-HUB4.2
7LB4-: 7B.8, 7B-HUB4.1
7LC1+: 7C.1, 7C-HUB1.1
7LC1-: 7C.2, 7C-HUB1.2
7LC2+: 7C.3, 7C-HUB2.1
7LC2-: 7C.4, 7C-HUB2.2
7LC3+: 7C.5, 7C-HUB3.2
7LC3-: 7C.6, 7C-HUB3.1
7LC4+: 7C.7, 7C-HUB4.2
7LC4-: 7C.8, 7C-HUB4.1
7MA1+: 7A.1, 7A-HUB1.1
7MA1-: 7A.2, 7A-HUB1.2
7MA2+: 7A.3, 7A-HUB2.2
7MA2-: 7A.4, 7A-HUB2.1
7P45: 7D.7, 7D_HUB2.3
7P46: 7D.6, 7D_HUB1.3

Notes on the sheet:
INSTRUMENT 7A
PHOBOS EnsembleSeven Instrument Hub V1.1h
Designed by Tiago Ângelo
A project by Sonoscopia
18-05-2017
Motors
INSTRUMENT 7B
Solenoids_1
INSTRUMENT 7C
Solenoids_2
INSTRUMENT 7D
Servos
(right)
(left)
ETHERNET CONNECTORS TO ACTUATORS
7D - SERVOS
7C - SOLENOIDS_2
7B - SOLENOIDS_1
7A - MOTORS

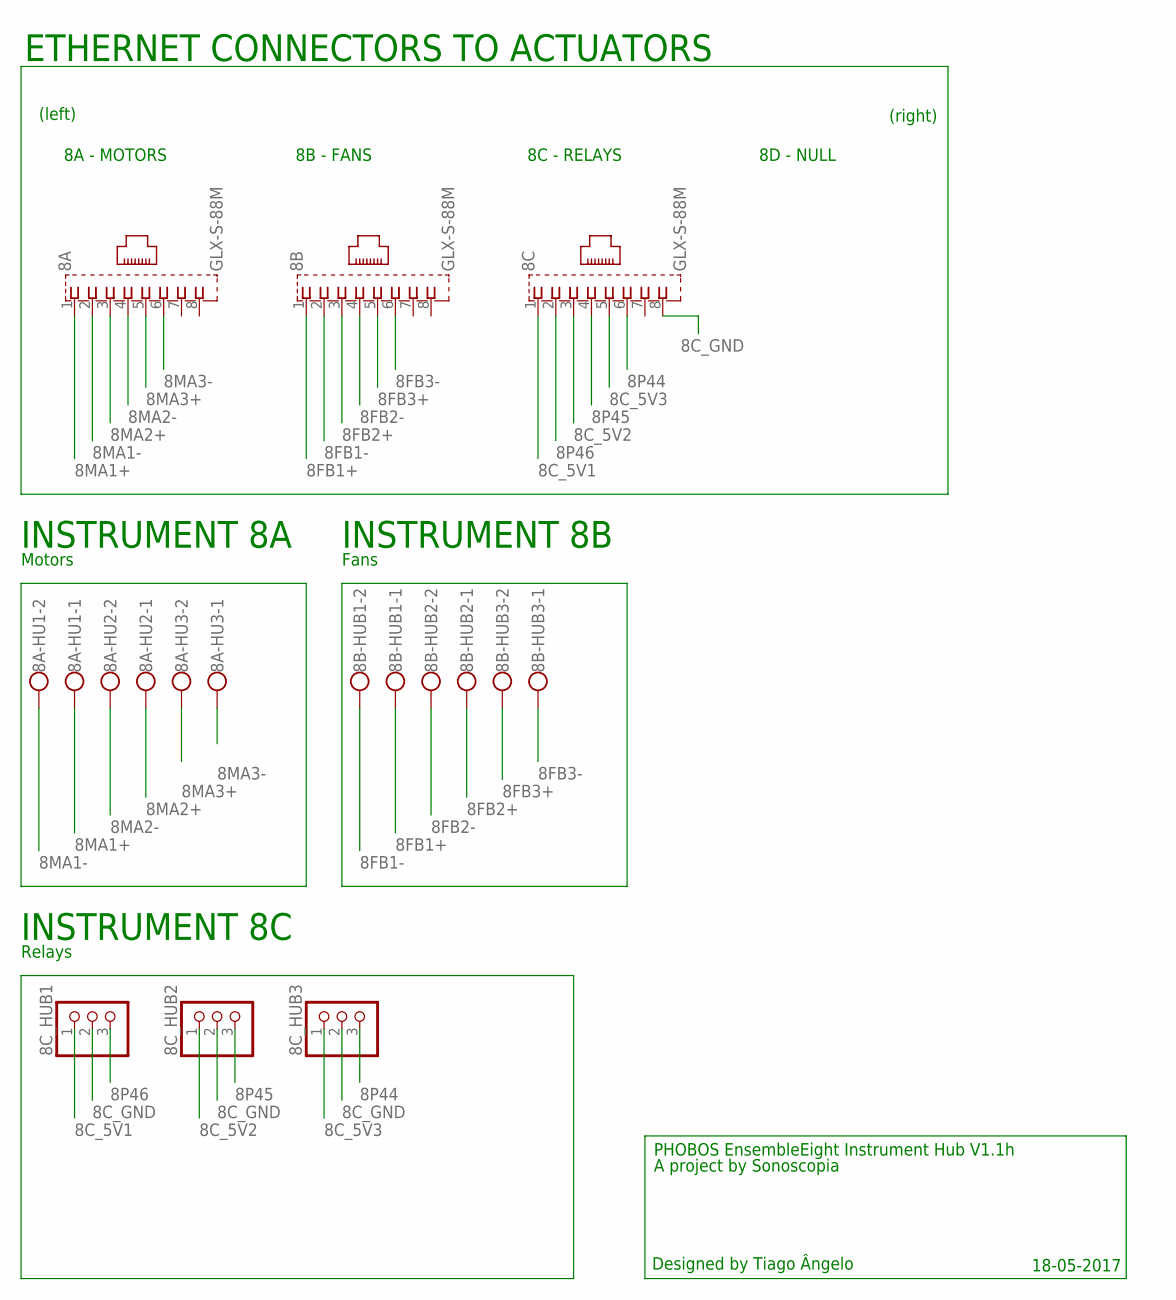
[picture p31: schematic InstrumentHubs.sch, sheet 8]

Parts:
8A, 8B, 8C: GLX-S-88M
8A-HU1, 8A-HU2, 8A-HU3, 8B-HUB1, 8B-HUB2, 8B-HUB3: W237-102
8C_HUB1, 8C_HUB2, 8C_HUB3: PINHD-1X3; 1X03

Connections:
8C_5V1: 8C.1, 8C_HUB1.1
8C_5V2: 8C.3, 8C_HUB2.1
8C_5V3: 8C.5, 8C_HUB3.1
8C_GND: 8C.8, 8C_HUB1.2, 8C_HUB2.2, 8C_HUB3.2
8FB1+: 8B.1, 8B-HUB1.1
8FB1-: 8B.2, 8B-HUB1.2
8FB2+: 8B.3, 8B-HUB2.1
8FB2-: 8B.4, 8B-HUB2.2
8FB3+: 8B.5, 8B-HUB3.2
8FB3-: 8B.6, 8B-HUB3.1
8MA1+: 8A.1, 8A-HU1.1
8MA1-: 8A.2, 8A-HU1.2
8MA2+: 8A.3, 8A-HU2.1
8MA2-: 8A.4, 8A-HU2.2
8MA3+: 8A.5, 8A-HU3.2
8MA3-: 8A.6, 8A-HU3.1
8P44: 8C.6, 8C_HUB3.3
8P45: 8C.4, 8C_HUB2.3
8P46: 8C.2, 8C_HUB1.3

Notes on the sheet:
INSTRUMENT 8A
PHOBOS EnsembleEight Instrument Hub V1.1h
Designed by Tiago Ângelo
A project by Sonoscopia
18-05-2017
Motors
INSTRUMENT 8B
Fans
INSTRUMENT 8C
Relays
(right)
(left)
ETHERNET CONNECTORS TO ACTUATORS
8D - NULL
8C - RELAYS
8B - FANS
8A - MOTORS

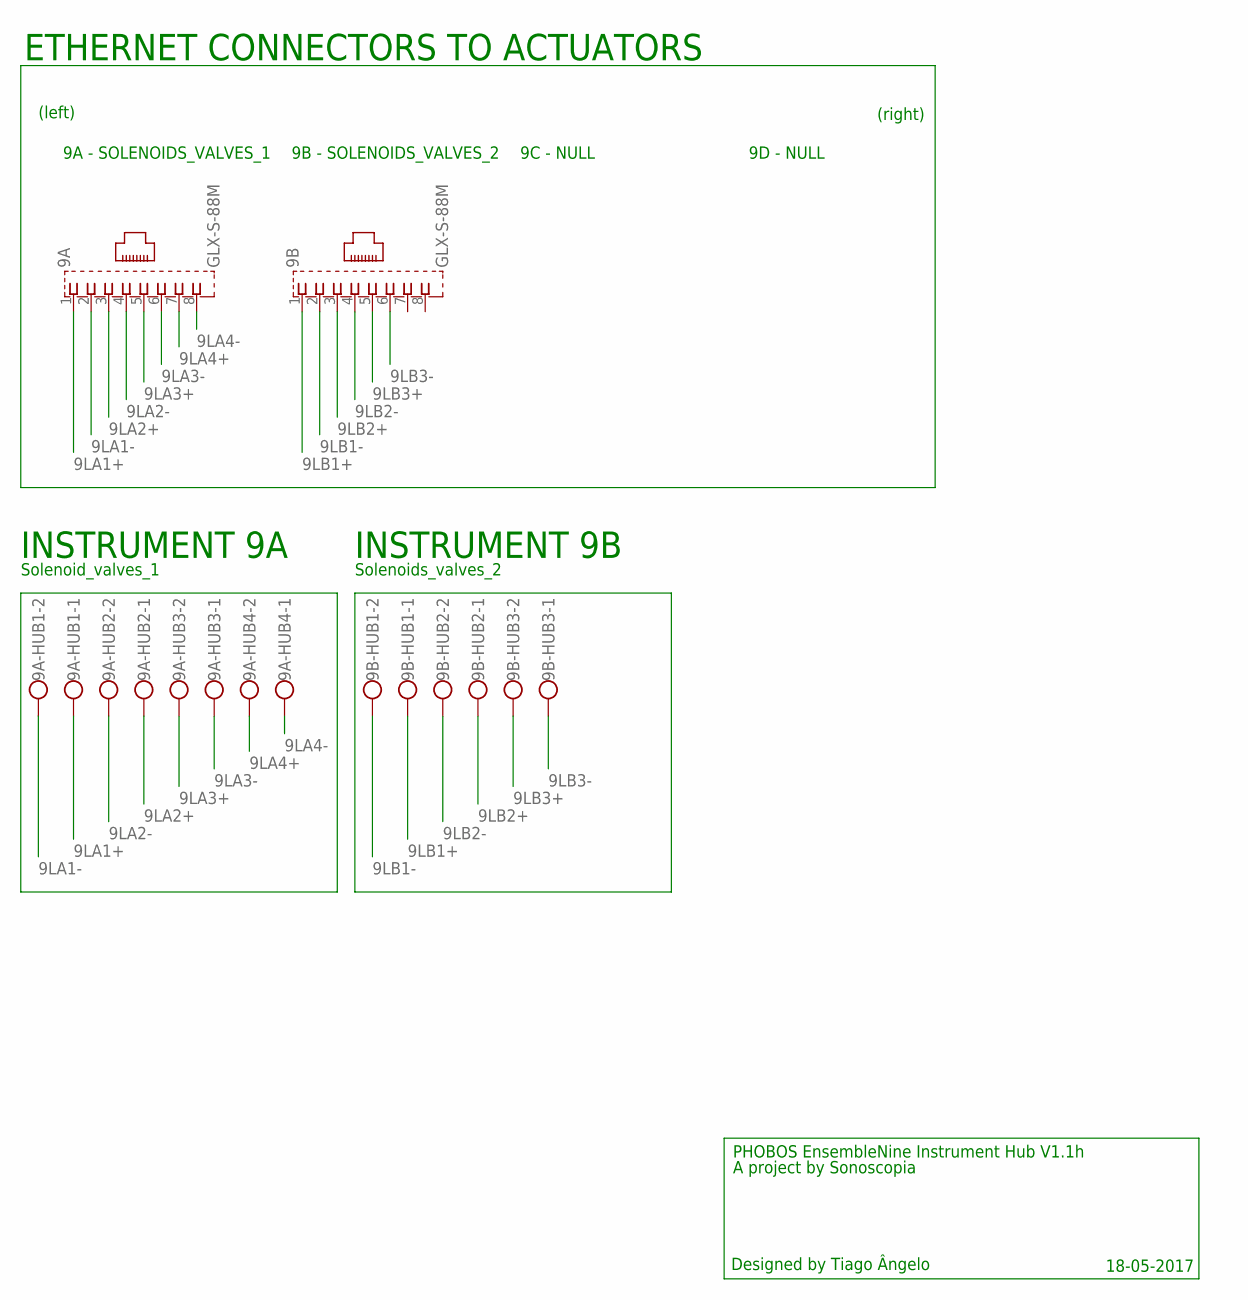
[picture p32: schematic InstrumentHubs.sch, sheet 9]

Parts:
9A, 9B: GLX-S-88M
9A-HUB1, 9A-HUB2, 9A-HUB3, 9A-HUB4, 9B-HUB1, 9B-HUB2, 9B-HUB3: W237-102

Connections:
9LA1+: 9A.1, 9A-HUB1.1
9LA1-: 9A.2, 9A-HUB1.2
9LA2+: 9A.3, 9A-HUB2.1
9LA2-: 9A.4, 9A-HUB2.2
9LA3+: 9A.5, 9A-HUB3.2
9LA3-: 9A.6, 9A-HUB3.1
9LA4+: 9A.7, 9A-HUB4.2
9LA4-: 9A.8, 9A-HUB4.1
9LB1+: 9B.1, 9B-HUB1.1
9LB1-: 9B.2, 9B-HUB1.2
9LB2+: 9B.3, 9B-HUB2.1
9LB2-: 9B.4, 9B-HUB2.2
9LB3+: 9B.5, 9B-HUB3.2
9LB3-: 9B.6, 9B-HUB3.1

Notes on the sheet:
INSTRUMENT 9A
PHOBOS EnsembleNine Instrument Hub V1.1h
Designed by Tiago Ângelo
A project by Sonoscopia
Solenoid_valves_1
INSTRUMENT 9B
Solenoids_valves_2
18-05-2017
(right)
(left)
ETHERNET CONNECTORS TO ACTUATORS
9D - NULL
9C - NULL
9B - SOLENOIDS_VALVES_2
9A - SOLENOIDS_VALVES_1

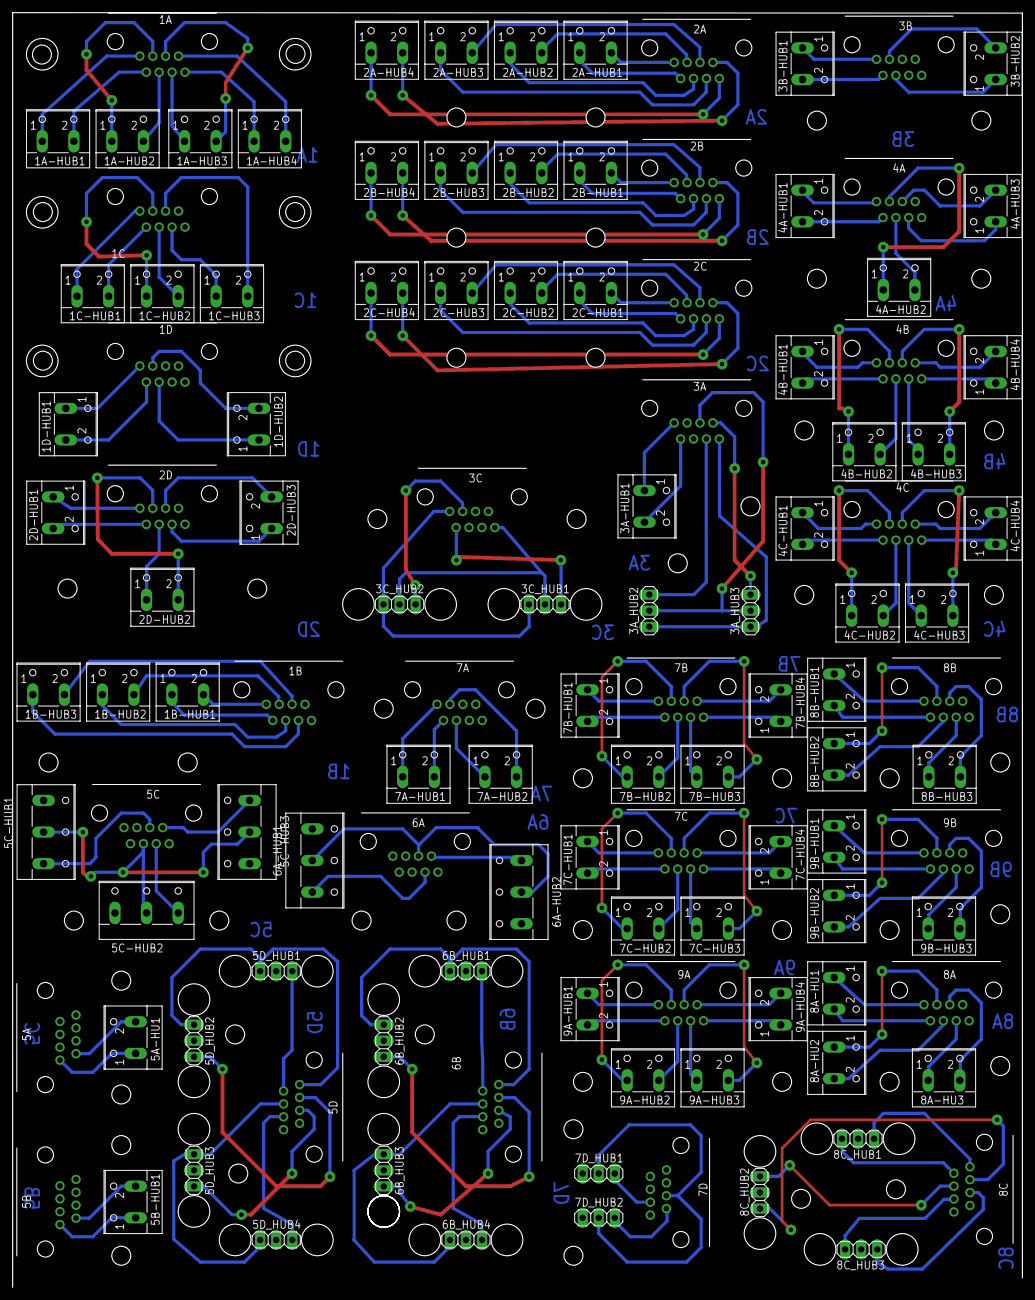
[picture p33: board InstrumentHubs.brd from above]

Board: 2 copper layers, 159.7 x 201.6 mm, 117 parts (0 on the bottom side), 174 nets.
