Sonoscopia/Phobos/Boards and Schematics/EnsembleSix/EnsembleSix.brd

## EAGLE design Boards and Schematics/EnsembleSix/EnsembleSix.brd (2025-08-14)

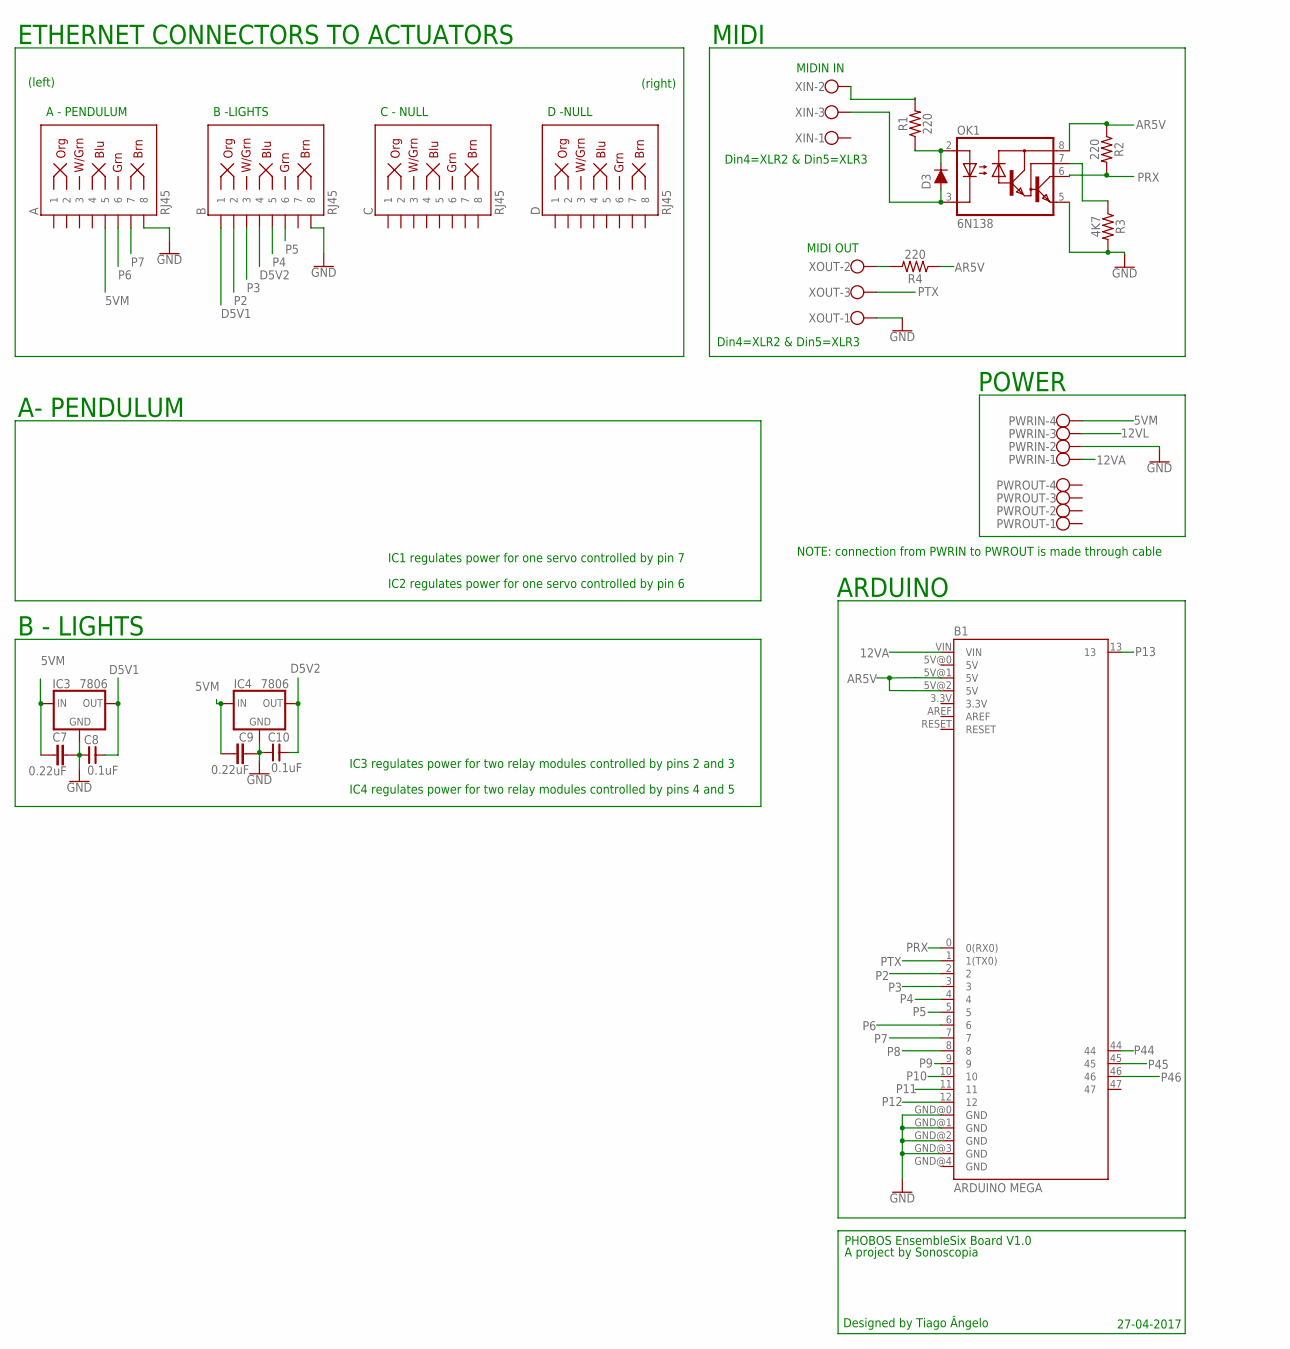
[picture p36: schematic EnsembleSix.sch]

Parts:
A: RJ45; RJ45-8
B: RJ45; RJ45-8
B1: ARDUINO MEGA; ARDUINO_MEGA
C: RJ45; RJ45-8
C7, C9: 0.22uF; C5B3
C8, C10: 0.1uF; C025-050X025
D: RJ45; RJ45-8
D3: 200mA/100V/1V; DIODE-1N4148
IC3, IC4: 7806; 78XXS
OK1: 6N138; DIL08
PWRIN: W237-4
PWROUT: W237-4
R1, R2, R4: 220; AXIAL-0.3
R3: 4K7; AXIAL-0.3
XIN: W237-103
XOUT: W237-103

Connections:
5VM: A.5, C7.1, C9.1, IC3.IN, IC4.IN, PWRIN.4
12VA: B1.VIN, PWRIN.1
12VL: PWRIN.3
AR5V: B1.5V@1 (5V), B1.5V@2 (5V), OK1.8 (VCC), R2.P$1 (1), R4.P$1 (1)
D5V1: B.1, C8.2, IC3.OUT
D5V2: B.4, C10.2, IC4.OUT
GND: A.8, B.8, B1.GND@0 (GND), B1.GND@1 (GND), B1.GND@2 (GND), B1.GND@3 (GND), C7.2, C8.1, C9.2, C10.1, IC3.GND, IC4.GND, OK1.5 (GND), PWRIN.2, R3.P$2 (2), XOUT.1
unnamed: R4.P$2 (2), XOUT.2
unnamed: D3.A, OK1.3 (C), XIN.3
unnamed: D3.C, OK1.2 (A), R1.P$1 (1)
unnamed: R1.P$2 (2), XIN.2
unnamed: OK1.7 (VB), R3.P$1 (1)
P2: B.2, B1.2
P3: B.3, B1.3
P4: B.5, B1.4
P5: B.6, B1.5
P6: A.6, B1.6
P7: A.7, B1.7
P8: B1.8
P9: B1.9
P10: B1.10
P11: B1.11
P12: B1.12
P13: B1.13
P44: B1.44
P45: B1.45
P46: B1.46
PRX: B1.0 (0(RX0)), OK1.6 (VO), R2.P$2 (2)
PTX: B1.1 (1(TX0)), XOUT.3

Notes on the sheet:
Din4=XLR2 & Din5=XLR3
MIDI OUT
MIDIN IN
POWER
MIDI
ARDUINO
(right)
(left)
ETHERNET CONNECTORS TO ACTUATORS
D -NULL
C - NULL
B -LIGHTS
A - PENDULUM
A- PENDULUM
PHOBOS EnsembleSix Board V1.0
Designed by Tiago Ângelo
A project by Sonoscopia
27-04-2017
B - LIGHTS
IC1 regulates power for one servo controlled by pin 7
IC2 regulates power for one servo controlled by pin 6
IC3 regulates power for two relay modules controlled by pins 2 and 3
IC4 regulates power for two relay modules controlled by pins 4 and 5
NOTE: connection from PWRIN to PWROUT is made through cable

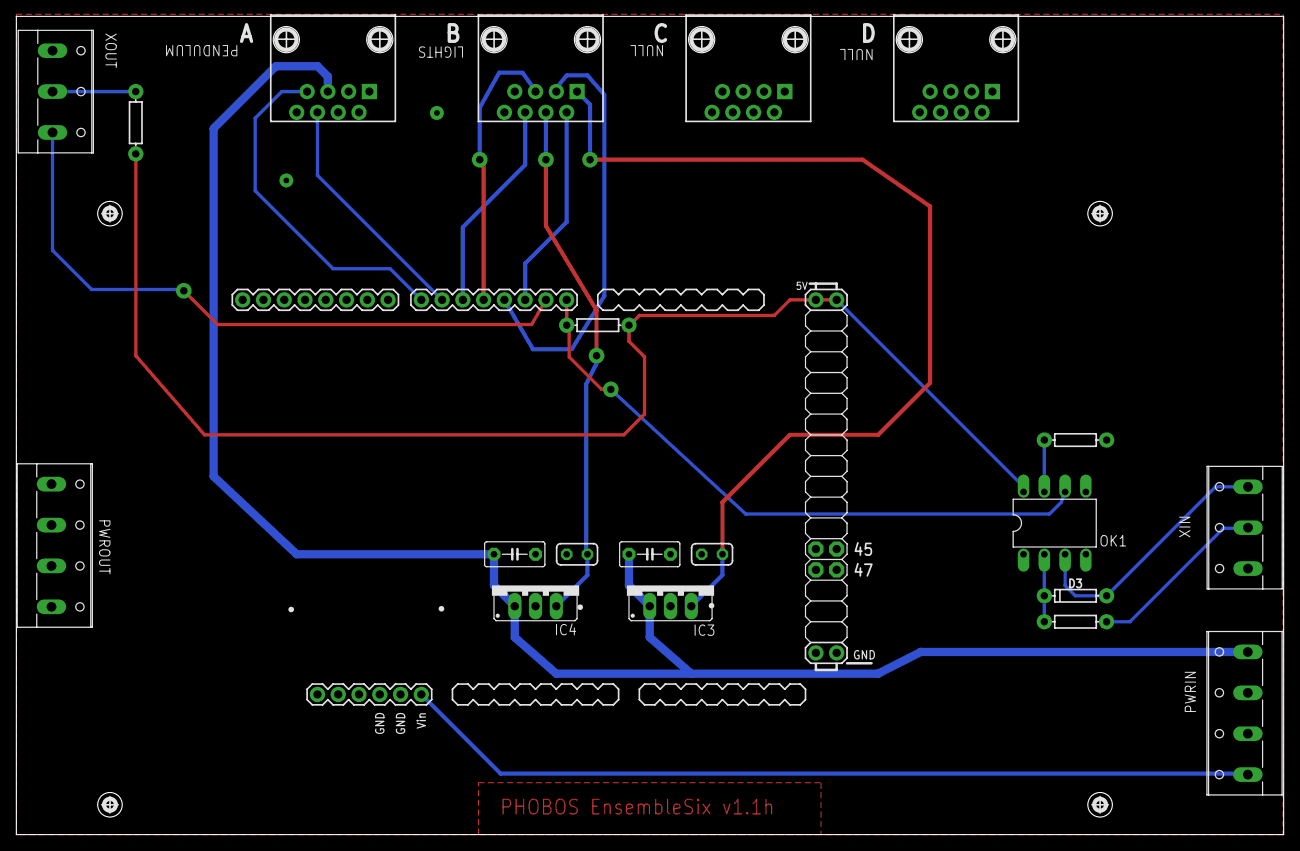
[picture p37: board EnsembleSix.brd from above]

Board: 2 copper layers, 155.0 x 100.1 mm, 21 parts (0 on the bottom side), 19 nets.
