Sonoscopia/Phobos/Boards and Schematics/Ensemble_ProtoBoard/Ensemble_ProtoBoard.brd

## EAGLE design Boards and Schematics/Ensemble_ProtoBoard/Ensemble_ProtoBoard.brd (2025-08-14)

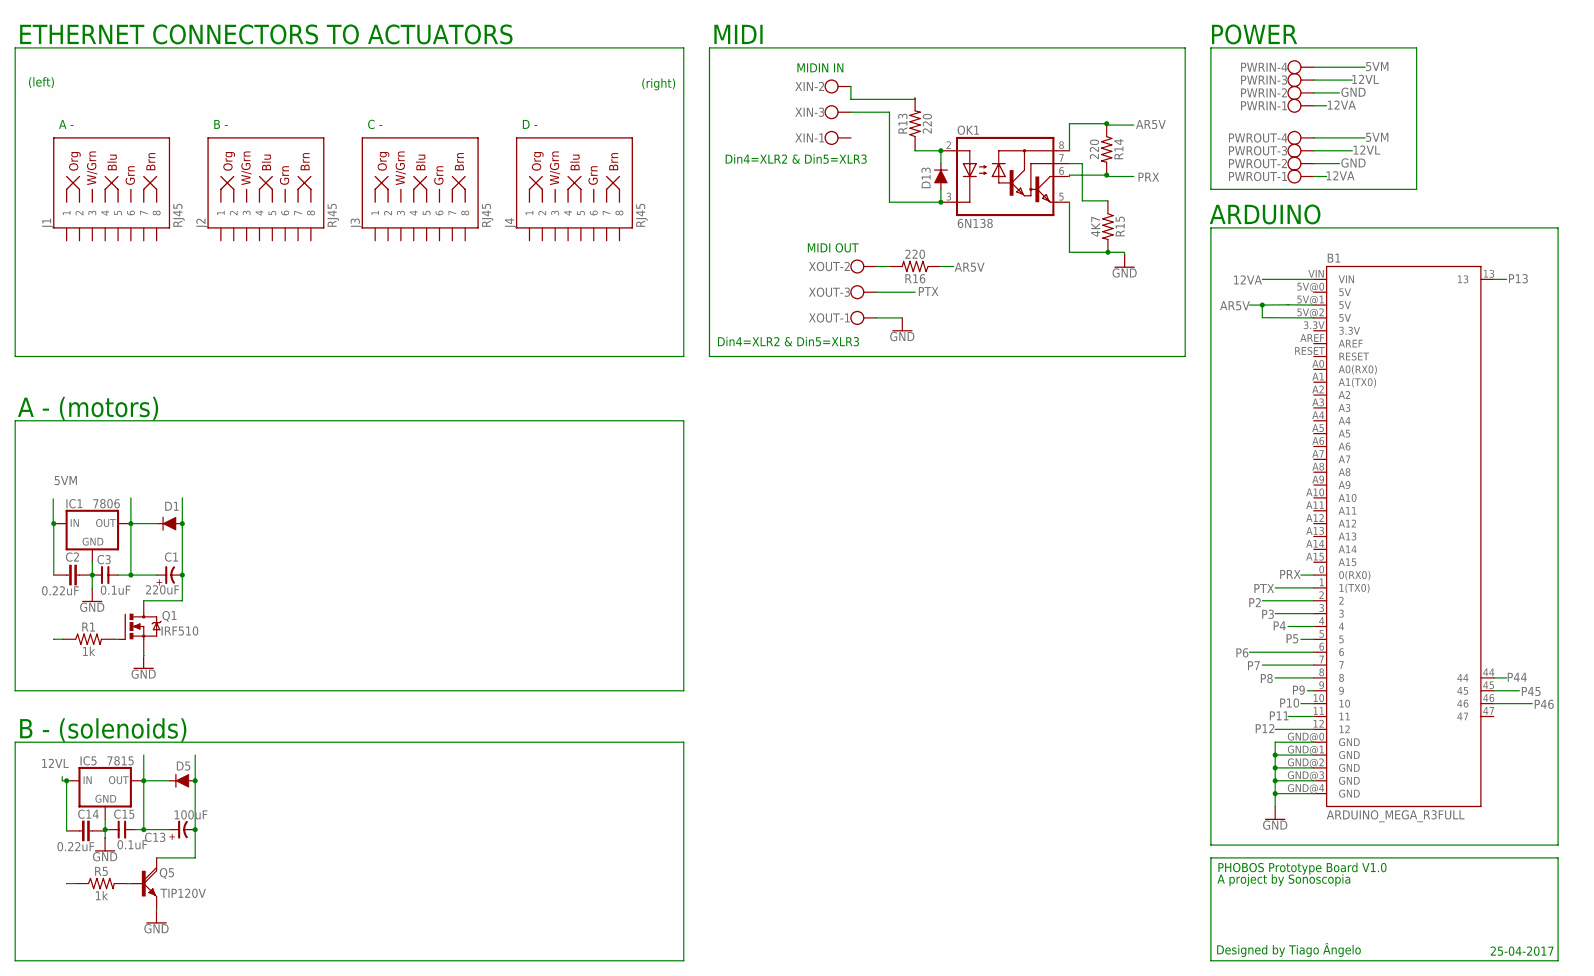
[picture p38: schematic Ensemble_ProtoBoard.sch]

Parts:
B1: ARDUINO_MEGA_R3FULL; ARDUINO_MEGA
C1: 220uF; E-035X080
C2, C14: 0.22uF; C5B3
C3, C15: 0.1uF; C025-050X025
C13: 100uF; E-020X050
D1, D5: 1A/50V/1.1V; DIODE-1N4001-KIT
D13: 200mA/100V/1V; DIODE-1N4148
IC1: 7806; 78XXS
IC5: 7815; 78XXS
J1, J2, J3, J4: RJ45; RJ45-8
OK1: 6N138; DIL08
PWRIN: W237-4
PWROUT: W237-4
Q1: IRF510; TO220BV
Q5: TIP120V; TO220AV
R1, R5: 1k; AXIAL-0.1
R13, R14, R16: 220; AXIAL-0.3
R15: 4K7; AXIAL-0.3
XIN: W237-103
XOUT: W237-103

Connections:
5VM: C2.1, IC1.IN, PWRIN.4, PWROUT.4
12VA: B1.VIN, PWRIN.1, PWROUT.1
12VL: C14.1, IC5.IN, PWRIN.3, PWROUT.3
AR5V: B1.5V@1 (5V), B1.5V@2 (5V), OK1.8 (VCC), R14.P$1 (1), R16.P$1 (1)
GND: B1.GND@0 (GND), B1.GND@1 (GND), B1.GND@2 (GND), B1.GND@3 (GND), B1.GND@4 (GND), C2.2, C3.1, C14.2, C15.1, IC1.GND, IC5.GND, OK1.5 (GND), PWRIN.2, PWROUT.2, Q1.S, Q5.E, R15.P$2 (2), XOUT.1
unnamed: C1.+, C3.2, D1.C, IC1.OUT, Q1.G, R1.P$2 (2)
unnamed: C1.-, D1.A, Q1.D, R16.P$2 (2), XOUT.2
unnamed: C13.+, C15.2, D5.C, IC5.OUT
unnamed: C13.-, D5.A, Q5.C
unnamed: Q5.B, R5.P$2 (2)
unnamed: D13.A, OK1.3 (C), XIN.3
unnamed: D13.C, OK1.2 (A), R13.P$1 (1)
unnamed: R13.P$2 (2), XIN.2
unnamed: OK1.7 (VB), R15.P$1 (1)
P2: B1.2
P3: B1.3
P4: B1.4
P5: B1.5
P6: B1.6
P7: B1.7
P8: B1.8
P9: B1.9
P10: B1.10
P11: B1.11
P12: B1.12
P13: B1.13
P44: B1.44
P45: B1.45
P46: B1.46
PRX: B1.0 (0(RX0)), OK1.6 (VO), R14.P$2 (2)
PTX: B1.1 (1(TX0)), XOUT.3

Notes on the sheet:
Din4=XLR2 & Din5=XLR3
MIDI OUT
MIDIN IN
POWER
MIDI
ARDUINO
(right)
(left)
ETHERNET CONNECTORS TO ACTUATORS
A -
B -
C -
D -
A - (motors)
B - (solenoids)
PHOBOS Prototype Board V1.0
Designed by Tiago Ângelo
A project by Sonoscopia
25-04-2017

Board: 2 copper layers, 29 parts (0 on the bottom side), 16 nets, no tracks yet.
