Sonoscopia/Phobos/(commit log)

2017-03-15 Prototype board - First draft
    [Project8_1.cfg]
2017-05-27 MIDI and POWER diagram
2017-05-27 Max patch to test all ensembles and program servos
2017-05-27 added servo increment programmer
2017-05-27 reorganized folder
    [Project8_1.cfg]
2017-05-27 set relays to off state at startup
2017-05-27 updated servo programmer
    added min/max increments which relate to the servo speed
2017-05-27 minor fix
    added break after noteOn received
    [EnsembleThree.ino]
2017-05-27 added servo programmer for ensemble six
2017-05-27 added servo programmer for ensemble seven
2017-05-27 correct pin numbers according to datasheet
    [EnsembleEight.ino, EnsembleSeven.ino]
2017-05-27 correct pin output according to datasheet
    [EnsembleEight.ino]
2017-05-31 added servo programmer
2017-05-31 Ableton Tester
    [Project8_1.cfg]
2017-06-01 Fixed servo issue
    servos were continuously trying to go to 0º
    [EnsembleSix.ino]
2017-06-01 Fixed servo issue
2017-06-02 fixed servo issues
2017-06-02 callibrating through midi cc now changes the servo position on the fly
2017-06-20 changed all ensemble to MIDI channel 1
    all actuators are mapped with chromatic notes on channel 1
2017-06-20 changed servo programmer to comply with a single MIDI channel
2017-06-26 Several fixes
    note2pin array size fixes
    other minor fixes
    [EnsembleEight.ino, EnsembleFive.ino, EnsembleFour.ino, EnsembleNine.ino, EnsembleOne.ino, EnsembleSeven.ino, EnsembleSix.ino, EnsembleThree.ino]
2025-08-14 added schematics, boards and BOM's
    [EnsembleEight.brd, EnsembleEight.sch, EnsembleEight_BOM.csv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]
